Nicolboy/KICAD-C2000-powershield/doc/spec-devkit.md

# Devkit TMS320 C2000 — spécification consolidée

Remplace tous les documents de brochage antérieurs. Deux PCB à partir d'un seul
schéma, `DEVKIT_C2000_A` pour le F280037CSPM et `DEVKIT_C2000_B` pour le
F28P551SG5PM. Connecteur 2 × 28, entraxe 25,4 mm.

Les 64 broches sont attribuées et vérifiées sur les deux variantes.

**Divergence depuis le 2026-10-14 : ce document ne décrit plus que
`devkit_A_F280037`.** `devkit_B_F28P551` est passé à un connecteur
physiquement différent — deux embases 2×24 (une par domaine A/B), masse
quasi systématique en vis-à-vis de chaque signal, au lieu des deux
rangées 1×28 ci-dessous. Voir §2bis pour son brochage. Ce shield a
adopté le nouveau connecteur de devkit_B (`doc/decisions.md`, nouvelle
décision) : **devkit_A_F280037 n'est plus compatible avec ce shield**
tant qu'il n'aura pas reçu la même mise à jour — même logique de
divergence acceptée que celle déjà actée côté dépôt devkit
(`KICAD-C2000-devkit/doc/decisions.md` #13). Tout ce qui suit en §1 et §2
(hors §2bis) décrit l'ancien connecteur, toujours valable pour
devkit_A uniquement ; §3 à §8 (alimentation, JTAG, boot, LED,
mécanique) ne changent pas et s'appliquent aux deux cartes.

**Source amont pas encore mise à jour.** `KICAD-C2000-devkit/doc/
spec-devkit.md` (le dépôt d'origine) décrit encore l'ancien connecteur
2×28 pour les deux devkits — signalé ici, pas corrigé : hors périmètre
de ce dépôt.

---

## 1. Ce qui a changé depuis les premières versions

| Point | Avant | Maintenant |
|---|---|---|
| Cible | F28027 + deux 64 broches | **F280037 et F28P551 seuls** |
| Connecteur | 2 × 32, symétrique | **2 × 28, rangées symétriques** |
| Alimentation au connecteur | +3V3, +3V3_A, +5V | **+5V et masses uniquement** |
| Origine du 5 V | USB du devkit | **carte de puissance**, USB en secours |
| I2C | GPIO32 / GPIO33 | **GPIO8 / GPIO10**, mux 9 |
| Reset | bouton seul | **bouton + nRESET en B3** |
| Mode de boot | non résolu | **GPIO24 en B4**, BMSP unique par OTP |
| Voies shunt | une broche chacune | **dédoublées**, mesure + comparateur |
| LED | GPIO24 et GPIO32 | **GPIO40 et GPIO23**, communes aux deux, voir §5 |
| VREFLO | non exportée | **exportée**, paire avec VREFHI |
| Isolation, NCM3 | sur le shield | **carte de puissance** |

---

## 2. Attribution des 64 broches

### Rangée A — analogique, 1 × 28

| Pos | Signal | Broche | Canaux ADC / note |
|---|---|---|---|
| A1 | GND | 21 (VSSA) | — |
| A2 | Vin | 6 | A6 |
| A3 | Vout | 7 | B2/C6 |
| A4 | GND | — | — |
| A5 | V1 | 8 | A3/B3/C5 |
| A6 | Temp1 | 10 | A15/B9/C7 |
| A7 | GND | — | — |
| A8 | Temp2 | 11 | A14/B14/C4 |
| A9 | Iin | 12 | A11/B10/C0 |
| A10 | GND | — | — |
| A11 | Iout | 14 | A1/B7 |
| A12 | ADC_8 | 15 | A0/B15/C15 |
| A13 | GND | — | — |
| A14 | ADC_9 | 18 | A12/C1 |
| A15 | ADC_10 | 19 | A7/C3 |
| A16 | GND | — | — |
| A17 | ADC_11 | 20 | A8/B0/C11 |
| A18 | ADC_12 | 23 | A4/B8/C14 |
| A19 | GND | — | — |
| A20 | I_SHUNT1_MES | 13 | A5/B12/C2 |
| A21 | GND | — | — |
| A22 | I_SHUNT1_CMP | 9 | A2/B6/C9 - CMP1_HP0 |
| A23 | GND | — | — |
| A24 | I_SHUNT2_MES | 24 | A9/B4/C8 |
| A25 | GND | — | — |
| A26 | I_SHUNT2_CMP | 25 | A10/B1/C10 - CMP2_HP3 |
| A27 | VREF_ADC | 16 | VREFHI |
| A28 | VREFLO_SENSE | 17 | VREFLO |

Dix masses pour dix-huit signaux. **Chaque ligne de shunt est encadrée de masses
des deux côtés.** A1 rejoint VSSA (broche 21). VREF_ADC et VREFLO_SENSE forment
une paire de référence en fin de rangée.

### Rangée B — numérique, 1 × 28

| Pos | Signal | Broche | GPIO, fonction et mux |
|---|---|---|---|
| B1 | GND | 5/26/45/58 | — |
| B2 | +5V | — | — |
| B3 | nRESET | 3 | XRSn |
| B4 | BOOT_SEL | 35 | GPIO24 mux0 - BMSP1 |
| B5 | PWM1_A | 52 | GPIO0 EPWM1_A mux1 |
| B6 | PWM1_B | 51 | GPIO1 EPWM1_B mux1 |
| B7 | PWM2_A | 50 | GPIO2 EPWM2_A mux1 |
| B8 | PWM2_B | 49 | GPIO3 EPWM2_B mux1 |
| B9 | GND | — | — |
| B10 | PWM3_A | 48 | GPIO4 EPWM3_A mux1 |
| B11 | PWM3_B | 61 | GPIO5 EPWM3_B mux1 |
| B12 | PWM4_A | 64 | GPIO6 EPWM4_A mux1 |
| B13 | PWM4_B | 57 | GPIO7 EPWM4_B mux1 |
| B14 | GND | — | — |
| B15 | UART_TX | 1 | GPIO29 SCIA_TX mux1 |
| B16 | UART_RX | 2 | GPIO28 SCIA_RX mux1 |
| B17 | I2C_SCL | 47 | GPIO8 I2CA_SCL mux9 |
| B18 | I2C_SDA | 63 | GPIO10 I2CA_SDA mux9 |
| B19 | SPI_CLK | 41 | GPIO18 SPIA_CLK mux1 |
| B20 | SPI_SIMO | 33 | GPIO16 SPIA_SIMO mux1 |
| B21 | SPI_SOMI | 34 | GPIO17 SPIA_SOMI mux1 |
| B22 | SPI_STE | 42 | GPIO19 SPIA_STE mux1 |
| B23 | GND | — | — |
| B24 | CAN_TX | 29 | GPIO13 MCAN_TX mux3 |
| B25 | CAN_RX | 30 | GPIO12 MCAN_RX mux3 |
| B26 | CMP_OUT | 31 | GPIO11 OUTPUTXBAR7 mux3 |
| B27 | CLB_OUT | 56 | GPIO22 CLB_OUTPUTXBAR1 mux10 |
| B28 | GPIO_1 | 32 | GPIO33 mux0 - nFAULT |

Vingt-quatre signaux, quatre masses. Retirés par rapport à la version 24/32 :
CMP_OUT2, CLB_OUT2, GPIO_2 et GPIO_3 — les broches 62, 54, 53 et 55 deviennent
des pastilles de test. Un seul OUTPUTXBAR peut agréger plusieurs sources CMPSS,
et une sortie CLB suffit à l'observation.

### Hors connecteur

| Broche | PCB A — F280037 | PCB B — F28P551 |
|---|---|---|
| 36, 38 | TCK, TMS | idem |
| 37, 39 | TDO (GPIO37), TDI (GPIO35) | idem |
| 21 | VSSA | idem |
| 22 | VDDA 3,3 V | idem |
| 4, 44, 59 | VDD 1,2 V, découplage | idem |
| 43, 60 | VDDIO 3,3 V | idem |
| 5, 26, 45, 58 | VSS | idem |
| **27** | **VDD 1,2 V, découplage** | pastille (GPIO20) |
| **28** | **VDDIO 3,3 V** | pastille (GPIO21) |
| **40** | pastille (GPIO32) | pastille (GPIO32) |
| **46** | pastille (GPIO39) | **VREGENZ à VSS** |

Bilan : 41 broches au connecteur, 4 en JTAG, 4 en pastilles de test, plus
alimentations et LED.

---

## 2bis. `devkit_B_F28P551` seulement — nouveau connecteur, 2×24/2×24

Remplace §2 pour `devkit_B_F28P551` uniquement. Deux embases distinctes,
une par domaine, chacune 2×24 au pas 2,54 mm (entraxe 2,54 mm entre les
deux rangées d'une même embase) : **`J17` domaine A** (analogique),
**`J18` domaine B** (numérique) côté shield — mâles côté devkit, femelles
côté shield comme pour l'ancien connecteur. Même principe que les quatre
nappes shield↔cartes filles (`doc/nappes-shield.md`) : masse en
vis-à-vis de (quasiment) chaque signal, pour réduire l'inductance de
boucle — point de départ de ce changement, la rangée A ne portant plus
que six masses pour vingt-deux signaux après le routage CLB
(`KICAD-C2000-devkit/doc/decisions.md` #13).

Noms de net **identiques** à la rangée 1×28 qu'ils remplacent (`Vin_MCU`,
`PWM1_A_MCU`, `I_shunt1_MCU`, `5V_C2000`, etc.) — seules la position
physique et la répartition masse/signal changent, aucun renommage de
signal. Brochage complet et numérotation des broches KiCad :
`KICAD-C2000-devkit/doc/connecteur-v2-plan.md` (le plan d'origine) et
`lib/C2000_Devkit_Connectors.kicad_sym` (symboles `DEVKIT_C2000_A`/
`DEVKIT_C2000_B`, qui font autorité — ce `.md` ne les reproduit pas pour
éviter une troisième copie à tenir synchronisée).

**Risque non résolu, hérité du plan d'origine.** Rien n'empêche
mécaniquement d'intervertir les deux embases 2×24 d'un même domaine par
rapport à l'autre domaine (A ↔ B) — à vérifier/trancher avant tout
routage de la zone connecteur du shield.

---

## 3. Alimentation

Deux LDO 3,3 V, alimentés par le 5 V venant du connecteur ou de l'USB.

| Rail | Broches | Découplage |
|---|---|---|
| **VDDIO 3,3 V** — LDO n°1 | 43, 60 *(+28 sur PCB A)* | 100 nF par broche |
| **VDDA 3,3 V** — LDO n°2 | 22 | ≥ 2,2 µF + 100 nF |
| **VDD 1,2 V** — régulateur interne | 4, 44, 59 *(+27 sur PCB A)* | ≈ 10 µF au total, **broches reliées entre elles** |
| VREFHI / VREFLO | 16, 17 | **≥ 2,2 µF entre les deux**, au plus près |

**VDD n'est pas alimenté.** C'est la sortie du régulateur interne, à découpler
seulement. Sur le PCB B, VREGENZ (broche 46) est reliée à VSS pour activer ce
régulateur ; le F280037 en 64 PM non-Q n'a pas cette broche, son régulateur est
toujours actif.

**Pas d'OR-ing.** Deux sources possibles sur le rail 3,3 V — la sortie des LDO
depuis le +5 V de B2, et le 3,3 V entrant par le connecteur JTAG — mais aucun
arbitrage matériel : **ne pas alimenter des deux côtés à la fois**. Une Schottky
en série a été écartée, ses 0,3 V de chute amèneraient VDDIO à 3,0 V, sous le
seuil de brownout (SPRSPC5 §6.5).

**Masses** : VSS et VSSA réunies en un point unique près du boîtier, sous les
broches 21 et 26. Une seule masse au connecteur. Quatre couches recommandées,
pour un plan continu sous la zone analogique — c'est la version de référence.
Une variante 2 couches fabriquée à la maison sert au prototypage mécanique et
fonctionnel, sans prétention sur le bruit (`decisions.md` §12).

---

## 4. JTAG et reset

Embase **Tag-Connect TC2050**, 10 points au pas 1,27 mm, sans connecteur monté
côté carte. Brochage standard TI :

| Broche | Signal | Broche | Signal |
|---|---|---|---|
| 1 | GND | 6 | libre |
| 2 | TCK (36) | 7 | XRSn (3) |
| 3 | TDO (37) | 8 | libre |
| 4 | TMS (38) | 9 | libre |
| 5 | TDI (39) | 10 | VDDIO 3,3 V |

Les broches 6, 8 et 9 restent libres : la 6 porte TRSTn sur les cibles qui en
ont une, et ce composant n'en a pas.

**Ces MCU n'ont pas de broche TRSTn.** Vérifié dans SPRSPC5 §5.3 et §5.4, qui
l'écrit deux fois : « This device does not have a TRSTn pin ». Prévoir un
**rappel de 2,2 kΩ sur TMS vers VDDIO** : c'est lui qui maintient le JTAG en
reset pendant le fonctionnement normal. Ne pas reprendre le /TRST du schéma
F28027.

**Ne pas confondre TRST et nRST.** La broche 3 est XRSn, le reset du composant,
à relier au RESET du connecteur JTAG — drain ouvert, la sonde peut le tirer bas.
TRST est le reset de la chaîne JTAG, et il n'existe pas ici.

**Reset** : **cavalier 2 points au pas 2,54 mm** vers VSS sur XRSn (broche 3),
en remplacement du bouton-poussoir, avec rappel de 10 kΩ vers VDDIO et
condensateur de 100 nF vers VSS. La même broche sort en B3, attaquée **en
drain ouvert uniquement** par l'extérieur.

---

## 5. LED et sélection du boot

Les LED étaient initialement posées sur les **E/S non communes** — GPIO39 et
GPIO32 sur le PCB A, GPIO20 et GPIO21 sur le PCB B — pour que le connecteur
reste identique à 100 %. Ce placement a été abandonné : GPIO32 est l'une des
deux broches de sélection du boot et ne peut rien porter d'autre. Voir plus bas.

Les LED sont désormais **identiques sur les deux PCB**, sur deux broches
communes libérées du connecteur.

**Modes retenus : Flash seul.** Le chargement en RAM se fait par le JTAG, qui
arrête le cœur et écrit directement — il ne demande aucun mode de boot.

SPRSPC5 table 7-8, modes par défaut. Deux broches de sélection, pas une :

| Mode | GPIO24 (BMSP1) | GPIO32 (BMSP0) |
|---|---|---|
| Parallel IO | 0 | 0 |
| SCI / Wait Boot | 0 | 1 |
| CAN | 1 | 0 |
| **Flash** | **1** | **1** |

**Les deux broches demandent un rappel externe de 10 kΩ vers VDDIO.** SPRSPC5
§5.5 est formel : les rappels internes des GPIO sont désactivés au reset *et
pendant le boot*. Deux broches laissées flottantes donnent un mode de démarrage
indéterminé — et le tirage inclut Parallel IO, qui se met à piloter des broches.

Pas de cavalier : la table par défaut suffit, l'OTP n'a pas à être brûlé.
`BOOTPIN_CONFIG = 0x5AFF18FF` reste disponible si l'on veut plus tard libérer
GPIO32, mais ce n'est plus nécessaire.

### Les deux résistances de boot

| Repère | Valeur | Broche | Rôle |
|---|---|---|---|
| R3 | 10 kΩ → VDDIO | GPIO24 (35), sortie en B4 | Flash par défaut, **l'ESP32 la tire à 0** pour le boot SCI |
| R4 | 10 kΩ → VDDIO | GPIO32 (40) | fixe à 1, jamais piloté |

GPIO32 doit valoir 1 dans les deux modes utilisés — Flash `1 1` et SCI `0 1`.
C'est la seule broche des deux qui ne bouge jamais : **rien d'autre ne doit y
être connecté**, ni LED ni charge.

GPIO24 garde son rappel *et* reste pilotable depuis le connecteur : le rappel
impose Flash au repos, l'ESP32 force le boot SCI en tirant B4 à zéro. C'est le
chemin de mise à jour par liaison série décrit au §2.

**Prévoir une pastille de test sur GPIO24.** Si la Flash contient un programme
qui se plante trop tôt, c'est la seule porte de secours — une pince à la masse
et le composant repart en boot SCI.

### Les LED déménagent sur les pastilles de test

GPIO32 étant réservé au boot, et GPIO39 étant la seule autre E/S non commune du
PCB A, les deux LED sont reportées sur des broches **communes aux deux
boîtiers**, choisies parmi les quatre libérées du connecteur — celles qui ont le
moins de fonctions alternatives à sacrifier :

| Fonctions alternatives | Broche | GPIO | Affectation |
|---|---|---|---|
| 7 | 54 | GPIO23 | **LED rouge** |
| 9 | 53 | GPIO40 | **LED bleue** |
| 9 | 55 | GPIO41 | pastille de test |
| 12 | 62 | GPIO9 | pastille de test, la plus riche — à garder libre |

Les broches 53 et 54 sont contiguës, ce qui convient à une LED 3 mm à trois
broches. Conséquence utile : **les LED deviennent identiques sur les deux PCB**,
et GPIO32 comme GPIO39 sont rendus à leur rôle.

---

## 6. Mécanique

| | |
|---|---|
| Boîtier | LQFP64 PM, 10 × 10 mm corps, 12 mm hors tout |
| Empreinte KiCad | `Package_QFP:LQFP-64_10x10mm_P0.5mm` |
| Rangée A | embase mâle 1 × 28, pas 2,54 mm |
| Rangée B | embase mâle 1 × 28, pas 2,54 mm |
| **Entraxe des rangées** | **25,4 mm** (10 pas) |
| Longueur | 28 × 2,54 = 71,1 mm |
| Carte | ≈ 75 × 28 mm, 4 couches (variante 2 couches en prototype) |
| Horloge | interne, X1/X2 non câblés — GPIO18/GPIO19 libres pour le SPI |

Embases mâles sous le devkit, femelles sur le shield, pour un retrait sans
outil. Le devkit se place **au-dessus de la zone commande** du shield.

### Détrompage

Les deux rangées faisant désormais la même longueur, la géométrie n'assure plus
le détrompage. Prévoir une clé : position obturée aux extrémités, ou ergot sur
le support. Sans elle, un montage à l'envers met le +5V de B2 sur VSSA.

### Cohabitation avec l'ESP32 sur le shield

L'ESP32-C6-DevKitC-1 a ses propres cotes, relevées dans son plan d'implantation
v1.2 : **entraxe 22,86 mm**, carte 51,8 × 25,4 mm, embases J1 et J3 au pas
2,54 mm. Le 1,27 mm mentionné sur le plan concerne J2 et J4, l'empreinte du
module, sans objet ici.

Le shield porte donc **deux entraxes différents** : 25,4 mm pour le devkit C2000,
22,86 mm pour l'ESP32. Deux références de support à approvisionner, mais le
dégagement de routage autour du LQFP64 est préservé — c'est le choix retenu.

## 7. Nomenclature indicative

| Fonction | Composant |
|---|---|
| MCU | TMS320F280037CSPM ou TMS320F28P551SG5PM |
| LDO VDDIO | 3,3 V, ≥ 300 mA, faible bruit |
| LDO VDDA | 3,3 V, ≥ 100 mA, **faible bruit prioritaire** |
| OR-ing | 2 × Schottky, chute faible |
| USB | connecteur seul, alimentation de secours en développement |
| JTAG | embase Tag-Connect TC2050, 10 points, pas 1,27 mm |
| Reset | poussoir tactile + 10 kΩ + 100 nF |
| LED | 2 × 0603, résistances selon 4 mA |
| Découplage | 100 nF par broche d'alimentation, 10 µF sur VDD, 2,2 µF sur VDDA, 2,2 µF entre VREFHI et VREFLO |
| Cavalier boot | 1 × 3 points, pas 2,54 mm |

---

## 8. Points à trancher avant routage

- Valeur de VREFHI en mode externe : 2,5 V ou 3,0 V, selon la pleine échelle des
  AMC ratiométriques. Plage admissible, impédance de source et courant absorbé
  restent `à vérifier`.
- État au reset de GPIO40 et GPIO23, pour que les LED ne s'allument pas pendant
  le démarrage. Sans objet pour le boot — ces broches n'y participent plus —
  mais une LED allumée au reset se lit comme un défaut.
- Courant de sortie de GPIO40 et GPIO23 : le mode 20 mA du F28P551
  (`IO_DRVSEL`) n'est pas vérifié dans SPRSPC5, considérer 4 mA. Avec 1 kΩ sur
  la cathode commune, la LED tire environ 1,3 mA — largement dans la marge.
- Placement exact du point de jonction VSS/VSSA par rapport aux broches 21 et 26
  et à l'arrivée du +5V en B2.
- Choix de l'entraxe si vous préférez 22,86 mm : vérifier qu'il reste de la place
  pour les deux LDO, l'USB et l'embase JTAG autour d'un boîtier de 12 mm.
