Nicolboy/KICAD-C2000-powershield/doc/decisions.md

# Décisions de conception

Ce document rassemble les choix qui ont l'air d'inefficacités et n'en sont pas.
Chacun a coûté quelque chose — une broche, une piste, un composant — en échange
d'une propriété qu'on ne voulait pas perdre.

Il existe parce que ces choix sont exactement ceux qu'on « optimise » six mois
plus tard, faute de se rappeler ce qu'ils protégeaient. Chaque entrée dit donc
trois choses : la décision, sa raison, et ce qui casse si on la défait.

Ce fichier fait autorité sur les décisions. Le brochage, lui, est décrit dans
[`spec-devkit.md`](spec-devkit.md), les nappes dans
[`nappes-shield.md`](nappes-shield.md).

---

## 1. Le connecteur est identique sur les deux MCU, et ça se paie

**Décision.** Les deux devkits, F280037 et F28P551, exposent le même connecteur
— 56 positions sur 56. Pour y parvenir, les LED sont posées sur les
entrées/sorties **non communes** aux deux boîtiers.

**Pourquoi.** Poser une LED est le besoin le plus trivial de la carte ; c'est
donc lui qu'on sacrifie. En le reléguant sur les broches qui divergent, on
libère toutes les broches communes pour ce qui traverse le connecteur. Le shield
devient indifférent au MCU monté dessus.

**Ce qui casse.** Déplacer une LED sur une broche commune la retire du domaine
partagé et rompt l'interchangeabilité. Il faudrait alors deux shields.

Les quatre divergences, toutes locales à la carte devkit :

| Broche | F280037 | F28P551 |
|---|---|---|
| 27 | VDD 1,2 V, découplage | LED bleue (GPIO20) |
| 28 | VDDIO 3,3 V | LED rouge (GPIO21) |
| 40 | LED rouge (GPIO32) | pastille de test |
| 46 | LED bleue (GPIO39) | VREGENZ à VSS |

La cause profonde est le régulateur 1,2 V : le F28P551 a le sien en interne,
activé par VREGENZ à VSS ; le F280037 en 64 PM non-Q n'a pas cette broche et
demande un LDO supplémentaire. **Toute divergence hors de cette liste est une
erreur.**

---

## 2. PWM3 et PWM4 restent en réserve, et restent des PWM

**Décision.** Les positions B10 à B13 portent `PWM3_A/B` et `PWM4_A/B`, câblées
de bout en bout sur la nappe PWM alors que rien ne s'en sert encore.

**Pourquoi.** Ce sont les deux seules paires complémentaires HRPWM avec temps
mort matériel encore disponibles. La nappe PWM est aussi la seule à alternance
signal/masse pensée pour des fronts rapides — un PWM posé ailleurs n'aurait pas
le même environnement.

**Ce qui casse.** Les réaffecter à une commande lente sous prétexte qu'elles
sont libres consomme une ressource rare pour un besoin que n'importe quel GPIO
satisfait. Les commandes lentes du shield — `Stage1_EN`, `Stage2_EN`, `HV_EN`,
`Discharge` — ont leur propre nappe GPIO, faite pour elles.

---

## 3. Alternance signal / masse stricte 1:1 sur les quatre nappes

**Décision.** Un conducteur sur deux est une masse, sur les quatre nappes. Aucune
ligne d'alimentation ne circule dedans.

**Pourquoi.** C'est de la mesure de courant. Le retour de chaque signal longe le
signal lui-même, la boucle reste petite, la diaphonie s'effondre.

**Ce qui casse.** Récupérer une masse pour y passer un signal de plus donne un
conducteur gratuit et une mesure qui dérive sans qu'on sache pourquoi.

**Exception, voulue.** `VREF_ADC` et `VREFLO_SENSE` sont **adjacents** — A27/A28
au connecteur, positions 6 et 7 de la nappe ADC-2. C'est une paire de référence,
pas deux signaux indépendants : la conversion est ramenée à
(VIN − VREFLO) / (VREFHI − VREFLO). Les séparer par une masse rendrait la mesure
différentielle fausse au lieu de la protéger.

C'est aussi la raison pour laquelle le **+5 V a son propre connecteur**. Les
500 mA de la commande n'ont pas à partager leur retour avec les masses de
référence des voies ADC : c'était précisément le mécanisme d'erreur à éviter.

---

## 4. Chaque shunt sort deux fois : `_MES` filtré, `_CMP` direct

**Décision.** La sortie de chaque AMC0300R est reprise deux fois sur le shield.
Un chemin filtré vers la voie de mesure, un chemin direct vers le comparateur.

**Pourquoi.** Le chemin `_CMP` attaque le CMPSS sans filtre anti-repliement : la
Trip Zone se déclenche sans le retard qu'introduirait le filtre. Et les deux
chemins étant indépendants, un défaut sur le filtre ne désarme pas la
protection.

**Ce qui casse.** Fusionner les deux chemins, ou insérer un filtre sur `_CMP`,
remet le retard dans la boucle de protection et recrée le point de défaillance
unique. Contrainte à respecter : Rs ≤ 50 Ω sur le chemin comparateur.

| Voie | Broche | CMPSS | Rôle |
|---|---|---|---|
| `I_SHUNT1_CMP` | 9 | CMP1_HP0 | seuil DAC interne → Trip Zone, sans filtre |
| `I_SHUNT1_MES` | 13 | — | mesure ADC, filtrée |
| `I_SHUNT2_CMP` | 25 | CMP2_HP3 | chemin direct |
| `I_SHUNT2_MES` | 24 | — | mesure ADC, filtrée |

---

## 5. Les 16 voies ADC sortent toutes, pour 9 nécessaires

**Décision.** Toutes les voies ADC du boîtier sont exportées. Les cinq libres —
A12, A14, A15, A17, A18 — sont câblées jusqu'aux cinq réserves de la nappe
ADC-2, dans le même ordre.

**Pourquoi.** Une voie de mesure ajoutée plus tard se raccorde de bout en bout
sans retoucher une seule carte. La marge est volontaire et son coût est nul :
ces broches ne servaient à rien d'autre.

**Ce qui casse.** « Récupérer » ces positions pour autre chose économise cinq
pistes et transforme le moindre ajout de mesure en nouvelle révision des trois
cartes.

---

## 6. nRESET en drain ouvert uniquement

**Décision.** La ligne `nRESET` (B3) n'est jamais attaquée en push-pull depuis
le shield.

**Pourquoi.** Le MCU tire lui-même cette ligne à zéro sur watchdog et sur
brownout. C'est une ligne à plusieurs maîtres.

**Ce qui casse.** Une sortie push-pull côté shield met en conflit deux étages
lorsque le MCU se réinitialise — courant de court-circuit, et un reset qui
n'aboutit pas.

---

## 7. Point de jonction VSS/VSSA unique

**Décision.** Les masses numérique et analogique se rejoignent en **un seul
point**, près du boîtier, et une seule masse remonte au connecteur.

**Pourquoi.** Deux jonctions créent une boucle, et la boucle capte.

---

## 8. `GND` et `+5V` en `power_in`, avec un `PWR_FLAG` par net

**Décision.** Les broches d'alimentation du connecteur gardent le type
électrique `power_in`, et chaque net porte un `PWR_FLAG`.

**Pourquoi.** Le connecteur alimente bien la carte, mais c'est le brochage qui
fait autorité et il les décrit en entrée. Un net composé uniquement de
`power_in` fait lever `power_pin_not_driven` à l'ERC, même avec un symbole de
masse dessus : le `PWR_FLAG` répond à ça sans toucher au type électrique.

**Ce qui casse.** Passer les broches en `power_out` fait taire l'ERC en mentant
sur la nature du connecteur. C'est la documentation qu'on dégrade pour obtenir
un rapport propre.

---

## 9. Le shield s'édite à la main, les devkits se régénèrent

**Décision.** Les trois schémas n'ont pas le même statut, et il faut le savoir
avant d'ouvrir KiCad :

| Schéma | Édition |
|---|---|
| `devkit_A_F280037.kicad_sch` | **jetable** — reconstruit par `gen_devkit.py` |
| `devkit_B_F28P551.kicad_sch` | **jetable** — idem |
| `shield.kicad_sch` | **édité à la main**, c'est le fichier de travail |

**Pourquoi.** Le générateur du shield amenait à la ligne de départ — connecteurs
posés, alimentations câblées, un `PWR_FLAG` par net — puis s'arrêtait : le
routage des signaux demande des choix de conception qui n'appartiennent pas à un
script. Ce travail commence maintenant, et il se fait dans KiCad.

`gen_shield.py` a donc été **retiré du dépôt**. Il écrivait `shield.kicad_sch`
en entier et l'aurait écrasé au premier `--force`, sans avertissement. Un
amorçage à usage unique qui traîne dans l'arborescence est un piège, pas un
outil. Il reste dans l'historique git (commit `31ecd50`) si l'on veut repartir
d'une feuille blanche.

**Ce qui casse.** Retoucher un schéma de devkit à la main : la modification
disparaît au prochain `gen_devkit.py --force`. Ce qui doit survivre se modifie
dans `src/` ou dans le générateur.

---

## 10. Les schémas source des devkits sont versionnés dans `src/`

**Décision.** `src/devkit_c2000_A_F280037.kicad_sch` et son homologue B sont
suivis par git. `imports/` reste la boîte de réception, ignorée.

**Pourquoi.** `gen_devkit.py` ne fabrique pas ces schémas : il les recopie et
les retouche — nom de projet, symbole MCU carré, recalage sur la grille de
1,27 mm. La vraie source, c'était donc un dossier non versionné. Un dépôt dont
l'argument est que tout se régénère depuis une source ne peut pas laisser cette
source hors de lui-même.

**Ce qui casse.** Remettre `PROJECTS` sur `imports/` : le jour où ce dossier
disparaît, les deux devkits ne sont plus régénérables et rien ne le signale
avant qu'on essaie.

---

## 11. Deux rangées égales de 28, et une clé mécanique obligatoire

**Décision.** Le connecteur fait 28 + 28, pas 24 + 32. Quatre signaux ont été
retirés pour que les deux rangées tiennent : `CMP_OUT2`, `CLB_OUT2`, `GPIO_2` et
`GPIO_3`. Les broches MCU correspondantes — 62, 54, 53 et 55 — deviennent des
pastilles de test. `CMP_OUT1` et `CLB_OUT1` perdent leur indice.

**Pourquoi.** Deux rangées identiques, c'est un seul type de support, une seule
référence à approvisionner, et un dessin de carte symétrique.

**Ce qui casse — et c'est le point à ne pas oublier.** L'asymétrie 24/32
assurait le détrompage toute seule : une rangée de 24 n'entre pas dans un
support de 32. Ce n'est plus le cas. **Il faut une clé mécanique explicite** —
position obturée aux extrémités, ou ergot sur le support. Sans elle, une carte
branchée à l'envers met le +5 V de B2 sur une entrée analogique.

C'est la contrainte la plus facile à oublier et la plus coûteuse à découvrir
après fabrication.

**Trace.** Le basculement date du 2026-08-30, vers 15 h 25. `doc/spec-devkit.md`
a été recalé depuis `lib/C2000_Devkit_Connectors.kicad_sym` — qui faisait
seule autorité pendant l'intervalle — et vérifié position par position, 56 sur
56.

---

## 12. Deux versions de PCB : 2 couches maison, 4 couches externes

**Décision.** Chaque carte est dessinée en deux variantes de fabrication :

| | 2 couches | 4 couches |
|---|---|---|
| Fabrication | maison | externe |
| Pistes mini | 1 mm | au choix du fabricant |
| Vias | 2 mm, perçage 0,8 mm | standard |
| Plan de masse | fragmenté, au mieux | **continu en couche 2** |
| Statut | prototype, mise au point | version de référence |

**Pourquoi.** La version maison permet d'itérer en quelques heures au lieu de
quelques semaines, et de valider la mécanique — encombrements, entraxes,
détrompage — avant d'engager un tirage externe.

**Ce qui ne change pas d'une version à l'autre.** Le schéma, le brochage, le
connecteur. Les deux variantes sortent du **même `.kicad_sch`** : seule la
géométrie du PCB diffère. Dès qu'un signal change d'une version à l'autre, ce
ne sont plus deux variantes mais deux cartes, et la comparaison des mesures ne
veut plus rien dire.

**Ce qu'il faut savoir de la version 2 couches.** Sans plan de masse continu
sous la zone analogique, les retours de courant partagent des chemins et la
mesure en pâtit — c'est l'objet même de la décision §3. Attendre d'elle une
validation fonctionnelle et mécanique, **pas** une caractérisation en bruit ni
un chiffre de précision : ils ne se transposeraient pas à la version 4 couches.

**Conséquence sur l'outillage.** Les règles de conception écrites par
`kicad_gen.py` — piste 1 mm, via 2 mm, perçage 0,8 mm — sont celles de la
fabrication maison. Le projet 4 couches demandera son propre jeu de règles, bien
plus fin. Ne pas appliquer les contraintes maison à la version externe : ce
serait payer un fabricant pour des pistes de 1 mm.

---

## 13. La conversion isolée migre sur le shield, deux NCM3S1205MC séparés, masses secondaires reliées en un point

**Décision.** La carte de puissance séparée (qui portait toute la
conversion et toute l'isolation dans `KICAD-C2000-devkit`) disparaît. Le shield
reçoit directement le 11-25V externe et produit ses propres rails isolés.
Chaque carte DC/DC enfichable porte désormais l'isolation que *sa* fonction
exige — plus de point central qui isole pour tout le monde.

**Pourquoi.** Décision de conception de l'utilisateur, pas une optimisation
de ma part : la carte de puissance figée ne convenait qu'à une seule
fonction de conversion ; des cartes DC/DC enfichables, chacune avec son
isolation propre, couvrent plusieurs fonctions sans redessiner le shield à
chaque fois.

**Composant retenu : NCM3S1205MC-R7** (Murata NCM3 series,
`composants-datasheets/datasheets/isolation/KDC_NCM3.pdf` p.1) — entrée
9-36V (couvre 11-25V), sortie 5V/600mA max (3W), isolation 5000VAC
renforcée. Écarté avant lui : l'OKI-78SR (titre du datasheet : *"Non-Isolated
Switching Regulator DC-DC"*, masses Vin/Vout communes) — ne fait pas ce
qu'on lui demandait.

**Deux exemplaires, pas un seul partagé.** Un NCM3S1205MC pour le domaine
"numérique" (les deux devkits + l'OLED), un second dédié au domaine
"isolation E/S" (LDO 3,3V vers les nappes). Objectif : ne pas coupler le
bruit du CPU/de la radio Wi-Fi de l'ESP32 sur l'alimentation de
l'isolation, et donner à chaque domaine son propre budget de 600mA plutôt
qu'un budget unique partagé entre tout le monde.

**Coupure par destination — trois cavaliers, pas un.** Cavalier C2000,
cavalier ESP32, cavalier E/S — chacun 2 points 2,54mm, côté régulé (5V ou
3,3V), en aval de leur module. Le 11-25V brut reste toujours présent aux
deux NCM3S1205MC, non coupé : avec le module #1 partagé entre les deux
devkits, une coupure individuelle n'a de sens que côté régulé.

**Masses secondaires des deux NCM3S1205MC : reliées, en un point unique —
pas laissées séparées.** Premier réflexe (le mien), corrigé par
l'utilisateur : séparer les deux masses semblait cohérent avec la
séparation de bruit visée par les deux modules, mais le 3V3_ISO alimente le
côté **commande/non-isolé** des isolateurs des cartes DC/DC — c'est ce
côté-là que le C2000 doit pouvoir lire avec une référence commune, sinon le
signal de sortie de l'isolateur n'a plus de référence valable une fois relu
côté numérique. L'isolation galvanique réelle se fait à l'intérieur de
chaque puce isolatrice (AMC03xx etc.), pas entre les deux domaines du
shield. Un point unique (étoile), pas deux jonctions séparées : même
principe que le point de jonction VSS/VSSA unique déjà utilisé sur les
devkits — deux jonctions créeraient une boucle de masse.

**3V3_ISO reste un LDO fixe simple, pas asservi à VDDA/VREF.** Idée
soulevée puis écartée : faire porter la précision ADC des cartes DC/DC par
l'alimentation de l'isolateur plutôt que par sa référence. Un LDO (±1-2%
typique) n'a pas la stabilité d'une vraie référence — ce n'est pas le bon
outil. La vraie solution, déjà disponible sans rien ajouter : les
isolateurs ratiométriques (suffixe "R", type AMC0311R/AMC0302R) ont une
broche REFIN dédiée, à raccorder sur VREF_ADC (déjà présent sur la nappe
ADC-2) — pas sur 3V3_ISO. Protection de sortie prévue malgré tout : une
zener entre 3V3_ISO et masse, en crowbar contre une panne du LDO
(pass-transistor qui lâche et laisse passer le 5V d'entrée vers la sortie —
mode de panne déjà vécu), pas de l'ESD générique.

**2×10 IDC, pas 2×8 breakaway.** Les quatre nappes doivent désormais porter
GND + 3V3_ISO en plus de leurs 16 positions existantes (inchangées). Les
embases IDC à sertir avec détrompeur existent en tailles standard de nappe
(10/14/16/20/26/34 voies) ; 2×9 (18 voies, le minimum strict) n'en est pas
une, 2×10 l'est — et laisse une réserve gratuite, cohérent avec la décision
#5 déjà actée (marge ADC gratuite).

**Ce qui casse.** Relier les masses des deux NCM3S1205MC en plusieurs
points (pas un seul) réintroduit une boucle de masse — c'est précisément
ce que la décision #7 (point de jonction unique) existe pour éviter, ici
appliqué au même problème à un autre endroit du schéma. Asservir 3V3_ISO à
VDDA/VREF pour « résoudre » la précision ADC masque le vrai problème
(REFIN mal câblé sur la carte DC/DC) sans le résoudre, et dégrade la
stabilité du rail d'alimentation de l'isolation pour tout le monde.

## 14. GND/3V3_ISO des nappes en positions 1/2 (pas 17/18), et correction d'un bug de signe Y sur les labels de connecteur

**Décision.** Sur les 4 nappes, `3V3_ISO` passe en position 1 et `GND` en
position 2 (au lieu de 17/18, ajoutées en fin par la décision #13). Les 16
positions signal/masse existantes, inchangées de nom, se décalent
mécaniquement de 2 crans (ancienne position *n* → nouvelle position *n+2*).
Les anciennes positions 17/18 disparaissent, leur rôle repris par les
nouvelles 1/2.

**Pourquoi.** Décision explicite de l'utilisateur, pas une optimisation de
ma part : il a fourni l'image d'un connecteur de référence (`CpuOut1` /
`CTRL_C2000_OUT`, dans `alim-flyback-filament/isolation.kicad_sch` — projet
routé, prêt pour production, lu mais jamais édité) où les deux broches
d'alimentation (`3V3_CTRL`, `GND_CTRL`) occupent les positions 1 et 2,
avant tout signal. Convention à reprendre pour les nappes du shield plutôt
que l'ajout en fin de connecteur retenu dans la décision #13.

**Bug de signe Y trouvé en vérifiant la connexion des labels.** En
positionnant les labels des broches BAT54S ajoutées aujourd'hui, l'ERC a
révélé qu'aucun label de connecteur posé plus tôt dans la session
(nappes, rangées A/B devkit C2000, J1/J3 ESP32) ne touchait réellement sa
broche. KiCad inverse l'axe Y entre les coordonnées locales d'un symbole
(bibliothèque, Y vers le haut) et son placement sur le schéma (Y vers le
bas) : la formule correcte est `monde_y = instance_y − local_y` (le signe
d'addition que j'utilisais était faux), `monde_x = instance_x + local_x`
reste correct. Confirmé en comparant mes positions aux coordonnées réelles
que `kicad-cli sch erc` rapporte pour chaque broche (ex. BAT54S D11 Pin 3,
réellement à (250.00, 11.11) contre (250.00, 28.89) avant correction).
Labels régénérés sur `connecteurs_nappe.kicad_sch` et
`connecteur_devkit.kicad_sch` avec la formule corrigée et le style du
connecteur de référence (`shape bidirectional`, `rotation 180`,
`justify right`), uniformément.

**Ce qui casse.** Toute nouvelle génération de labels sur un connecteur
dans ce dépôt doit utiliser `monde_y = instance_y − local_y`, pas l'inverse
— le bug est facile à reproduire car `kicad-cli sch erc` ne le signale
que comme `label_dangling`/`pin_not_connected` (pas une erreur explicite
de coordonnées), à vérifier systématiquement en croisant quelques broches
avec les coordonnées réelles du rapport ERC avant de considérer un lot de
labels comme posé.

---

## 15. Embase OLED en IDC 2 × 8 détrompée, empreintes assignées à tout le projet

**Décision.** Ajout du connecteur `OLED_SPI_2x8` (J10) sur
`connecteur_devkit.kicad_sch` : IDC 2 × 8 à sertir, détrompeur de série,
même famille que les nappes DC/DC mais une taille en dessous (16 broches
contre 20). Brochage repris tel quel du plan constructeur de l'écran
`ER-OLEDM032-1B` (voir `nappes-shield.md`) ; les labels `OLED_CS/RST/DC/
SCK/MOSI` existaient déjà sur les broches natives SPI de l'ESP32, seule
l'embase physique manquait. Broche 7 non étiquetée sur le plan constructeur
fourni : laissée en `NC` par prudence plutôt que supposée masse — à
reconfirmer si le datasheet complet devient disponible.

**Mise à jour.** Broche 7 reliée à `GND` (label global posé sur la broche,
exactement comme la broche 8 adjacente) — décision explicite de
l'utilisateur, plus un point ouvert. `no_connect_connected` apparaît
désormais dans l'ERC pour cette broche (la pin reste typée `NC` dans le
symbole `OLED_SPI_2x8`) : avertissement attendu, accepté au même titre que
les autres de cette famille, pas une erreur à corriger.

À la même occasion, assignation d'une empreinte à tous les composants du
projet qui n'en avaient pas (R/C en 0805, BAT54S en SOT-23, connecteurs
2 broches génériques — cavaliers et alimentation — en PinHeader 1×02,
zener de protection en SMC), et création de l'empreinte custom
`lib/NCM3S1205MC.kicad_mod` d'après les cotes du datasheet Murata
(page « Recommended Footprint Details »), ce module n'ayant pas
d'empreinte standard dans les bibliothèques KiCad.

**Pourquoi.** L'export vers le PCB échouait sur tous les composants
(« empreinte non assignée ») : aucune empreinte n'avait encore été choisie
pour ce premier passage PCB, en dehors des connecteurs devkit/ESP32/nappe
qui en portaient déjà une par défaut dans leur symbole.

**Ce qui casse.** Les cotes du NCM3S1205MC comportent une ambiguïté : les
deux sous-cotes horizontales (8,00 / 8,50 mm, barrière d'isolement) ne se
recoupent pas proprement avec la cote totale de 22,00 mm à partir de
l'image seule. Le placement des 4 pastilles utilise uniquement la largeur
totale et la largeur de pastille (valeurs non ambiguës) ; la barrière
d'isolement n'est qu'une zone de sérigraphie, sans effet électrique. À
vérifier visuellement dans l'éditeur d'empreinte PCB contre la page 10 du
datasheet avant fabrication.

---

## 16. Filtre EMC NCM3S1205MC : étage d'entrée posé, étage de sortie volontairement omis

**Décision.** Sur `dc.kicad_sch`, ajout de l'étage d'entrée du filtre EMC
recommandé par le datasheet (p.8, « EMC Filtering and Spectra ») pour
chaque instance : L1/L2 (22 µH, série sur VIN_PWR/retour) + C26/C27
(22 µF) + C28 (220 pF) pour U2, L3/L4 + C31/C32 + C33 pour U3 — composants
caractérisés dans `composants-datasheets/data/shield-power/ncm3s1205mc.yaml`
(`recommended_components`). L'étage de sortie (C4/C5, 470 pF, un par
instance soit C29/C30 et C34/C35) a été posé puis retiré : ni ces deux
paires de composants ni leurs labels ne figurent dans le schéma final.

**Pourquoi.** Le NCM3S1205MC est choisi spécifiquement pour sa faible
capacité d'entrée/sortie — paramètre déterminant pour une alimentation
isolée destinée à des lignes qui traversent la barrière. Rajouter 470 pF
en parallèle côté sortie va à l'encontre de ce choix, même si ces deux
condensateurs ne pontent pas la barrière primaire/secondaire (vérifié par
coordonnées : C29/C30 sont posés entre `5V_ISO` et `GND`, C34/C35 entre
`5V_NUM` et `GND`, tous deux cote secondaire uniquement — donc sans effet
sur la capacité primaire/secondaire proprement dite, mais la décision
porte sur le principe, pas seulement sur la topologie).

**Ce qui casse.** Le datasheet qualifie ces 470 pF comme faisant partie du
filtre EMC nécessaire pour la conformité EN 55032 Classe B — leur absence
n'a pas été compensée par une autre topologie. Si une non-conformité EMC
apparaît en essai, ce point est le premier candidat à rouvrir, en
réévaluant alors le compromis capacité/conformité plutôt qu'en les
rajoutant par défaut.

---

## 17. Routage des quatre nappes, reséquencement signal/masse, et deux nappes supplémentaires (GPIO-2, COM)

**Décision.** Les connecteurs J1-J4 (ADC-1, ADC-2, PWM, GPIO) n'avaient
jusqu'ici que leurs broches d'alimentation câblées (`3V3_ISO`/`GND` —
vérifié : exactement 40 `global_label` dans `connecteurs_nappe.kicad_sch`,
10 par connecteur, zéro signal réel). Cette décision couvre trois choses à
la fois : (a) le câblage des signaux restés en souffrance depuis la
decision #9, (b) un changement de convention de position qui gagne une
broche signal par connecteur sans changer sa taille, (c) l'ajout de deux
connecteurs pour couvrir les besoins génériques (logique de réserve, bus
de communication) annoncés par l'utilisateur mais absents des quatre
nappes d'origine.

**(a) Câblage.** Chaque broche signal de J1-J4 reçoit maintenant le
`global_label` que la documentation promettait depuis la decision #13
(`Vin`, `PWM1_A`, `Stage1_EN`, etc.) — toujours aucune ligne de wire,
uniquement des labels posés aux coordonnées réelles de chaque broche
(vérifié par `kicad-cli sch erc`, piège d'inversion d'axe Y de la decision
#14 surveillé).

**(b) Reséquencement signal (impair) / masse (pair), à partir de la
broche 3.** Avant : position 1 `3V3_ISO`, 2 `GND`, 3 `GND` (deuxième masse
consécutive), puis alternance à partir de 4 — 8 emplacements signal
exploitables sur 20 broches, les positions 19/20 jamais définies. Après :
position 1 `3V3_ISO`, 2 `GND`, puis strictement signal sur les impairs (3,
5, 7… 19) et masse sur les pairs (4, 6… 20) — 9 emplacements signal, les
20 broches toutes définies. Exception volontaire, déjà actée (decision
#3) : la paire de référence `VREF_ADC`/`VREFLO_SENSE` (ADC-2) reste
adjacente, en 7/8, la position 8 cédant sa masse pour cette seule paire.

**Pourquoi reséquencer plutôt qu'agrandir le connecteur.** Mon premier jet
proposait un connecteur 2×13 (26 voies, palier standard suivant) pour
donner de la marge à GPIO et à un nouveau connecteur de bus. Écarté par
l'utilisateur : pas de 2×13 en stock, tout doit rester en 2×10. Le
reséquencement donne la même marge (une broche signal de plus par
connecteur) sans changer de référence de connecteur.

**(c) Deux connecteurs de plus plutôt qu'un connecteur agrandi : GPIO-1 /
GPIO-2, et COM.** But générique annoncé par l'utilisateur : le devkit+
shield doit pouvoir piloter n'importe quelle carte fille future (PWM,
logique, ADC, bus I2C/SPI/UART/CAN/Modbus), pas seulement les deux cartes
connues aujourd'hui (convertisseur 0-500V, `alim-flyback-filament`). Deux
besoins non couverts par les quatre nappes d'origine :

- **Logique de réserve.** GPIO (renommé GPIO-1) est désormais plein — 8
  signaux d'origine + `CLB_OUT` (broche B27 du connecteur devkit,
  orpheline jusqu'ici, aucune nappe ne l'exportait) = 9 emplacements sur
  9. Une carte future dont le besoin en E/S logique ne ressemble à rien
  d'anticipé ici n'a nulle part où se brancher sans **GPIO-2**, un
  sixième connecteur 2×10 entièrement en réserve.
- **Bus de communication.** `UART_TX`/`RX`, `SPI_CLK`/`SIMO`/`SOMI`/`STE`,
  `CAN_TX`/`RX` existent déjà comme `global_label` sur le connecteur
  devkit (`connecteur_devkit.kicad_sch`) mais n'étaient câblés sur aucune
  nappe — **COM**, cinquième connecteur neuf, les expose en logique 3,3V
  brute (8 signaux, 1 réserve). Les transceivers CAN et RS-485/Modbus
  restent sur la carte fille qui en a besoin (décision de l'utilisateur,
  cohérente avec la decision #13 : chaque carte porte l'isolation que *sa*
  fonction exige) — le shield ne route jamais de différentiel.

**Une carte fille ne peuple que les connecteurs dont elle a besoin.**
Précision explicite de l'utilisateur : les six connecteurs ne sont pas un
paquet tout-ou-rien. Exemple immédiat : le convertisseur 0-500V utilise
ADC-1, ADC-2, PWM en entier et seulement GPIO-1 — ni GPIO-2, ni COM. Un
connecteur non peuplé côté carte fille ne coûte rien côté shield.

**Désignateurs J13/J14, pas J5/J6.** `used_designators` dans
`shield.kicad_pro` réservait déjà J1-J9 et J11-J12 (connecteurs devkit,
ESP32, OLED J10, alimentation) avant même de toucher à ce fichier —
confirmé par une recherche `property "Reference" "J\d+"` sur tous les
schémas du projet. GPIO-2 et COM prennent J13 et J14 pour ne pas entrer en
collision avec un composant existant ailleurs dans le projet.

**Bibliothèque externe synchronisée.** `lib/C2000_Devkit_Connectors.kicad_sym`
mis à jour en parallèle de la copie embarquée dans
`connecteurs_nappe.kicad_sch` (symboles `NAPPE_ADC1`/`ADC2`/`PWM` avec le
nouveau séquencement, `NAPPE_GPIO` renommé `NAPPE_GPIO1`, `NAPPE_GPIO2` et
`NAPPE_COM` ajoutés) — sinon `kicad-cli sch erc` lève `lib_symbol_issues`
(symbole introuvable en bibliothèque), et toute « Update Symbols from
Library » future écraserait silencieusement le travail de cette décision.

**Ce qui casse.** Reproduire le reséquencement sur un connecteur qui
n'existe pas encore sans relire cette décision referait l'erreur
d'origine (masse en double avant le premier signal). Ajouter un signal à
GPIO-1 ou à COM sans vérifier qu'une réserve existe déjà (`réserve
GPIO2-*`/`réserve COM-1`) revalide une nouvelle révision du connecteur au
lieu de consommer la marge déjà prévue.

**Point relevé, non résolu ici — hors périmètre.** `Stage1_EN`,
`Stage2_EN`, `HV_EN` et `Discharge` (GPIO-1) ne sont reliés à aucune
broche du connecteur devkit : ces noms viennent de l'ancien firmware
TMS320F28027 (GPIO16/17/32/5), et la nouvelle carte de conversion 0-500V
— nouveau MCU, projet séparé — n'a pas encore choisi ses broches. ERC :
`isolated_pin_label` sur les quatre, attendu, à lever quand ce choix sera
fait. De même, les réserves ADC (`ADC_8` à `ADC_12` côté connecteur
devkit) restent elles aussi isolées, un gap pré-existant à cette session.

---

## 18. Découplage 100 nF sur chacune des six nappes

**Décision.** Un condensateur 100 nF entre `3V3_ISO` et `GND`, posé au
plus près de chaque connecteur de nappe (`C29`/`C30`/`C34`/`C35`/`C42`/
`C43` pour J1/J2/J3/J4/J13/J14) — en plus du découplage par IC déjà en
place, pas à sa place.

**Pourquoi un découplage aux deux bouts.** Chaque carte fille découple
déjà ses propres IC (règle déjà en place dans cet atelier). Côté shield,
un bypass à chaque sortie de nappe — plutôt qu'un seul point au LDO —
limite qu'une carte bruyante sur une nappe (ex. un transceiver CAN sur
COM) ne remonte sur `3V3_ISO` et ne perturbe une carte sensible sur une
autre nappe (ADC-1/ADC-2) : même logique que la séparation déjà faite en
decision #13 entre les deux domaines d'alimentation (numérique vs
isolation E/S).

**Valeur.** 100 nF, pas 1 µF ni 10 µF : `3V3_ISO` n'alimente que le côté
commande/non-isolé des isolateurs des cartes filles (decision #13), pas
un étage de puissance — dizaines de mA par carte, pas d'ampères. Un bulk
plus généreux côté carte fille (hors périmètre du shield) reste
pertinent si une carte précise tire plus que ça ; pas justifié par
défaut ici.

**Ce qui casse.** Centraliser le découplage à un seul point (LDO
uniquement) réintroduit le risque de couplage inter-cartes que ce choix
évite. Monter à 1 µF ou plus sans carte fille connue identifiant un
besoin réel serait du surdimensionnement sans raison.

---

## 19. Correction du brochage ADC-2, et protection des 11 signaux nappe nouvellement câblés

**Décision.** Deux problèmes trouvés en relisant le travail de la
decision #17 après coup.

**(a) ADC-2 oubliait `I_SHUNT1_CMP`/`I_SHUNT2_CMP`.** Seule la voie
filtrée (`I_shunt1`/`I_shunt2`, chemin `_MES`) avait été câblée ; la
decision #4 impose pourtant que chaque shunt sorte **deux fois** — un
second chemin, direct et sans filtre, vers le comparateur CMPSS. Les deux
signaux manquants existaient déjà, isolés, au connecteur devkit (ERC :
`isolated_pin_label`). Corrigé en consommant 2 des 6 réserves d'ADC-2
(réserves : 6 → 4), sans les coller à `I_shunt1`/`I_shunt2` : les deux
chemins doivent rester électriquement indépendants, l'adjacence sur le
connecteur n'aide à rien et mélange visuellement ce qui ne doit pas se
confondre — contrairement à l'exception `VREF_ADC`/`VREFLO_SENSE`, qui
est une vraie paire de référence.

**(b) 11 signaux câblés en decision #17 n'avaient aucune protection**,
alors que tout le reste du connecteur devkit en a une. Vérifié en
comparant chaque signal de nappe à son équivalent `_MCU` dans les trois
feuilles de protection existantes (23 trios BAT54S + R + 100 pF, un par
signal, déjà en place avant la decision #17) : `CLB_OUT`, `UART_TX`,
`UART_RX`, `SPI_CLK`, `SPI_SIMO`, `SPI_SOMI`, `SPI_STE`, `CAN_TX`,
`CAN_RX` n'avaient aucun trio, et les deux signaux du point (a) non plus
une fois ajoutés.

**Nouvelle feuille `protection_nappe.kicad_sch`**, 11 trios, copiés
composant par composant et label par label depuis un trio réel
(`protection_devkit3.kicad_sch`, le plus petit des trois feuilles
existantes) plutôt que redessinés — même principe que
`KICAD-EDITION-GROUPEE-KIPY.md` §1 (extraire le gabarit, pas le
re-deviner). Topologie identique partout : BAT54S (clamp vers `GND`/
`3V3_PROT`) + R série + C 100 pF shunt vers `GND`, entre le nom brut
côté nappe et son équivalent `_MCU` côté connecteur devkit — **9 des 11
avec R = 100 Ω** (identique aux 23 trios déjà posés), **`I_SHUNT1_CMP`/
`I_SHUNT2_CMP` avec R = 22 Ω** : la decision #4 impose Rs ≤ 50 Ω sur ce
chemin, que 100 Ω dépasserait. Le condensateur est conservé malgré la
contrainte « sans filtre » de la decision #4 — décision explicite de
l'utilisateur, pas une optimisation de ma part : avec R = 22 Ω, le pôle
RC du 100 pF tombe à 2,2 ns (au lieu de 10 ns avec 100 Ω), soit ~7 % du
budget Trip Zone de 30 ns, jugé acceptable plutôt que de retirer le C.

**Chaque connecteur devkit protégé doit porter le nom `_MCU`, pas le nom
brut.** Conséquence directe de la convention déjà en place sur les 23
trios existants (`Vin` côté nappe → trio → `Vin_MCU` côté connecteur
devkit, jamais l'inverse) : avant d'ajouter un trio pour un signal,
son label au connecteur devkit (`connecteur_devkit.kicad_sch`) doit
d'abord passer du nom brut au nom `_MCU` — sinon le trio protège un
signal qui ne va nulle part. Fait pour les 9 signaux du point (b)
(`CLB_OUT_MCU`, `UART_TX_MCU`, etc.).

**Erratum (même session) : le renommage ci-dessus avait été oublié pour
`I_SHUNT1_CMP`/`I_SHUNT2_CMP`** — leur label isolé au connecteur devkit
était resté sous son nom brut après la création du trio. Conséquence :
le nom brut étant partagé par un `global_label` KiCad entre la feuille
nappe et la feuille connecteur devkit, les deux bouts du trio
(`I_SHUNT1_CMP` côté nappe, `I_SHUNT1_CMP_MCU` théorique côté MCU)
pointaient en fait vers le **même nœud électrique** que l'entrée brute —
le trio BAT54S/R/C existait sur le PCB mais était court-circuité par ce
doublon de nom, invisible à l'ERC (fusionner deux labels de même nom
n'est pas une erreur de connectivité, juste un mauvais choix de nom).
Corrigé en renommant les deux labels du connecteur devkit en
`I_SHUNT1_CMP_MCU`/`I_SHUNT2_CMP_MCU`. **Nécessite un nouveau "Update
PCB from Schematic"** : la mise à jour précédente du PCB a eu lieu
pendant que le bug était encore présent, donc le pad concerné du
connecteur devkit porte encore le mauvais nom de net sur le fichier
`.kicad_pcb` tant que la resynchronisation n'a pas été refaite.

**Second erratum (même session, corrigé deux fois) : l'exception
d'adjacence 7/8 elle-même était le problème, pas seulement la position
de `I_SHUNT1_CMP`.** Premier essai de correction (insuffisant) : garder
`VREF_ADC`/`VREFLO_SENSE` adjacents en 7/8 et seulement déplacer
`I_SHUNT1_CMP`/`I_SHUNT2_CMP` de 9/11 vers 11/13 pour les éloigner de
cette zone non blindée. L'utilisateur a corrigé : la position 8 ne doit
pas être une exception du tout, elle doit porter une masse comme
n'importe quelle position paire. Correction définitive : la paire de
référence `VREF_ADC`/`VREFLO_SENSE` est déplacée en positions **3/5**
(entourées de masse des deux côtés — leur lien électrique passe par le
suiveur rail-to-rail du shield, pas par leur proximité sur la nappe, donc
l'adjacence n'apportait rien) ; `I_shunt1`/`I_shunt2`, qui occupaient
3/5, reculent en **7/9** (toujours entourées de masse, toujours
adjacentes entre elles via la masse de la position 8) ; `I_SHUNT1_CMP`/
`I_SHUNT2_CMP` restent en **11/13**. Alternance stricte masse/signal sur
tout le connecteur, **zéro exception**. Réserves : 4 → **3** (la
position 9, ancien slot libre, porte maintenant `I_shunt2`) ;
renumérotées `RESERVE_ADC2_1`-`3` en positions 15/17/19. Table mise à
jour dans `doc/nappes-shield.md`, y compris le paragraphe général qui
décrivait l'exception 7/8 comme acceptée. Comme pour le premier erratum,
nécessite un nouveau "Update PCB from Schematic" — et cette fois les
tracés déjà routés de `I_shunt1`/`I_shunt2` sur le PCB devront être
repris physiquement : changer le net d'un pad existant ne déplace pas
la piste déjà posée vers le nouveau pad, KiCad va signaler un
désaccord de net sur la piste existante qu'il faudra re-router à la
main vers les nouvelles broches 7/9.

**Désignateurs** (balayage de tous les `.kicad_sch`, aucun trou en
dessous du max avant cette décision) : `D25`-`D35`, `R24`-`R34`,
`C44`-`C54`. `netclass_patterns` étendu : les 9 nets `_MCU` standards et
`CLB_OUT` (bare, oublié lors de la classification précédente) rejoignent
`Rapide` ; `I_SHUNT1_CMP_MCU`/`I_SHUNT2_CMP_MCU` rejoignent `Analogique`
(cohérent avec leurs homologues bruts, déjà classés).

**Ce qui casse.** Ajouter un trio pour un signal sans renommer le label
du connecteur devkit en `_MCU` laisse le trio protéger un nœud qui ne
va nulle part — invisible à l'œil, détecté seulement par
`kicad-cli sch erc` (`isolated_pin_label` qui persiste). Copier un trio
standard (R = 100 Ω) pour un futur chemin comparateur direct
reproduirait l'erreur que `I_SHUNT1_CMP`/`I_SHUNT2_CMP` viennent de
corriger — relire la decision #4 avant toute nouvelle protection sur un
chemin Trip Zone.

**Vérification.** `kicad-cli sch erc` par type de violation (méthode
`KICAD-EDITION-GROUPEE-KIPY.md` §6) : les 11 `isolated_pin_label`
corrigés par cette décision ont disparu (restent les 9 déjà connus,
hors périmètre — point (a) de la decision #17) ; `pin_not_connected`
baisse de 2 (réserves ADC-2 consommées) ; `endpoint_off_grid` augmente
de 33 (un par composant neuf), cohérent avec le même défaut déjà présent
sur les 23 trios existants, pas une régression propre à cette décision.

---

## 20. Bloc CLB du F28P551 utilisé comme mini-CPLD : 4 sorties neuves, nappe GPIO-2 renommée "logic", 5 entrées partagées

**Décision.** Le CLB (Configurable Logic Block) du F28P551 est utilisé comme
un bloc de logique programmable généraliste (mini CPLD), pas uniquement pour
le chemin `CLB_OUT` existant. Ça demande des broches MCU neuves, un devkit
déjà routé modifié en conséquence, et une nappe entièrement repensée.

**(a) Modification de `devkit_B_F28P551`** (carte figée, production-ready —
modifiée malgré la règle habituelle, décision explicite de l'utilisateur,
voir mémoire `kicad_frozen_production_boards`). Quatre masses du connecteur A
sacrifiées pour sortir quatre GPIO jusque-là non câblés sur le connecteur
56 broches : A4→`Stage2_EN` (GPIO20), A10→`HV_EN` (GPIO21), A13→`Stage1_EN`
(GPIO9), A16→`Discharge` (GPIO41). Choix des positions : les deux broches
pleinement isolées (masse des deux côtés, A13/A16) reçoivent les signaux
les plus sensibles côté vitesse — `Stage1_EN` (le seul des quatre pilotable
en matériel par le CLB, voir point (c)) et `Discharge` (coupure de sécurité) ;
`Stage2_EN`/`HV_EN` (commandes d'activation, bascule rare) héritent des
positions plus modestement blindées A4/A10, voisines de mesures ADC-1 lentes
plutôt que du cluster shunt/comparateur. Vérifié via `pin_map.h` : des 4
GPIO, un seul (GPIO9, `OUTPUTXBAR6`) a un chemin X-bar de sortie en
silicium — les trois autres (`GPIO20`, `GPIO21`, `GPIO41`) n'en ont
structurellement aucun, dans aucune configuration. Ce n'est pas un défaut :
les 4 signaux sont de simples sorties GPIO pilotées par le logiciel (le CLB
peut influencer la décision via le registre `CLB_GP_REG` et une bascule
matérielle sur `Stage1_EN` seulement, sans avoir besoin de driver les 3
autres). Report obligatoire sur `connecteur_devkit.kicad_sch` (symboles
ET labels réels, les deux copies — bibliothèque externe
`lib/C2000_Devkit_Connectors.kicad_sym` incluse) : même reséquencement que
le devkit, pour que les deux connecteurs mâle/femelle restent en accord.

**(b) Renommage en logique négative, `nRESET`→`~{RESET}`,
`GPIO_1`/`nFAULT_MCU`→`~{FAULT_MCU}`** (fait par l'utilisateur sur le devkit
et `connecteur_devkit.kicad_sch`). **Erratum découvert en vérifiant** :
`protection_devkit3.kicad_sch` gardait l'ancien nom `nFAULT_MCU` sur les 3
étiquettes du trio existant (D23/R22/C22) — le renommage du connecteur avait
silencieusement coupé ce trio du reste du circuit (`isolated_pin_label` sur
`~{FAULT_MCU}`, invisible autrement, même catégorie de bug que l'erratum
ADC-2 de la decision #19). Corrigé en renommant les 3 étiquettes du trio en
`~{FAULT_MCU}`.

**(c) Quatre trios de protection neufs**, `D36`/`R35`/`C55` (`Stage1_EN`),
`D37`/`R36`/`C56` (`Stage2_EN`), `D38`/`R37`/`C57` (`HV_EN`),
`D39`/`R38`/`C58` (`Discharge`) — gabarit identique aux 23+11 trios
existants (BAT54S + R + 100 pF), mais **R = 10 Ω** au lieu de 100 Ω : les
quatre signaux sont classés `Rapide`, décision explicite de l'utilisateur
plutôt qu'une optimisation de ma part. Pôle RC du 100 pF à 159 MHz (au lieu
de 15,9 MHz avec 100 Ω) — filtrage minimal, cohérent avec des commandes de
sécurité où le délai de la protection elle-même ne doit pas dominer le temps
de réponse.

**(d) Nappe GPIO-2 renommée nappe "logic"** (`NAPPE_GPIO2`→`NAPPE_LOGIC`,
symbole + bibliothèque externe + instance `J13`). Les 9 réserves
(`RESERVE_GPIO2_1`-`9`) devenues `CLB_Out_1`-`4` / `CLB_In_1`-`5` — noms
**cosmétiques sur le symbole connecteur uniquement**, même principe que
`GPIOxx/fonction` côté devkit : l'étiquette électrique réelle reste le vrai
nom de signal, pour qu'il fusionne avec les autres nappes qui le portent
déjà. Répartition : les 4 sorties neuves du point (c) sur `CLB_Out_1`-`4`
(déjà présentes aussi sur la nappe GPIO-1, positions 3/5/7/9, en attente
depuis la decision #17 — **un signal peut vivre sur deux nappes à la fois**,
un seul point d'accès réellement utilisé selon la carte fille branchée) ;
cinq signaux déjà protégés ailleurs tapés en entrée sur `CLB_In_1`-`5` :
`CAN_RX`/`CAN_TX` (nappe COM) et `PWM2_B`/`PWM3_B`/`PWM4_B` (nappe PWM) —
piqués côté nom brut (avant leur trio d'origine), donc le même trio protège
les deux nappes à la fois, sans sacrifice : CAN continue de fonctionner,
les trois canaux PWM gardent leur voie complémentaire intacte. `CMP_OUT`
(6e candidat identifié en cours de route) écarté pour tenir le compte à 5
entrées exactement.

**Désignateurs** : `D36`-`D39`, `R35`-`R38`, `C55`-`C58` (aucun trou en
dessous du max avant cette décision). `netclass_patterns` étendu : les 4
signaux neufs (bruts et `_MCU`) rejoignent `Rapide`. `used_designators`
mis à jour (`C42-58`, `R1-38`).

**Ce qui casse.** Oublier de reporter le reséquencement du devkit sur
`connecteur_devkit.kicad_sch` referait exactement l'erratum (b) : un nom de
label qui ne correspond plus des deux côtés du même connecteur, invisible
tant qu'on ne compare pas net par net. Ajouter une future sortie CLB sur
`GPIO20`/`GPIO21`/`GPIO41` est impossible en silicium — relire le point (a)
avant d'essayer.

**Vérification.** `kicad-cli sch erc` par type : `isolated_pin_label` 9 → 5
(disparition de `Stage1_EN`/`Stage2_EN`/`HV_EN`/`Discharge`, qui restaient
les 9 signaux déjà connus en pas encore reliés — 5 subsistent, les réserves
ADC libres `ADC_8`-`ADC_12`, hors périmètre) ; `pin_not_connected` baisse de
9 (les 9 broches de la nappe logic désormais câblées) ; aucune nouvelle
catégorie de violation.

---

## 21. Empreinte NCM3S1205MC remplacée par le modèle téléchargé SnapEDA (symbole + footprint), broches inchangées

**Décision.** L'utilisateur a téléchargé le modèle KiCad du Murata
NCM3S1205MC-R7 publié par SnapEDA
(`composants-datasheets/datasheets/NCM3S1205MC/`, symbole
`NCM3S1205MC-R7.kicad_sym` + empreinte `CONV_NCM3S1205MC-R7.kicad_mod`,
Murata via Mouser). Décision explicite (question posée, réponse
« remplacer symbole + footprint ») plutôt qu'une estimation : les deux
géométries disponibles pour ce composant divergent et aucune des deux
n'est vérifiée par une capture d'empreinte physique (R15 de
`composants-datasheets/.claude/rules/data-yaml.md`) — l'ambiguïté n'est
donc pas résolue, seulement déplacée vers une source différente.

**(a) Footprint** (`lib/NCM3S1205MC.kicad_mod`, et copie figée dans
`shield.kicad_pcb` pour U2 et U3, dual-copy comme pour les symboles de
connecteur). Géométrie remplacée par celle du modèle SnapEDA : pastilles
à `x=±11.0mm` (au lieu de `±9.9mm`), pas vertical de 6,75mm inchangé,
numérotation 1-4 préservée (même correspondance pin-fonction qu'avant :
1=`-VIN`, 2=`+VIN`, 3=`+VOUT`, 4=`-VOUT`). Contour sérigraphie à 8
segments (encoches au droit de chaque pastille, le style SnapEDA) plutôt
que l'ancien contour à une seule encoche coin. Nom de l'empreinte
conservé (`NCM3S1205MC`, pas `CONV_NCM3S1205MC-R7`) pour ne pas toucher
la propriété `Footprint` des instances U2/U3. Les deux zones de garde
(keepout anti-coulée) du modèle SnapEDA n'ont **pas** été reportées :
aucune zone n'existe ailleurs dans ce board, les reproduire à la main
sans exemple local à valider aurait été un risque de syntaxe gratuit pour
un gain cosmétique (anti-coulée de cuivre sous le boîtier). Vérifié : U2
et U3 sont posés mais **non routés** (zéro segment sur `U2_VINF`,
`U2_GNDF`, `U3_VINF`, `U3_GNDF`, `5V_ISO`, `5V_NUM` à proximité de ces
deux footprints) — le changement de position des pastilles ne casse donc
aucune piste existante. `kicad-cli pcb drc` : 412 violations avant et
après, catégories identiques.

**(b) Symbole** (`lib/Power_Parts.kicad_sym`, et copie embarquée dans
`dc.kicad_sch`). Seuls les **noms** de broches sont repris du modèle
téléchargé (`-Vin`→`-VIN`, `+Vin`→`+VIN`, `+Vout`→`+VOUT`,
`-Vout`→`-VOUT`) — **position, longueur et type électrique des broches
inchangés**. Deux raisons, vérifiées toutes les deux avant de trancher,
pas supposées :
- `dc.kicad_sch` n'est **pas** en labels-only comme les nappes : des
  fils réels relient U2/U3 au filtre EMC local (L1-4/C26-33/C40-41).
  Reprendre aussi les coordonnées de broches du modèle SnapEDA (qui
  élargit le symbole de 5,08mm de chaque côté) aurait désaligné ces fils
  de leur point de connexion sans qu'aucun outil ne le signale avant
  ouverture dans KiCad.
- Le modèle SnapEDA type ses broches d'alimentation en `input`/`output`
  simples plutôt qu'en `power_in`/`power_out`. Testé : adopter ce typage
  fait disparaître 3 `power_pin_not_driven` (U2/U3 broches 1/2, attendu)
  mais en fait apparaître un nouveau sur `J1 Pin 2 [GND]` — `+VOUT` (U2
  ET U3, broche 3) sert de driver implicite du net `GND` entier via son
  type `power_out` ; le repasser en `output` simple retire ce rôle de
  driver à l'échelle du projet. Ce n'est pas un artefact du modèle
  téléchargé, c'est un choix électrique déjà en place dans ce dépôt
  (sortie flottante, référence de masse choisie côté secondaire) —
  revert complet des 4 types de broche. `kicad-cli sch erc` : 200
  violations avant et après l'édition finale, catégories et comptes
  identiques (vérifié par diff).

**Vérification physique.** Cotes et pastilles du modèle SnapEDA confirmées
par l'utilisateur contre la page 10 du datasheet Murata (KDC_NCM3_A01) —
correspondance exacte. Le point ouvert hérité de la decision #15 est
clos : c'est désormais ce footprint, vérifié, qui fait référence pour
NCM3S1205MC dans ce dépôt.

**(c) Modèle 3D.** Absent du téléchargement SnapEDA (ni fichier `.step`
dans `composants-datasheets/datasheets/NCM3S1205MC/`, ni nœud `(model ...)`
dans `CONV_NCM3S1205MC-R7.kicad_mod`). Récupéré directement chez Murata :
page officielle `murata.com/en-us/products/power/3d`, fichier
`mps_dcdc_nmc3s_mc_a.step` (SolidWorks 2023, STEP AP214, ~16,6 Mo) — un
seul modèle couvrant toute la famille de boîtier NCM3S-MC (cohérent avec
le datasheet, qui ne publie qu'un seul plan d'empreinte pour toute la
série). Stocké dans `lib/NCM3S1205MC.step`, référencé depuis
`lib/NCM3S1205MC.kicad_mod` et les deux copies figées U2/U3 dans
`shield.kicad_pcb` via `${KIPRJMOD}/lib/NCM3S1205MC.step`, offset/scale/
rotate à l'identité. Alignement visuel dans l'éditeur 3D de KiCad non
vérifié par Claude (pas de rendu 3D disponible en CLI) — à confirmer par
l'utilisateur à l'ouverture. Taille notable pour un dépôt git (16,6 Mo,
premier modèle 3D custom de ce projet) : signalé, pas d'action prise sans
demande explicite.

**(d) Bug trouvé en cherchant pourquoi certains trios n'avaient pas de
rendu 3D** (signalé par l'utilisateur : groupe D4/R3/C3 visible, groupe
D9/R7/C7 absent). Vérifié sur les 158 empreintes de `shield.kicad_pcb` :
**97 en manquaient**, toutes issues des générations en masse par script de
ce projet (23 trios `protections_devkit*`, 11 trios `protection_nappe`
decision #19, et même `R35`-`R38` de la decision #20 alors que leurs
`D36`-`D39`/`C55`-`C58` jumeaux en avaient) — les seules rescapées : `R1`-
`R3`/`C1`-`C2`/`C24`-`C43`/`D1`-`D4` (posées ou importées avant ces
scripts). Cause : le nœud `(model ...)` n'était pas systématiquement
recopié par les scripts de duplication utilisés au fil des sessions
précédentes. Corrigé en une passe : les 97 empreintes récupèrent le nœud
standard de leur type (`${KICAD10_3DMODEL_DIR}/Package_TO_SOT_SMD.3dshapes/
SOT-23.step`, `.../Resistor_SMD.3dshapes/R_0805_2012Metric.step`,
`.../Capacitor_SMD.3dshapes/C_0805_2012Metric.step`, offset/scale/rotate à
l'identité, repris des rescapés). `kicad-cli pcb drc` : 412 violations
avant et après, identique (le modèle 3D ne participe à aucune règle DRC).
Seule empreinte encore sans modèle à ce stade : `U4` (`lib:ER-OLEDM032-1`,
connecteur OLED custom) — même situation que NCM3S1205MC avant le point
(c), pas de modèle standard disponible.

**(e) Modèle 3D ER-OLEDM032-1.** Fourni directement par l'utilisateur
(`lib/ER-OLEDM032-1.STEP`, SolidWorks 2023, STEP AP214, ~4,4 Mo). Référencé
depuis `lib/ER-OLEDM032-1.kicad_mod` et la copie figée U4 dans
`shield.kicad_pcb`, offset/scale/rotate à l'identité (comme pour
NCM3S1205MC, alignement non vérifié visuellement par Claude). Les 158
empreintes du board ont désormais toutes un modèle 3D. `kicad-cli pcb drc`
inchangé (412 violations, mêmes catégories).

---

## 22. 45 footprints B.Cu gardaient leur sérigraphie/fab/courtyard sur la face avant (bug des mêmes scripts de duplication)

**Décision.** Signalé par l'utilisateur (groupe D4/R3/C3 correct en vue 3D,
groupe D9/R7/C7 — puis généralisé — absent/mal affiché). Vérifié sur les
158 footprints : **45 montés en B.Cu portaient encore des éléments
graphiques sur `F.SilkS`/`F.CrtYd`/`F.Fab`** au lieu de leurs équivalents
`B.*` — mêmes 45 réfs que la decision #20/#19 (`D25`-`D39`, `R24`-`R38`,
`C44`-`C58`). Deux sous-catégories : 32 avec corps sérigraphie + courtyard
+ contour fab non retournés du tout (copie brute de l'original F.Cu, ni
couche ni coordonnées changées) ; 13 avec seulement une propriété cachée
non-standard (`KiLib_Generator`, métadonnée de génération de footprint)
oubliée sur `F.SilkS` — invisible à l'oeil (propriété masquée) mais
révélatrice que même les passages "propres" de ce script ratent les
champs hors de la liste standard Reference/Value/Datasheet/Description.
Pastilles et modèle 3D déjà corrects dans les deux cas (uniquement
cosmétique/documentaire, aucun impact électrique).

**Diagnostic.** Comparé un trio cassé (`D25`) à un trio correct (`D36`,
puis `R3`/`C3`) élément par élément : le transform correct est **négation
du Y local** (coordonnées propres au footprint, centre = origine) +
permutation de couche `F.*`→`B.*`, conforme à la recette déjà documentée
dans `KICAD-EDITION-GROUPEE-KIPY.md` (miroir Y pour les pastilles,
protobuf absolu pour les formes côté kipy — ici vérifié que la même règle
de signe s'applique aux coordonnées locales du fichier texte). Script de
correction + un vérificateur réutilisable
(`check_mirrored_footprints.py`, racine du workspace) écrits et ajoutés à
la méthode documentée — voir ce fichier pour le détail et pourquoi
`lib_footprint_mismatch` seul ne suffit pas à détecter ce bug (bruit
préexistant, ne dit pas QUEL élément diverge).

**Incident pendant la correction.** KiCad était ouvert avec ce board
chargé (confirmé via `kipy.KiCad()` connecté) pendant que le fichier était
édité directement en texte — l'utilisateur travaillait en direct dans
l'éditeur PCB. Plusieurs passages se sont fait écraser partiellement : les
éléments de formes (338 éditions) ont fini par tenir, mais les 45
propriétés cachées (`KiLib_Generator`) sont revenues à leur état
`F.SilkS` d'origine à répétition, y compris après une correction vérifiée
immédiatement correcte — cohérent avec la session KiCad live qui
sauvegarde son état mémoire par-dessus l'édition texte. Résolu seulement
une fois l'utilisateur confirmé avoir fermé son edition. **Règle retenue,
ajoutée à `KICAD-EDITION-GROUPEE-KIPY.md`** : vérifier `kipy.KiCad()`
avant d'éditer le texte d'un `.kicad_pcb` ; si connecté, ne pas s'acharner
à re-corriger en boucle — demander à l'utilisateur de fermer le board
avant de repasser, ou traiter via kipy plutôt que par le texte.

**Vérification (une fois KiCad fermé, fichier stable).** `kicad-cli pcb
drc`, comparé par type à la toute première ligne de base de cette session
(412 violations hors `unconnected_items`, qui reste 313 inchangé de bout
en bout) : `lib_footprint_mismatch` 36 → 0 (y compris `R35`-`R38`, qui
faisaient partie du même bug — pas un bruit sans rapport comme
supposé un temps pendant l'incident ci-dessus) ; `npth_inside_courtyard`
2 → 0 et `courtyards_overlap` 2 → 1 (trous/courtyards mal positionnés
par le miroir manquant, maintenant corrects) ; `silk_over_copper` 80 → 75
(sérigraphie qui chevauchait du cuivre à sa mauvaise position d'origine) ;
`silk_overlap` 41 → 55, soit 14 nouvelles entrées, toutes citant des réfs
du lot corrigé (`D25`-`D35` contre `C44`-`C54`/`R29`/`R34`) —
chevauchements réels de sérigraphie entre trios voisins, invisibles tant
que les deux couches ne coïncidaient pas ; point ouvert de layout, pas
traité ici. `clearance` (93) et `text_height` (158) strictement
inchangés — confirme qu'aucun autre changement (routage, placement) ne
s'est glissé dans le fichier final malgré l'incident de sauvegarde
concurrente.

---

## 23. Alimentation des cartes filles en USB-C Power Delivery (STUSB4531QTR), deuxième entrée séparée du 11-25V

**Décision.** Le shield devient aussi la source de puissance des cartes
DC/DC enfichables (jusqu'ici, elles tiraient leur étage de puissance
d'une source externe, le shield ne leur fournissant que `3V3_ISO`,
commande des isolateurs). Un port USB-C négocie jusqu'à 100W (20V/5A) via
un STUSB4531QTR, et cette puissance est transmise **en daisy chain**
d'une carte fille à la suivante — budget 100W/5A partagé sur la chaîne,
le connecteur de sortie n'est qu'une convention d'interface, la
propagation carte-à-carte restant un circuit à concevoir sur chaque carte
fille (hors périmètre de ce dépôt).

**Pourquoi une deuxième entrée, pas une fusion avec le 11-25V (position
initiale, revue ci-dessous).** Confirmé explicitement par l'utilisateur
à l'origine : le `J_PWR` 11-25V existant ne sert et ne servira qu'aux
deux NCM3S1205MC du shield (6W au total) ; le port USB-C est une entrée
séparée, dédiée à la puissance des cartes filles.

**Révision (2026-11-10) : les deux entrées sont en fait redondantes, pas
simultanées — fusionnées.** Correction explicite de l'utilisateur :
`VIN_PWR` (11-25V, `J9`) et `VBUS_IN` (USB-C PD négocié) ne seront
**jamais utilisées ensemble** — ce sont deux moyens alternatifs
d'alimenter la même carte, l'USB-C en usage normal, le 11-25V en secours
si l'USB-C ne fonctionne pas. Mise en œuvre : les 11 occurrences du
`global_label "VBUS_IN"` dans `usb_pd.kicad_sch` renommées en
`"VIN_PWR"` — fusion électrique pure (même net), aucun composant
ajouté entre les deux.

**Risque identifié et accepté explicitement.** Relier directement deux
sources DC indépendantes expose à un retour de courant si les deux
câbles se trouvent branchés en même temps par erreur, et expose le
STUSB4531QTR (AMR `VDD`/VBUS = 28V, `DS_stusb4531.pdf` p.1, caractéristique
« AMR = 28V ») à la pleine plage de `VIN_PWR`. Décision utilisateur après
ces deux points soulevés : **lien direct, sans diode-OR** — discipline
manuelle (jamais les deux branchés), accepté en connaissance de cause.

**Ce qui rend ça sûr côté composant** : `D40` (zener 3W, SMC, déjà
présente côté `VBUS_IN` pour la protection ESD/surtension) avait une
valeur placeholder (`Z3SMCxxx`) non choisie — fixée à **`Z3SMC24`**
dans cette même révision. Vérifié contre la datasheet Diotec
(`z3smc1.pdf`, table p.2) : `Vz` = 22,8 à 25,6V pire cas, soit 2,4V de
marge sous les 28V d'AMR du STUSB4531 — le zener clampe avant que la
pleine plage de `VIN_PWR` (jusqu'à 36V tolérés côté NCM3S1205MC)
n'atteigne le composant. Note secondaire, pas bloquante : à 25V (haut de
la plage normale 11-25V), le zener est déjà proche de son seuil de
conduction (`Vz_min` = 22,8V) — légère dissipation possible en
fonctionnement normal au sommet de la plage, pas seulement en défaut.

**Laissé en l'état, hors périmètre de cette révision** : `D41` (zener
équivalente côté `VBUS_OUT`) porte toujours la valeur placeholder
`Z3SMCxxx`, non choisie.

**Vérification de la fusion.** `kicad-cli sch erc` avant/après : 355
violations dans les deux cas, mêmes catégories, aucune nouvelle —
fusion électriquement neutre à part l'union des deux nets.

**Pourquoi `HV_EN`/`Discharge` (nappe GPIO-1, decision #17/#20) ne sont
pas réutilisés ici.** Ces deux signaux existent déjà, pilotés par le
C2000, protégés par trio (`protection_nappe.kicad_sch`), et leur nom
évoque un usage proche (activer/décharger un bus de puissance vers les
cartes filles). Ce sont pourtant des signaux **distincts** : le
STUSB4531QTR gère sa propre coupure (`VBUS_EN_SNK`, autonome, basée sur
le contrat PD négocié) et sa propre décharge (`DISCH`/`VBUS_VS_DISCH`,
automatique au retrait du câble ou à une transition de PDO), sans
intervention du C2000 ni de l'ESP32. Mélanger les deux aurait inventé un
lien que l'utilisateur n'a pas demandé ; `HV_EN`/`Discharge` restent
intacts, pour l'usage non encore défini de la decision #17 (future carte
de conversion 0-500V, projet séparé).

**Composant retenu : STUSB4531QTR** (ST, QFN-16 3×3mm, variante "dead
battery" — se négocie seule même système éteint, alimentée directement
sur VBUS). Topologie reprise d'`EVAL-SCS006V1`
(`composants-datasheets/datasheets/eval-scs006v1-schematics.pdf`),
recoupée avec `DS_stusb4531.pdf` : **aucun eFuse externe** — le
STUSB4531QTR pilote directement un unique MOSFET P (T1) via un réseau
R (100kΩ pull-up vers VBUS_IN + 22kΩ vers `VBUS_EN_SNK` + 100Ω/100nF de
filtrage à la grille), et gère la décharge en interne (`DISCH` draine le
côté système/VBUS_OUT, `VBUS_VS_DISCH` le côté réceptacle/VBUS_IN,
chacun via sa résistance série dédiée — 1kΩ, limite le courant bien en
dessous des maximums datasheet : 100mA pour `DISCH`, 50mA pour
`VBUS_VS_DISCH`, soit 20mA réels sous 20V dans les deux cas).

**Pas de SnapEDA pour le STUSB4531QTR** (référence trop récente,
sortie 10-2025) : symbole + empreinte faits à la main depuis le
datasheet (QFN-16, pitch 0,5mm, **pas de pastille thermique** — absente
de la Table 26, contrairement à tous les gabarits QFN-16 stock de
KiCad qui supposent une pastille centrale), même méthode que
`NCM3S1205MC`. Empreinte dérivée des cotes explicites de la Figure 13
(pitch 0,5 / largeur pastille 0,3 / longueur 1,0, recoupées avec
l'enveloppe totale 4,0mm et le groupe de 4 pastilles 1,8mm — tout
retombe juste, aucune cote devinée).

**Composants confirmés par l'utilisateur, adaptant la BOM de l'eval
board** :
- **T1 : SQJ459EP-T2_GE3** (Vishay, PowerPAK SO-8 single, confirmé
  simple — pas un dual) au lieu du STL6P3LLH6 de l'eval board — 60V/52A
  continu/18mΩ, très large marge sur nos 5A (≈0,45W dissipés), contre
  une marge plus juste côté eval board (6A@25°C/3,8A@100°C). Empreinte
  stock KiCad `Package_SO:PowerPAK_SO-8_Single` (pin1=Gate,
  pins2/3/4=Source, pin5=Drain+broches6/7/8+pastille thermique
  fusionnées — convention Vishay standard pour ce boîtier, à confirmer
  visuellement avant commit).
- **2 LED 3mm rouge/vert** (traversant) au lieu du LD20 (RGB SMT) + LD21
  de l'eval board — branchées sur 2 des 3 flags `GPOD`/`HVO1`/`HVO2`
  (POWER_OK par palier de PDO négocié, config NVM par défaut conf3),
  tirées depuis `VBUS_OUT` (ces broches sont "HV open drain", prévues
  pour un tirage haute tension, pas depuis `VREG_2V7`).
- **Connecteur USB-C : Würth 632722100213** ("WR-COM USB PD Horizontal
  Receptacle SMT") — 6 broches seulement (CC1/CC2/VBUS×2/GND×2, pas de
  D+/D-/SBU, pas de rôle data dans cette intégration), **5A/48V par
  voie**, exactement dimensionné pour l'usage. Fichiers KiCad fournis
  par Würth (SamacSys) dans
  `composants-datasheets/datasheets/mecanique/usbc/` — portés dans
  `lib/632722100213.kicad_mod`/`Power_Parts.kicad_sym` en reformatant au
  style KiCad 10 du projet (le fichier `.kicad_mod` brut de Würth est en
  syntaxe KiCad 5 legacy). **Bug corrigé au passage** : le `.kicad_mod`
  brut de Würth numérotait ses 4 pattes mécaniques `1`/`2`/`3`/`4`, en
  contradiction avec son propre `.kicad_sym` qui les nomme
  `MH1`-`MH4` — renumérotées `MH1`-`MH4` des deux côtés pour que
  l'association pastille/broche reste cohérente.
- **TVS** : `ESDA25W` (SOT-323, 25V/400W, 2 voies — protège CC1 **et**
  CC2 dans un seul boîtier, symbole custom 3 broches façon `BAT54S`) +
  **2× `ESDA25P35`** (QFN1610, Vrwm 22V/1,4kW peak pulse — un sur
  VBUS_IN près du connecteur, un sur VBUS_OUT près de la sortie cartes
  filles), tous deux confirmés avec marge de tension confortable sur
  notre bus 20V. `ESDA25P35` utilise le symbole générique
  `Device:D_TVS` + empreinte stock `Diode_SMD:ST_QFN-2L_1.6x1.0mm` — pas
  besoin d'un symbole custom, boîtier déjà couvert par KiCad.
- **`PWR_FLAG`** posé sur `VBUS_IN` à l'origine (pas sur `GND`, qui a
  déjà un pilote `power_out` ailleurs dans le projet — en poser un
  deuxième dessus aurait créé un conflit `pin_to_pin`, détecté et
  corrigé pendant la vérification ERC ci-dessous) : `VBUS_IN` était un
  net neuf sans régulateur on-board pour le "piloter" au sens ERC,
  strictement nécessaire ici contrairement aux rails déjà établis du
  shield. **Depuis la révision du 2026-11-10 ci-dessus, ce `PWR_FLAG` se
  trouve sur `VIN_PWR`** (fusion des deux nets) — toujours utile, `J9`
  seul (simple connecteur) ne pilote pas le net au sens ERC.

**Bus I2C ESP32 dédié** (supervision/statut seulement — l'autorun du
STUSB4531QTR négocie sans lui) : **PAS** le bus I2C des nappes (celui-là
reste au C2000, réservé aux cartes filles). Nouveau, sur
`GPIO22`/`GPIO23`/`GPIO21` (`doc/brochage-esp32.csv`, J3-6/J3-5/J3-7,
tous trois "réserve", aucun n'est une broche de strapping) pour
`STUSB_SCL`/`STUSB_SDA`/`STUSB_ALERT`. Pull-ups I2C (3× 4,7kΩ, valeur
neuve — aucune des valeurs de la BOM initiale n'était disponible pour ce
rôle) tirées vers `3V3_ESP32` (label déjà existant, réutilisé — pas un
nouveau rail).

**Vérification.** `kicad-cli sch erc` comparé par type de violation,
feuille par feuille (`sheets[].violations` du rapport JSON, pas
seulement le total projet) : la feuille `USB_PD` neuve ferme à **zéro**
violation. Aucune catégorie pré-existante n'a augmenté ailleurs ;
`Connecteurs_Devkit` a même vu son `pin_not_connected` baisser de 17 à
14 (GPIO21/22/23, jusque-là "réserve" sans étiquette, désormais
connectées). Deux bugs trouvés et corrigés pendant cette vérification,
documentés ici pour ne pas les refaire :
1. Un script de génération interne avait renommé par erreur les
   sous-symboles graphiques (`NOM_0_1`/`NOM_1_1`) avec le préfixe de
   bibliothèque — seul le nom du symbole racine doit le porter, les
   sous-unités restent nommées sans préfixe, sans quoi KiCad refuse de
   charger le fichier (`Échec du chargement de la schématique`, aucun
   message d'erreur plus précis).
2. Confirmation **empirique**, par comparaison des UUID de broches entre
   le rapport ERC JSON et le fichier source, que dans ce format
   `.kicad_sch`, la position monde d'une broche se calcule
   **Y_monde = Y_instance − Y_local** (soustraction), pas addition —
   contrairement à une supposition antérieure validée (à tort, par
   coïncidence) sur un autre fichier plus tôt dans l'atelier. Toute
   future génération programmatique d'étiquettes globales sur une broche
   doit utiliser cette règle.

---

## 24. Trois bugs de labels sur `usb_pd.kicad_sch` (placement, rotation, justify) — même cause que le #14, cette fois avec un vérificateur

**Constat.** Après la decision #23, l'utilisateur a signalé trois défauts
visuels successifs sur les labels de `usb_pd.kicad_sch`, aucun détecté par
`kicad-cli sch erc` (la connectivité électrique restait correcte à chaque
fois — seul le placement/l'orientation visuelle était faux) :

1. **Reference/Value empilés au-dessus/en-dessous** du corps au lieu de
   gauche/droite — l'anti-motif déjà documenté par la mémoire
   `kicad-component-label-placement` (établie sur `alim-flyback-filament`,
   un *autre* dépôt), reproduit ici en écrivant un nouveau générateur sans
   relire cette mémoire d'abord.
2. **Rotation des `global_label` = angle local de la broche tel quel**
   au lieu de **angle + 180** — la broche pointe vers le corps depuis son
   point de connexion, le label doit pointer vers l'extérieur, sens
   opposé. Une édition manuelle de correction par l'utilisateur a même été
   **écrasée** par une régénération complète du fichier avant que la
   vraie formule soit trouvée (voir decision précédente sur le risque
   d'édition concurrente, ici côté schéma et non PCB — pas de `kipy`
   équivalent pour détecter une feuille ouverte).
3. **Rotation posée sans la propriété `justify` assortie** — convention
   déjà établie par la **decision #14** (rotation 0/90 → `justify left`,
   180/270 → `justify right`), vérifiable sur 90+ labels réels de
   `protection_nappe.kicad_sch`, que je n'avais pas relue avant d'écrire
   le générateur de la decision #23.

**Ce qui casse, si ignoré à nouveau.** Les trois bugs sont du même type
que celui déjà vécu en decision #14 (signe Y) et en decision #22
(footprints mal recopiés) : **un script de génération qui réinvente une
règle de placement déjà établie, au lieu de relire la décision qui la
documente.** `kicad-cli sch erc` ne signale aucun des trois — seule une
relecture à l'oeil dans KiCad, ou un vérificateur dédié, les attrape.

**Prévention — vérificateur ajouté, pas juste une note.**
[`check_schematic_labels.py`](../../check_schematic_labels.py) (racine du
workspace, même principe que `check_mirrored_footprints.py` pour le PCB)
vérifie sur un `.kicad_sch` donné : (a) Reference/Value à gauche/droite du
corps, jamais au-dessus/en-dessous ; (b) rotation d'un `global_label` =
angle local de la broche + 180 ; (c) `justify` assorti à cette rotation
(0/90 → left, 180/270 → right). Limite connue : ne couvre que les
instances à rotation 0 sans mirror (générateur neuf) — formule du cas
général pas encore re-dérivée pour les labels. Détail complet et recette
de génération dans `KICAD-EDITION-GROUPEE-KIPY.md` (racine du workspace,
section « Génération programmatique d'un `.kicad_sch` »).

**Règle retenue pour tout futur générateur de schéma dans cet atelier** :
relire `doc/decisions.md` (decisions #14, #22, celle-ci) *avant* d'écrire
un script qui place des composants ou des labels — ne pas re-dériver une
formule de géométrie KiCad par essai-erreur quand elle est déjà
documentée.

---

## 25. Connecteur devkit_B remplacé : deux embases 2×24 (masse en vis-à-vis), devkit_A n'est plus compatible avec ce shield

**Décision.** L'utilisateur a construit, côté `KICAD-C2000-devkit`, le
« plan v2 » du connecteur devkit (`doc/connecteur-v2-plan.md` là-bas,
proposition écrite lors d'une session précédente suite à la decision #13
de ce même dépôt — rangée A réduite à 6 masses pour 22 signaux après le
routage CLB). Deux nouveaux symboles, `DEVKIT_C2000_A`/`DEVKIT_C2000_B`
(48 broches chacun, boîtier `PinHeader_2x24_P2.54mm_Vertical`),
remplacent les anciens `DEVKIT_C2000_ROW_A`/`ROW_B` (1×28 chacun) sur
`devkit_B_F28P551` — `devkit_A_F280037` n'a pas été touché, reste sur
l'ancien connecteur.

**Choix tranché avec l'utilisateur** (question posée, réponse obtenue) :
le shield adopte le nouveau connecteur de devkit_B — pas de double
connecteur pour rester compatible avec les deux devkits. Connecteurs côté
shield en **femelle** (`Connector_PinSocket_2.54mm:
PinSocket_2x24_P2.54mm_Vertical`), comme c'était déjà le cas pour
l'ancien 1×28 — le devkit garde le mâle.

**Ce qui casse.** `devkit_A_F280037` n'est plus compatible mécaniquement
avec ce shield (connecteur différent, pas seulement un brochage
différent comme la decision #13 côté devkit l'avait déjà accepté pour le
CLB). Limitation acceptée tant que devkit_A n'a pas reçu la même mise à
jour — même logique que la decision #13 du dépôt devkit.

**Migration réalisée** (`connecteur_devkit.kicad_sch`, `lib/
C2000_Devkit_Connectors.kicad_sym`) : remplacement pur, aucun renommage
de net. Le style labels-only de ce dépôt fait que la connectivité réelle
(nappes, protections) ne dépend que des noms de net, jamais de la
position physique de broche — confirmé en comparant, pin par pin, le
texte réellement affiché sur chacune des 56 anciennes broches
(`DEVKIT_C2000_ROW_A`/`ROW_B`) au nom propre de la broche dans le
symbole : **38 des 56 différaient** (le nom de net réel porte presque
toujours un suffixe `_MCU`, ex. `Vin`→`Vin_MCU`, et deux renommages
cosmétiques, `+5V`→`5V_C2000` et `I_SHUNT1/2_MES`→`I_shunt1/2_MCU`) —
tous les 96 noms de broche des deux nouveaux symboles retombent dans
cette table déjà construite, confirmant que c'est un pur réarrangement,
aucun nouveau signal. **Script ponctuel plutôt qu'à la main**, nouveaux
désignateurs `J17`/`J18` (prochains libres, vérifiés sur tout le projet —
`J16` était le dernier pris, par `usb_pd.kicad_sch`).

**Deux bugs trouvés pendant la génération, corrigés avant de considérer
le fichier posé** — à ajouter à la liste des pièges déjà documentés
(decision #24, `KICAD-EDITION-GROUPEE-KIPY.md`) :
1. Utiliser le nom de broche du symbole tel quel comme nom de net, sans
   vérifier contre ce que l'ancien connecteur affichait réellement à cet
   endroit — aurait rendu `+5V`/`I_SHUNT1_MES`/`I_SHUNT2_MES` isolés
   (`isolated_pin_label`, +3 par rapport à la référence) au lieu de se
   raccorder à `5V_C2000`/`I_shunt1_MCU`/`I_shunt2_MCU`.
2. Poser un `global_label` texte `"~"` sur une broche de type électrique
   `no_connect` au lieu d'un marqueur `(no_connect ...)` — déclenche
   `label_dangling` **et** `no_connect_connected` (la broche se déclare
   non connectée alors qu'un label y est posé).

**Vérification.** `check_schematic_labels.py` sur `connecteur_devkit.
kicad_sch` : 0 problème de rotation/justify sur les 96 labels neufs (les
3 Reference/Value encore empilées haut/bas, `J7`/`J8`/`J10`, sont
pré-existantes, pas introduites ici). `kicad-cli sch erc` sur
`shield.kicad_sch`, comparé **feuille par feuille** à l'état précédent :
`isolated_pin_label` revient exactement à 5 (les réserves ADC
pré-existantes, non câblées, déjà connues) ; `pin_not_connected`/
`power_pin_not_driven`/`pin_not_driven` sur `/Connecteurs_Devkit/`
strictement inchangés ; aucune catégorie nouvelle, aucun des 96 nouveaux
éléments n'apparaît dans l'augmentation pré-existante d'`endpoint_off_grid`
(vérifié par contenu, pas seulement par total — les entrées en plus
citent des réfs d'autres feuilles, sans rapport avec cette migration).

**Points ouverts, hérités du plan d'origine côté devkit, non résolus
ici** : rien ne détrompe mécaniquement les deux embases 2×24 d'un même
devkit l'une par rapport à l'autre (domaine A vs domaine B) — à trancher
avant tout routage de la zone connecteur du shield. `doc/spec-devkit.md`
de ce dépôt a été mis à jour (§2bis) pour devkit_B ; la source amont
`KICAD-C2000-devkit/doc/spec-devkit.md` ne l'est pas encore — signalé,
pas corrigé, hors périmètre.

---

## 26. Connecteurs dédiés carte HV et carte Filament (HT), en plus des six nappes — écart assumé à la decision #17

**Décision.** Les deux premières cartes filles réelles (« carte HV », « carte
Filament ») ont plus de signaux à échanger que ce que les réserves des six
nappes partagées peuvent offrir d'un coup (ADC-2 : 3 réserves ; GPIO-1 :
aucune). Plutôt que de forcer leur brochage dans cette capacité insuffisante,
chaque carte reçoit **son propre connecteur IDC 2×10 dédié**, en plus des six
nappes — écart délibéré à la decision #17 (« pas de connecteur sur mesure par
carte »), assumé pour ces deux cartes spécifiquement, pas une remise en
cause du principe pour les futures cartes génériques.

Le style labels-only (connectivité par nom de net, jamais par position)
permet ça sans toucher au câblage existant : un deuxième `global_label` du
même nom sur la nouvelle broche suffit — même principe déjà en place pour
`Stage1_EN`/`Stage2_EN`/`HV_EN`/`Discharge`, visibles à la fois sur GPIO-1 et
sur logic/CLB (decision #20).

**Carte HV** — deux connecteurs neufs, `J19` (`NAPPE_HV_ADC`, mesures
Vin/Iin/V1/Vout/Iout/shunts) et `J20` (`NAPPE_HV_DIO`, PWM/commandes/
températures), sur une feuille dédiée `connecteur_carte_hv.kicad_sch`. Les 20
signaux repris (hors `3V3_ISO`/GND) sont **tous déjà protégés ailleurs** dans
le projet (`Vin`, `Iin`, `V1`, `Vout`, `Iout`, `I_shunt1`, `I_SHUNT1_CMP`,
`I_shunt2`, `I_SHUNT2_CMP`, `Temp1`, `Temp2`, `PWM1_A`, `PWM2_A`,
`Stage1_EN`, `Stage2_EN`, `HV_EN`, `Discharge`) — vérifié net par net avant
de poser quoi que ce soit. Aucune protection neuve sur cette feuille.

**Carte Filament (HT)** — un connecteur neuf, `J21` (symbole
`NAPPE_FILAMENT_HT`, valeur affichée renommée `DC_HT` depuis,
2026-10-28), sur
`connecteur_ht.kicad_sch`. `PWM3_A`, `PWM3_B`, `CMP_OUT`, `CLB_OUT` sont
repris tels quels (déjà protégés). **Cinq signaux sont neufs** : les voies
`ADC_8`-`ADC_12` du connecteur devkit, jusqu'ici posées mais jamais câblées
nulle part (`isolated_pin_label`, documenté depuis le départ) :

| Voie devkit | Signal carte Filament | R du trio | Pourquoi |
|---|---|---|---|
| `ADC_9` | `Vht` | 100 Ω | mesure simple |
| `ADC_10` | `I_Out_ht` | 100 Ω | mesure simple (ex-`Temp_ht` — mesure de température primaire retirée côté KICAD-HT, remplacée par le courant de sortie réel, 2026-10-28) |
| `ADC_11` | `I_Shunt_ht` | 100 Ω | mesure simple |
| `ADC_8` | `I_Shunt_ht_comp` | 22 Ω | chemin comparateur/Trip Zone, Rs ≤ 50 Ω (decision #4) |
| `ADC_12` | `V_bias` | 100 Ω | mesure simple |

`ADC_8` est choisi spécifiquement pour `I_Shunt_ht_comp` (pas un tirage au
sort) : vérifié dans SysConfig (device F28P551, boîtier 64PM) que sa broche
physique (pin 15) est une entrée valide de `CMPSS3` — comparateur
entièrement libre dans ce projet (`CMPSS1`/`CMPSS2` déjà pris par
`I_SHUNT1_CMP`/`I_SHUNT2_CMP`). **La configuration de `CMPSS3` côté firmware
devkit reste à faire — hors périmètre de ce dépôt KiCad**, signalée ici pour
ne pas l'oublier.

**Prérequis appliqué avant de poser les trios** : les 5 labels `ADC_8`-`12`
sur `connecteur_devkit.kicad_sch` ont été renommés en `ADC_8_MCU`-`12_MCU`.
Convention stricte du projet (decision #19, confirmée par l'erratum qu'elle
documente) : le nom brut vit côté nappe/carte, le nom `_MCU` vit côté
connecteur devkit, jamais l'inverse — sinon le trio protège un nœud qui ne va
nulle part, court-circuité par un doublon de label invisible à l'ERC.

**Gabarit de trio repris à l'identique** des 27 existants
(`protections_devkit.kicad_sch`) : BAT54S (clamp `GND`/`3V3_PROT`) + R série +
C 100 pF shunt vers `GND`. Désignateurs `D44`-`D48`, `R50`-`R54`, `C66`-`C70`.

**Trois nouveaux symboles** dans `lib/C2000_Devkit_Connectors.kicad_sym`
(gabarit `NAPPE_ADC1` : une rangée de 20 broches, footprint
`Connector_IDC:IDC-Header_2x10_P2.54mm_Vertical`) : `NAPPE_HV_ADC`,
`NAPPE_HV_DIO`, `NAPPE_FILAMENT_HT`.

**Correction trouvée en implémentant** : un `global_label` avec
`(shape power_in)` — mot-clé invalide, les seules formes valides sont
`input`/`output`/`bidirectional`/`tri_state`/`passive` — fait échouer la
résolution de connectivité ERC sur **toute la broche concernée**, pas
seulement un avertissement cosmétique : les 60 broches neuves remontaient en
`pin_not_connected`/`power_pin_not_driven` avant correction (`bidirectional`
partout), alors que la coïncidence de coordonnée label/broche était pourtant
correcte. À ne pas reproduire sur un futur générateur de label.

**Vérification.** `check_schematic_labels.py` sur les deux nouvelles feuilles
et sur `connecteur_devkit.kicad_sch` : rotation/justify correctes partout
(le seul avertissement — Référence/Valeur empilées sur les gros connecteurs
et les BAT54S — est déjà la norme acceptée sur les 18 nappes et 27 trios
existants, pas une régression). `kicad-cli sch erc` sur `shield.kicad_sch`
entier, comparé **par feuille et par catégorie** à l'état précédent : les
deux nouvelles feuilles ressortent à 0 violation ; les 5 `isolated_pin_label`
sur `ADC_8`-`12` ont disparu ; aucune catégorie n'augmente ailleurs (la
hausse d'`endpoint_off_grid` sur `/` correspond aux mêmes emplacements déjà
connus, pas à de nouvelles broches).

**Hors périmètre** : le PCB n'est pas touché (toujours 0 piste/0 via) ; la
configuration `CMPSS3` côté firmware devkit (projet CCS séparé) reste à
faire.

---

## 27. Isolation numérique ESP32 ↔ STUSB4531 (ISO1640BD + DPC817), et le sous-système USB-PD rejoint le domaine `GND_PRI`

**Décision.** Le bus de supervision I2C/ALERT entre l'ESP32 et le
STUSB4531QTR (`STUSB_SCL`/`STUSB_SDA`/`STUSB_ALERT`, decision USB-PD
existante) reliait jusqu'ici directement GPIO22/23/21 aux pins de U1 —
même net, aucune isolation. Isolé par :
- **`ISO1640BD`** (TI, 8-SOIC, isolation **basique** 3000V<sub>RMS</sub>)
  pour `SCL`/`SDA` — écart assumé par rapport au reste du projet
  (NCM3S1205MC en isolation renforcée), jugé suffisant par l'utilisateur
  pour un bus de supervision sans contrainte sécurité/mains.
- **`DPC817`** (Diodes Inc., optocoupleur SMD SL-4) pour `ALERT` — choisi
  malgré son statut **NRND** ("Not Recommended for New Designs", marqué
  sur la datasheet elle-même) : confirmé après vérification que son
  boîtier est un format générique standard d'optocoupleur 4 broches
  (même famille que PC817/EL817/LTV817), donc remplaçable facilement si
  le composant disparaît du marché.

**Découverte en explorant `usb_pd.kicad_sch` avant de dessiner quoi que ce
soit** : les pull-ups I2C/ALERT existants (`R45`/`R46`/`R47`, 3×4,7kΩ,
decision USB-PD déjà actée) sont tirés vers `3V3_ESP32` — déjà,
électriquement, côté ESP32. Réutilisés tels quels comme pull-ups **Side 1**
de l'isolateur, simplement renommés (`STUSB_SCL`→`ESP32_SCL_ISO`,
`STUSB_SDA`→`ESP32_SDA_ISO`, `STUSB_ALERT`→`ESP32_ALERT_ISO`, côté ESP32
uniquement — les labels sur les pins propres de U1 restent `STUSB_SCL`/
`STUSB_SDA`/`STUSB_ALERT`, Side 2, inchangés).

**`VREG_2V7`** (régulateur interne 2,7V du STUSB4531, déjà un net existant
et découplé) sert de `VCC2` de l'isolateur — dans la plage 2,25-5,5V
acceptée par l'ISO1640 (datasheet §6.3). Pas de régulateur neuf. Pull-ups
Side 2 neufs : **2,2kΩ** (`R55`/`R56`, dans la plage de courant de sortie
Side 2 de l'ISO1640, 0,5-50mA). R_led du DPC817 : **330Ω** (`R57`, limite
le courant LED à ≈4,4mA avec `VREG_2V7`=2,7V et V<sub>F</sub>=1,25V typ,
proche de la condition de caractérisation CTR du DPC817 à 5mA — cohérent
avec la mention déjà actée en decision : `SPRSPC5. Considérer 4 mA`).

**Clarification majeure de l'utilisateur, portée plus large que la seule
isolation ESP32 : `GND` reste côté ESP32/C2000, mais tout
`usb_pd.kicad_sch` (16 occurrences de `GND` — VBUS_IN, protections ESD,
réseau grille T1, décharge, STUSB4531 lui-même, pas seulement `GND2` de
l'isolateur) rejoint `GND_PRI`.** Logique : le sous-système USB-PD (20V
externe) appartient au même domaine « primaire/brut » que le connecteur
11-25V (`J9`, `VIN_PWR`/`GND_PRI`) — **`GND_PRI` devient le retour de masse
principal des cartes filles** côté USB-PD, séparé de `GND` par les
convertisseurs 3,3V existants (même mécanisme que les deux NCM3S1205MC,
rien de neuf à ce niveau-là). Vérifié dans `shield.kicad_pro` : `GND_PRI`
est déjà pattern-matché en `Isole_Primaire` (et `GND` déjà en
`Isole_Secondaire`) — ce renommage suffit à lui seul à requalifier tout le
sous-système, aucune nouvelle entrée `netclass_patterns` nécessaire pour
`GND_PRI` lui-même.

**Hors périmètre, noté pas traité ici** : `VBUS_IN`/`VBUS_OUT`/`CC1`/`CC2`/
etc. restent en classe `Puissance` (largeur de piste), pas `Isole_Primaire`
— la règle de clearance `.kicad_dru` ne les protège donc pas explicitement
contre une piste `Isole_Secondaire` pour l'instant (seul `GND_PRI`
lui-même est couvert). Étendre la règle pour couvrir aussi ces nets est une
décision de routage à prendre plus tard, pas improvisée ici.

**Composants — symboles et empreintes.** `ISO1640BD` absent des
bibliothèques KiCad stock (`Isolator.kicad_sym` n'a que ISO1642/3/4DWR) —
dessiné à la main depuis la Fig. 5-1 de la datasheet (8-SOIC :
`VCC1`(1) `SDA1`(2) `SCL1`(3) `GND1`(4) `GND2`(5) `SCL2`(6) `SDA2`(7)
`VCC2`(8)), empreinte stock `Package_SO:SOIC-8_3.9x4.9mm_P1.27mm`
(dimensions nominales du datasheet, §3 Device Information, concordent).
`DPC817` : brochage et graphisme repris à l'identique du symbole stock
KiCad `PC817` (même silicium, même brochage physique Anode/Cathode/
Émetteur/Collecteur), mais empreinte **dessinée à la main** (`lib/
DPC817.kicad_mod`, SL-4, D=4,60/E1=6,50/e=2,54/E=10,16mm typ — Package
Outline Dimensions p.6) : aucune empreinte stock KiCad ne correspondait
avec confiance aux dimensions réelles du boîtier SMD.

**Bug trouvé en implémentant, à ne pas reproduire** : un `global_label`
avec `(shape power_in)` — mot-clé invalide, les seules formes valides sont
`input`/`output`/`bidirectional`/`tri_state`/`passive` — fait échouer la
résolution de connectivité ERC sur **toute la broche concernée** (pas
seulement un avertissement cosmétique) : les 60 broches neuves de la
tâche précédente (decision #26) remontaient en `pin_not_connected`/
`power_pin_not_driven` avant correction, alors que la coïncidence de
coordonnée label/broche était pourtant juste. Toujours utiliser
`bidirectional` pour les nets d'alimentation en labels-only.

**Caractérisation `composants-datasheets/`** : nouvelle famille
`isolator_digital` ajoutée à `tools/lint_hw.py`/`.claude/rules/
data-yaml.md` (`vcc1_min/max`, `vcc2_min/max`, `viso`, `f_max`, `pd1_max`,
`pd2_max`) — aucune famille existante ne convenait (deux domaines
d'alimentation indépendants, pas comparable à `logic` ni `opto`, même
logique de séparation que `ldo_adj`/`ldo_fixed`). `dpc817.yaml` utilise la
famille `opto` existante ; son champ `ron` est `null` + `todo` (optocoupleur
à sortie phototransistor, pas à sortie FET — `Ron` n'est pas publié par ce
datasheet). `python tools/lint_hw.py data/shield-power/` : les deux
fichiers neufs sortent propres (`dpc817.yaml` : avertissement de
complétude 4/5, attendu et documenté ; `iso1640.yaml` : aucun message).
`ncm3s1205mc.yaml` reste en erreur (famille inconnue préexistante,
`pinmap.positions` absent) — **pas touché, hors périmètre de cette tâche**.

**Vérification.** `check_schematic_labels.py` sur `usb_pd.kicad_sch` et
`connecteur_devkit.kicad_sch` : rotation/justify correctes partout.
`kicad-cli sch erc` sur `shield.kicad_sch` entier, comparé **par feuille et
par catégorie** à l'état précédent : `USB_PD` ne gagne qu'un seul
`power_pin_not_driven` neuf (`GND_PRI` sur `U5`/STUSB4531QTR, attendu —
même caractéristique déjà acceptée que `VIN_PWR`/`GND_PRI` sur `U1`/`U2`/
`U3` de la feuille `DC`, un net primaire sans régulateur on-board pour le
« piloter » au sens ERC) ; le reste de l'écart (`endpoint_off_grid` +4 sur
`/`) correspond au pin 1 des 5 composants neufs, même défaut déjà accepté
partout ailleurs dans le projet (`J1`/`R1`/etc.), pas une régression.

**Hors périmètre** : le PCB n'est pas touché (toujours 0 piste/0 via) ; la
pinmap `DPC817`/`ISO1640BD` n'est pas encore confirmée par capture
d'empreinte réelle (R15, `todo` dans les deux YAML) ; étendre la règle
`.kicad_dru`/`netclass_patterns` à `VBUS_IN`/`VBUS_OUT`/etc. reste à
décider plus tard, au routage.

---

## 28. `DPC817` (U7) remplacé par `TCMT1100` (Vishay) — optocoupleur SMD réellement standard, zéro empreinte maison

**Pourquoi revenir sur la décision #27.** Le `DPC817` choisi en #27 avait
deux défauts qu'une vérification plus poussée a mis en évidence : (1) son
boîtier SMD SL-4 (D=4,60/E1=6,50/e=2,54/E=10,16mm) n'a d'équivalent exact
dans aucune bibliothèque KiCad stock — les deux candidats au bon pas
(`SOP-4_3.8x4.1mm_P2.54mm` à 6,95mm d'envergure et `SOP-4_7.5x4.1mm_
P2.54mm` à 11,2mm) ratent la cible réelle (9,86-10,46mm) de 3,2mm et
0,75mm respectivement, d'où l'empreinte dessinée à la main (`lib/
DPC817.kicad_mod`) ; (2) le composant lui-même est NRND chez le
fabricant. Un boîtier Würth `WL357` (SOP-4 réel, pas-de-broches 2,54mm,
non-NRND) a aussi été vérifié (`datasheets/isolation/WL357-SOP-4.pdf`)
mais son land pattern recommandé (envergure 7,4mm) ne correspond pas non
plus aux footprints stock à 0,45mm près — nécessitait, lui aussi, une
empreinte maison.

**Choix retenu : `TCMT1100` (Vishay, série TCMT110.).** Vérifié contre
`datasheets/isolation/tcmt110.pdf` : boîtier **SSOP-4 "Half Pitch
Mini-Flat"** (pas 1,27mm, pas 2,54mm), associé nativement dans la
bibliothèque KiCad stock elle-même au symbole `Isolator:TCMT1100` +
l'empreinte `Package_SO:SOP-4_4.4x2.6mm_P1.27mm` — **aucune empreinte
maison nécessaire**. Comparaison pad-à-pad contre le land pattern "Possible
footprint" du datasheet (p.7, Fig. 17) : centre de pad stock à 3,1875mm
contre 3,15mm recommandé par Vishay (écart 0,04mm, négligeable — le pad
stock est juste un peu plus large, 1,625mm contre 1,30mm typ, ce qui va
dans le sens de la facilité de brasage, pas d'un défaut). CTR 50-600%
(`IF`=5mA, `VCE`=5V — même condition de test que celle déjà retenue pour
le courant de polarisation du circuit, `R57`=330Ω inchangé), `VISO`=3750V
<sub>RMS</sub> (contre 5000V pour le DPC817 — toujours trois ordres de
grandeur au-dessus du besoin réel d'un bus de supervision basse tension),
pas NRND, bien distribué (Vishay).

**Câblage et brochage inchangés.** `TCMT1100` suit la même convention
universelle Anode(1)/Cathode(2)/Émetteur(3)/Collecteur(4) que `DPC817` et
le symbole stock KiCad place ces 4 broches aux mêmes coordonnées locales
(±7,62mm en X, ±2,54mm en Y) que le symbole `DPC817` fait main — aucune
reprise de câblage nécessaire dans `usb_pd.kicad_sch`, simple
remplacement du `lib_id` et des propriétés Value/Footprint/Datasheet sur
l'instance `U7`. Le label `DPC817_A` (anode, côté `R57`) renommé en
`U7_A` pour ne pas laisser un nom de net périmé.

**PCB.** `U7` déjà posé/orienté (B.Cu, layer 34) depuis la decision #27 —
reconstruit à la main via kipy plutôt que ré-importé ("Update PCB from
Schematic" non exposé par l'API IPC actuelle) : 4 pads repositionnés aux
offsets du footprint stock (±3,1875mm/±0,635mm, tailles 1,625×0,6mm),
silkscreen/courtyard/contour fab reconstruits segment par segment depuis
le fichier stock `SOP-4_4.4x2.6mm_P1.27mm.kicad_mod`, identité de
librairie (`defn.id`) recalée sur `Package_SO:SOP-4_4.4x2.6mm_P1.27mm`.
**Convention de miroir vérifiée empiriquement** (pas supposée) : ce
footprint, posé en B.Cu, a son axe Y inversé par rapport aux coordonnées
brutes du fichier `.kicad_mod` (confirmé sur le marqueur pin-1, seul
élément non symétrique de l'ancien dessin DPC817 — les segments
eux-mêmes ne permettaient pas de trancher, la silhouette étant
accidentellement symétrique en Y).

**DRC après le remplacement, filtré sur `U7`** : plus aucune violation
`lib_footprint_issues` (empreinte introuvable) ; reste un
`lib_footprint_mismatch` mineur (écart cosmétique entre la copie locale
reconstruite à la main et la bibliothèque stock, même famille de message
que les 6 instances déjà préexistantes ailleurs sur le board) et un
`text_height` (même défaut générique que toute empreinte neuve du
projet). Aucun court-circuit, croisement ni violation d'isolation propre
à `U7`.

**Régression découverte en vérifiant, sans lien avec ce remplacement —
signalée, pas corrigée ici** : 72 nouvelles violations `silk_overlap`/
`silk_over_copper` sont apparues entre la session de routage des 5 trios
ADC (decision précédente, hors numérotation) et maintenant, touchant les
champs Référence de `D44`-`D48`/`C66`-`C72`/`R45`-`R47`/`R54`-`R57`/`U6` —
un cluster entièrement différent de `U7`, à une autre zone du board.
Confirmé reproductible (deux lancements DRC consécutifs sur le fichier
inchangé donnent exactement les mêmes 809 violations) donc pas un bruit
de calcul de zone — plausiblement un recalcul du placement automatique
des champs Référence (`fields_autoplaced yes`) déclenché par les
sauvegardes successives de cette session, pas quelque chose que ce
remplacement de `U7` a causé. **Non corrigé** : hors périmètre de la
tâche demandée, à traiter dans une tâche dédiée.

**Caractérisation `composants-datasheets/`** : `data/shield-power/
dpc817.yaml` supprimé (composant retiré du board), remplacé par
`tcmt1100.yaml` (même famille `opto`, mêmes 5 champs) — `t_on`/`t_off`
repris de la table Switching Characteristics p.3 (condition `VS`=5V,
`IC`=2mA, `RL`=100Ω, fig.1, valeurs **typ** seulement, le datasheet ne
publie pas de max pour ces deux champs, à la différence du DPC817) ;
`viso`=3750V p.2 ; `ron`=`null`+`todo` (même rationale que DPC817,
sortie phototransistor). `python tools/lint_hw.py data/` : `tcmt1100.yaml`
sort avec le même avertissement de complétude 4/5 attendu (identique au
`dpc817.yaml` qu'il remplace) ; `docs/hw/dpc817.md` supprimé (généré,
`gen_md.py` ne supprime pas les fichiers orphelins automatiquement).

**Hors périmètre** : la régression de silkscreen signalée ci-dessus ; la
pinmap `TCMT1100` reste non confirmée par capture d'empreinte réelle
(R15, `todo` repris du `dpc817.yaml`).

---

## 29. `VREF_ADC` bufferisé par un suiveur `TLV9151` (U8) + 10Ω série, sur `protections_devkit.kicad_sch`

**Pourquoi.** `VREF_ADC` (le `VREFHI` du C2000, après son propre trio de
protection) fan-out directement vers la nappe ADC-2 pour alimenter la
broche `REFIN` de chaque isolateur ratiométrique AMC0x11R/AMC03xxR des
cartes filles — potentiellement **une dizaine de sorties** en parallèle.
La datasheet AMC0211R/AMC0311R (§8.2.2.2, Fig. 8-3) est explicite : *"The
reference input has a finite input impedance. Consider this impedance
when driving the REFIN pin from a high-impedance source"* — et recommande
un suiveur bufferisé plutôt qu'une connexion directe depuis une source à
impédance non négligeable. Le courant réel en jeu est trivial (`R_REFIN`
81-111kΩ, §6.13 de la datasheet → ≈30-41µA par canal, ≈0,3-0,4mA pour une
dizaine) — ce n'est pas le facteur dimensionnant. Les deux qui le sont :
(1) la précision du suiveur se propage en erreur de gain identique sur
tous les canaux en aval (`REFIN` fixe le plein échelle de chaque AMC) ;
(2) la charge capacitive cumulée des `100nF` de découplage REFIN
recommandés **par carte fille** (même §8.2.2.2) peut dépasser les 1000pF
admissibles en sortie d'un `TLV9151` (§6.17, datasheet TLV9151) dès que
plusieurs cartes sont branchées — d'où `R58` (10Ω série) pour isoler la
sortie du suiveur de cette charge cumulée. L'utilisateur gère séparément
un `10R`+`100nF` en entrée de **chaque** REFIN côté carte fille (hors
périmètre de ce dépôt, à faire sur chaque carte fille).

**Composant : `TLV9151` (U8), pas une nouvelle évaluation.** Déjà utilisé
et caractérisé sur le projet sœur (`data/carte-puissance/tlv9151.yaml`,
4 instances en suiveur de mesure sur le board dual-boost) — mêmes
specs électriques, nouvelle fiche `data/shield-power/tlv9151.yaml` car
contexte/réf différents (U8 ici, refs [2,4,5,6] là-bas). Aucun symbole
stock KiCad pour ce composant — brochage repris du gabarit stock
`NCS325` (même arrangement SOT-23-5 DBV : OUT=1/V-=2/+IN=3/-IN=4/V+=5,
vérifié pin à pin contre la Table 5-1 p.4 de la datasheet TLV9151 avant
réutilisation, même méthode que le remplacement `DPC817`→`TCMT1100` de
la decision #28).

**Topologie.** Le `global_label` de sortie du trio de protection existant
(anciennement `VREF_ADC`, shape `output`) est renommé `VREF_ADC_PREBUF`
pour ne plus atteindre directement la nappe. U8 monté en suiveur
(`-IN`↔`OUT` par fil local, comme les trios R+BAT54S+C existants de cette
feuille) : `+IN`←`VREF_ADC_PREBUF`, `OUT`→`R58`(10Ω)→`VREF_ADC` (nom
repris à l'identique, aucune autre feuille/documentation à modifier).
Alimenté par `3V3_PROT` (seul rail 3,3V local disponible sur cette
feuille) + découplage `C73` (100nF), même convention que tous les autres
CI du projet.

**DRC... non, ERC.** Filtré sur `U8`/`R58`/`C73`/`VREF_ADC`/
`VREF_ADC_PREBUF` : +9 par rapport à l'état précédent, toutes dans des
catégories déjà massivement préexistantes ailleurs dans le projet et
déjà acceptées — `endpoint_off_grid` (7, même défaut « pin 1 » déjà noté
aux decisions #27/#28, plus des segments de fil de quelques dixièmes de
mm déjà présents sur de nombreux trios existants de cette même feuille,
pas une régression), `power_pin_not_driven` (1, `U8`/`V-`/`GND` — même
caractéristique déjà acceptée pour `U1`-`U3`/`U5` sur la feuille `DC`,
un net primaire sans régulateur local pour le « piloter » au sens ERC),
`lib_symbol_mismatch` (1, déjà 1 instance préexistante pour `U7`/
`TCMT1100` — écart cosmétique copie-locale vs bibliothèque, inhérent à
toute réutilisation d'un gabarit stock). Aucun court-circuit, aucune
broche non connectée de façon inattendue.

**Hors périmètre** : PCB non touché (placement/routage de `U8`/`R58`/
`C73` à faire via kipy, KiCad ouvert, pas encore fait) ; pinmap `TLV9151`
non confirmée par capture d'empreinte réelle (R15) ; le `10R`+`100nF`
par carte fille reste à la charge de l'utilisateur, sur chaque carte
fille, pas dans ce dépôt.

---

## 30. U2/U3 (NCM3S1205MC) câblés à l'envers, entrée et sortie — détecté en revue

**Défaut.** Sur `dc.kicad_sch`, les broches 1/2 (entrée) et 3/4 (sortie) de
U2 et U3 étaient câblées sur le net opposé à leur fonction réelle :
`VIN_PWR` (positif) atterrissait sur la broche `-VIN`, `GND_PRI` (retour)
sur `+VIN` ; côté sortie, `+VOUT` rejoignait `GND` et `-VOUT` rejoignait
`5V_ISO`/`5V_NUM`. Corrigé par permutation des 8 étiquettes globales
posées sur ces broches (commit `22663de`) — ni le symbole, ni les
numéros de broche, ni l'empreinte n'ont changé.

**Conséquence si non détecté.** Entrée inversée sur un module dont la
datasheet ne mentionne pas de protection contre l'inversion de polarité
(Murata KDC_NCM3_A01, liste des fonctions p.1) : destruction probable à
la mise sous tension. Sortie inversée : `5V_ISO`/`5V_NUM` se seraient
présentés à **-5V** par rapport à `GND`, pas +5V — tout ce qui en aval
attend une alimentation positive (LDO U1, rails numériques) aurait été
endommagé ou non fonctionnel.

**Preuve physique.** Datasheet Murata KDC_NCM3_A01 p.10 (« Pin
Connections » + vue de dessous) : `1=-Vin, 2=+Vin, 3=+Vout, 4=-Vout`,
confirmé par les cotes de l'empreinte (pastilles 2/3 = 4,8mm ↔ broches
2/3 = 4,75mm ; 1/4 = 3,55 ↔ 3,50 ; entraxe 6,75 ; 5,10 au bord ; ordre
1→4 antihoraire en vue de dessus) — `lib/NCM3S1205MC.kicad_mod` suit
cette numérotation. Confirmé indépendamment par le chemin réel du
schéma, entrée et retour :

- `J9` (positif) → `VIN_PWR` → enroulement `FL3`/`FL4` broches 2→3 →
  `U2_VINF`/`U3_VINF`
- `J9` (retour) → `GND_PRI` → enroulement `FL3`/`FL4` broches 1→4 →
  `U2_GNDF`/`U3_GNDF`

**Rectification de la décision #21(b).** Sa phrase *« +VOUT (U2 ET U3,
broche 3) sert de driver implicite du net GND... ce n'est pas un
artefact du modèle téléchargé, c'est un choix électrique déjà en
place »* décrivait en réalité le **symptôme** de ce défaut, pas un choix
assumé — le `pin_to_pin` de l'ERC sur cette broche (deux `Power output`
connectées) le signalait déjà à l'époque de #21, mais a été interprété
comme une exception à accepter plutôt que comme une alerte à
investiguer. #21 n'est pas réécrite ; cette entrée en corrige la lecture.

**Piège à retenir.** Une première tentative de correction (renommer les
étiquettes du *symbole* pour qu'elles collent au câblage existant) a été
faite et annulée : comparer l'empreinte au symbole ne prouve rien, la
pastille N porte le nom de la broche N par construction, quel que soit
le câblage réel — les deux sources dérivent l'une de l'autre, pas d'une
preuve indépendante. Seule la comparaison **position physique du
datasheet ↔ câblage réel du schéma** fait foi. Ne jamais renommer une
broche pour faire « coller » un schéma.

**Vérification.**
- `kicad-cli sch erc` : 314 → **313** violations. Le `pin_to_pin` sur la
  broche 3 a disparu (U2/U3 n'y partagent plus `GND` à deux `Power
  output`) ; l'autre écart vient d'une imprécision de placement
  préexistante depuis l'origine du projet sur l'étiquette `U3_VINF`
  (posée à 0,03/0,06mm de la broche 2 réelle, pontée par un micro-fil
  déjà présent dans l'historique) — recalée exactement sur la broche,
  fil retiré, sans rapport électrique avec le défaut ci-dessus (commit
  `23b5b2a`).
- Netlist (`kicad-cli sch export netlist`) : `U2 : 1→U2_GNDF, 2→U2_VINF,
  3→5V_ISO, 4→GND` ; `U3 : 1→U3_GNDF, 2→U3_VINF, 3→5V_NUM, 4→GND`.
- PCB mis à jour depuis le schéma (F8, commit `6904387`) : pastilles
  U2/U3 vérifiées sur les mêmes nets que la netlist ci-dessus.
  `kicad-cli pcb drc` : 464 → 463 violations, seule disparaît une
  catégorie sans rapport (`lib_footprint_issues`, bibliothèque
  `artwork`) ; les `clearance`/`shorting_items`/`solder_mask_bridge`
  touchant les pastilles U2/U3/C27/C28/C36 sont strictement identiques
  avant/après — U2/U3 ne sont pas routés à ce stade (décision #21(a)),
  la réaffectation de net ne modifie aucune piste.

**Ce qui casse si on la défait.** Revenir au câblage d'avant
reproduirait exactement le défaut ci-dessus — entrée et sortie à
l'envers sur un convertisseur isolé non protégé contre l'inversion.

---

## Points ouverts — ne pas combler par une estimation

Ces valeurs manquent. Elles demandent une lecture de datasheet ou une mesure,
pas une approximation plausible.

- Broches de mode de démarrage des deux MCU : à lire dans le manuel technique.
- `VREFHI` en mode externe : plage, impédance de source, courant. Et le choix
  2,5 V ou 3,0 V, selon la pleine échelle des AMC.
- Courant de sortie GPIO : le mode 20 mA du F28P551 n'est pas confirmé dans
  SPRSPC5. Considérer 4 mA — les DPC817 à 5 mA imposeraient alors un buffer
  côté shield.
- État au reset de GPIO39 (LED, PCB F280037).
- Caractéristiques de sortie des AMC0311S et AMC0300R : impédance, pleine
  échelle, bande passante — pour dimensionner les filtres sous Rs ≤ 50 Ω.
- Courant d'entrée du REFIN des AMC0300R, pour le suiveur.
- Nombre de banques Flash des deux MCU, pour le FOTA.
- Débit SCI maximal accepté par l'autobaud du bootloader : il fixe la durée
  d'indisponibilité pendant une mise à jour.
- Matériel LFU dédié sur le F28P551 : documenté pour le F28003x, à confirmer.
- Répartition exacte des plans sur la version 4 couches : masse pleine en
  couche 2 est acquis, la couche 3 reste à décider (alimentation, ou seconde
  masse sous la zone analogique).
- Budget de courant des deux rails 5V des NCM3S1205MC (600mA dispo chacun) —
  #1 face à 2 devkits + OLED, #2 face au LDO 3,3V + la consommation réelle
  des cartes DC/DC côté isolation, inconnue tant qu'aucune carte fille n'est
  spécifiée (§13).
- Modèle de LDO 3,3V exact et valeur de la zener de protection — dépend du
  courant réel tiré par les cartes DC/DC connectées, et du courant de
  court-circuit du LDO en panne une fois choisi (§13).
- Référence exacte du connecteur d'alimentation 11-25V (type, tenue en
  courant) — pas encore choisie.
