Nicolboy/KICAD-C2000-powershield/doc/shield1.png

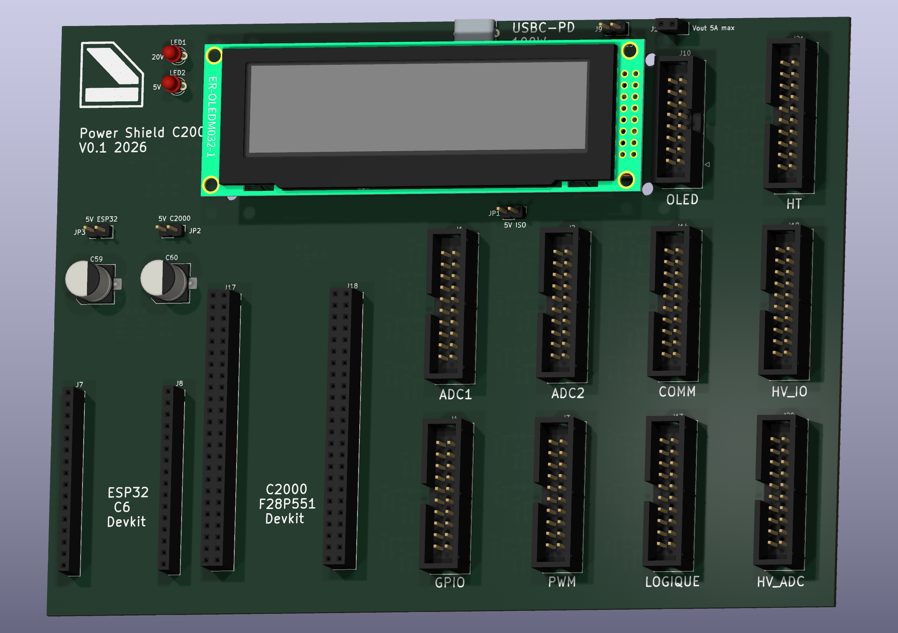
doc/shield1.png
