Nicolboy/KICAD-C2000-powershield/doc/shield3.png

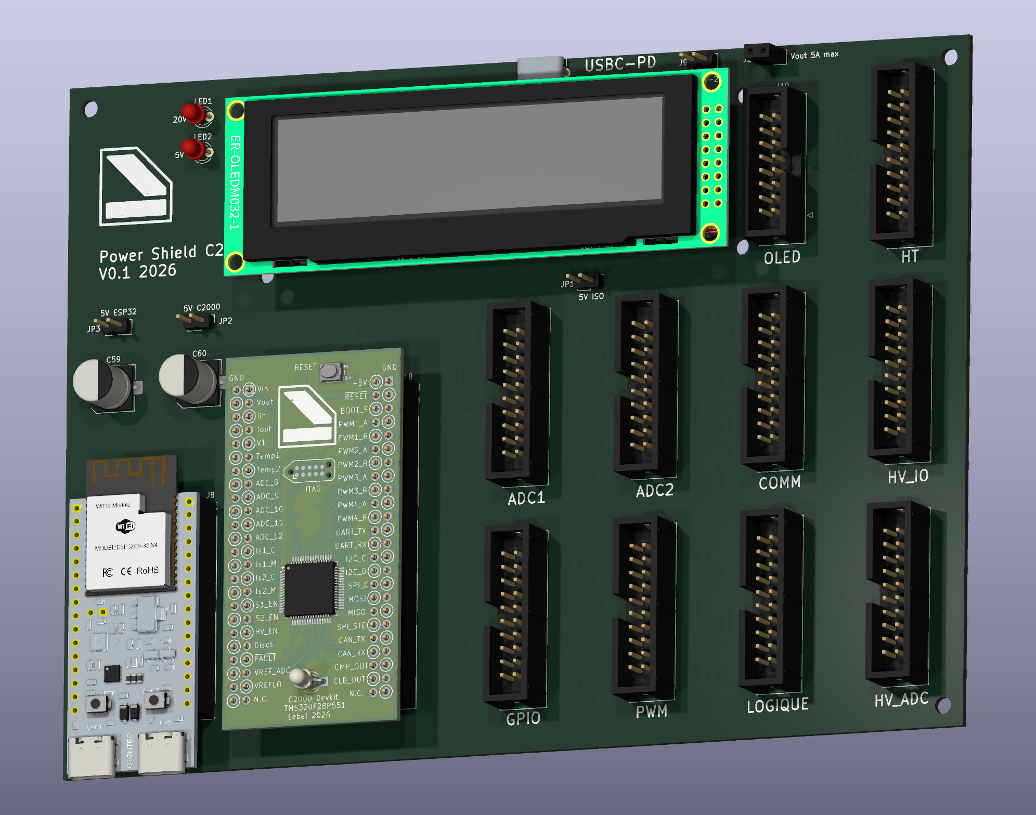
doc/shield3.png
