Nicolboy/KICAD-C2000-powershield/shield.kicad_pcb

## KiCad design shield.kicad_pcb (2026-11-11)

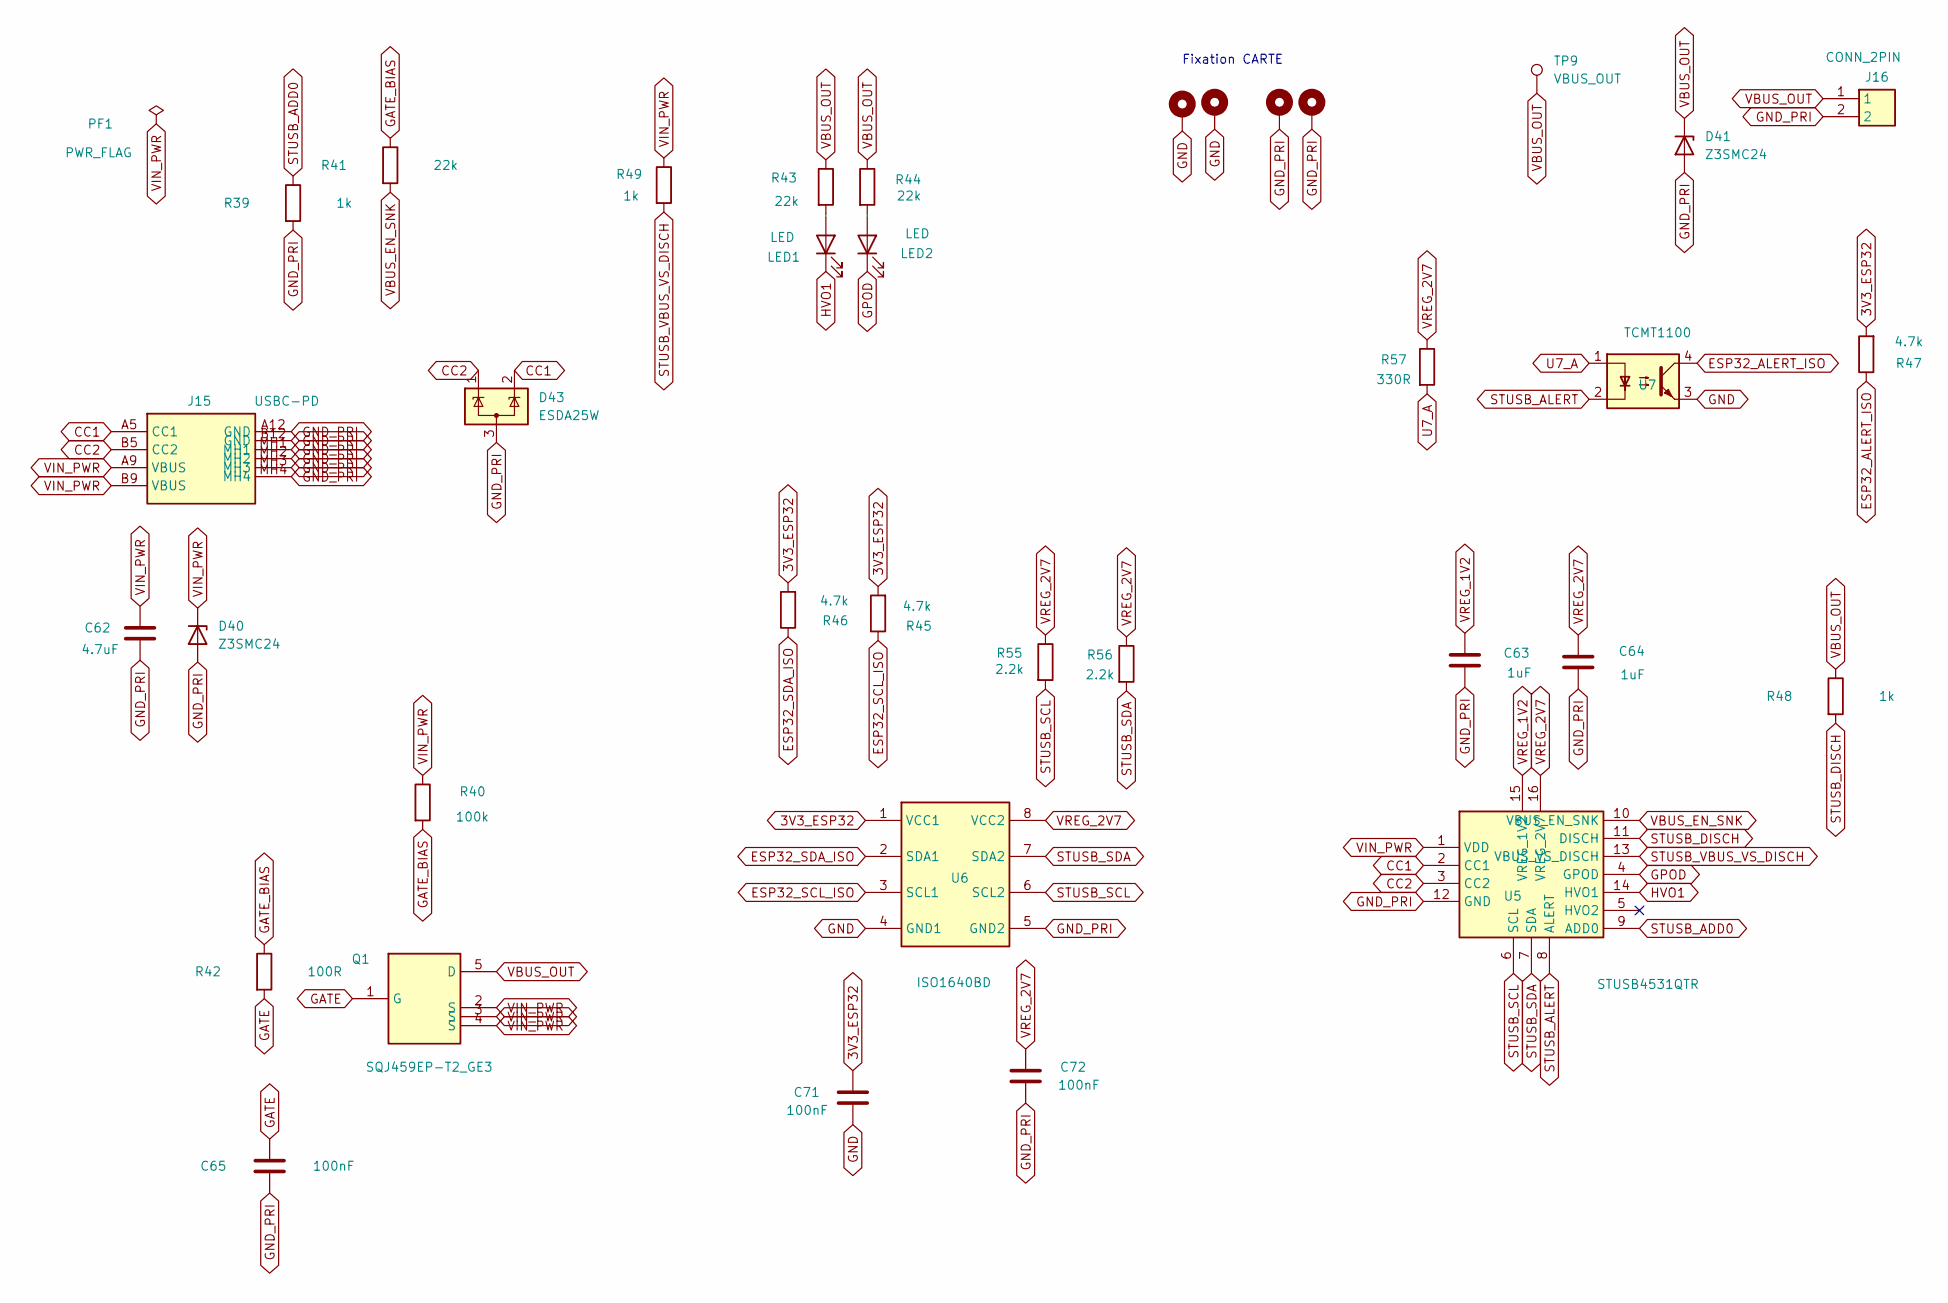
[picture p4: schematic usb_pd.kicad_sch, Alimentation USB-C Power Delivery (100W/20V/5A)]

Parts:
C62: 4.7uF; C_0805_2012Metric
C63, C64: 1uF; C_0805_2012Metric
C65, C71, C72: 100nF; C_0805_2012Metric
D40, D41: Z3SMC24; D_SMC
D43: ESDA25W; SOT-23-3
H1, H2, H3, H4: MountingScrew; MountingHole_3.2mm_M3_Pad_Via
J15: USBC-PD; 632722100213
J16: CONN_2PIN; PinSocket_1x02_P2.54mm_Vertical
LED1, LED2: LED; LED_D3.0mm
PF1: PWR_FLAG
Q1: SQJ459EP-T2_GE3; PowerPAK_SO-8_Single
R39, R48, R49: 1k; R_0805_2012Metric
R40: 100k; R_0805_2012Metric
R41, R43, R44: 22k; R_0805_2012Metric
R42: 100R; R_0805_2012Metric
R45, R46, R47: 4.7k; R_0805_2012Metric
R55, R56: 2.2k; R_0805_2012Metric
R57: 330R; R_0805_2012Metric
TP9: VBUS_OUT; TestPoint_Pad_D2.5mm
U5: STUSB4531QTR
U6: ISO1640BD; SOIC-8_3.9x4.9mm_P1.27mm
U7: TCMT1100; SOP-4_4.4x2.6mm_P1.27mm

Connections:
3V3_ESP32: C71.1, R45.2, R46.2, R47.2, U6.1 (VCC1); also elsewhere on the board
CC1: D43.2 (K), J15.A5 (CC1), U5.2 (CC1)
CC2: D43.1 (K), J15.B5 (CC2), U5.3 (CC2)
ESP32_ALERT_ISO: R47.1, U7.4; also elsewhere on the board
ESP32_SCL_ISO: R45.1, U6.3 (SCL1); also elsewhere on the board
ESP32_SDA_ISO: R46.1, U6.2 (SDA1); also elsewhere on the board
GATE: C65.1, Q1.1 (G), R42.2
GATE_BIAS: R40.2, R41.1, R42.1
GND: C71.2, H1.1 (1_1), H2.1 (1_1), U6.4 (GND1), U7.3; also elsewhere on the board
GND_PRI: C62.2, C63.2, C64.2, C65.2, C72.2, D40.2 (A), D41.2 (A), D43.3 (A), H3.1 (1_1), H4.1 (1_1), J15.A12 (GND), J15.B12 (GND), J15.MH1, J15.MH2, J15.MH3, J15.MH4, J16.2, R39.2, U5.12 (GND), U6.5 (GND2); also elsewhere on the board
GPOD: LED2.1 (K), U5.4 (GPOD)
HVO1: LED1.1 (K), U5.14 (HVO1)
unnamed: LED1.2 (A), R43.2
unnamed: LED2.2 (A), R44.2
STUSB_ADD0: R39.1, U5.9 (ADD0)
STUSB_ALERT: U5.8 (ALERT), U7.2
STUSB_DISCH: R48.2, U5.11 (DISCH)
STUSB_SCL: R55.2, U5.6 (SCL), U6.6 (SCL2)
STUSB_SDA: R56.2, U5.7 (SDA), U6.7 (SDA2)
STUSB_VBUS_VS_DISCH: R49.2, U5.13 (VBUS_VS_DISCH)
U7_A: R57.2, U7.1
VBUS_EN_SNK: R41.2, U5.10 (VBUS_EN_SNK)
VBUS_OUT: D41.1 (K), J16.1, Q1.5 (D), R43.1, R44.1, R48.1, TP9.1 (1_1)
VIN_PWR: C62.1, D40.1 (K), J15.A9 (VBUS), J15.B9 (VBUS), PF1.1, Q1.2 (S), Q1.3 (S), Q1.4 (S), R40.1, R49.1, U5.1 (VDD); also elsewhere on the board
VREG_1V2: C63.1, U5.15 (VREG_1V2)
VREG_2V7: C64.1, C72.1, R55.1, R56.1, R57.1, U5.16 (VREG_2V7), U6.8 (VCC2)

Notes on the sheet:
Fixation CARTE

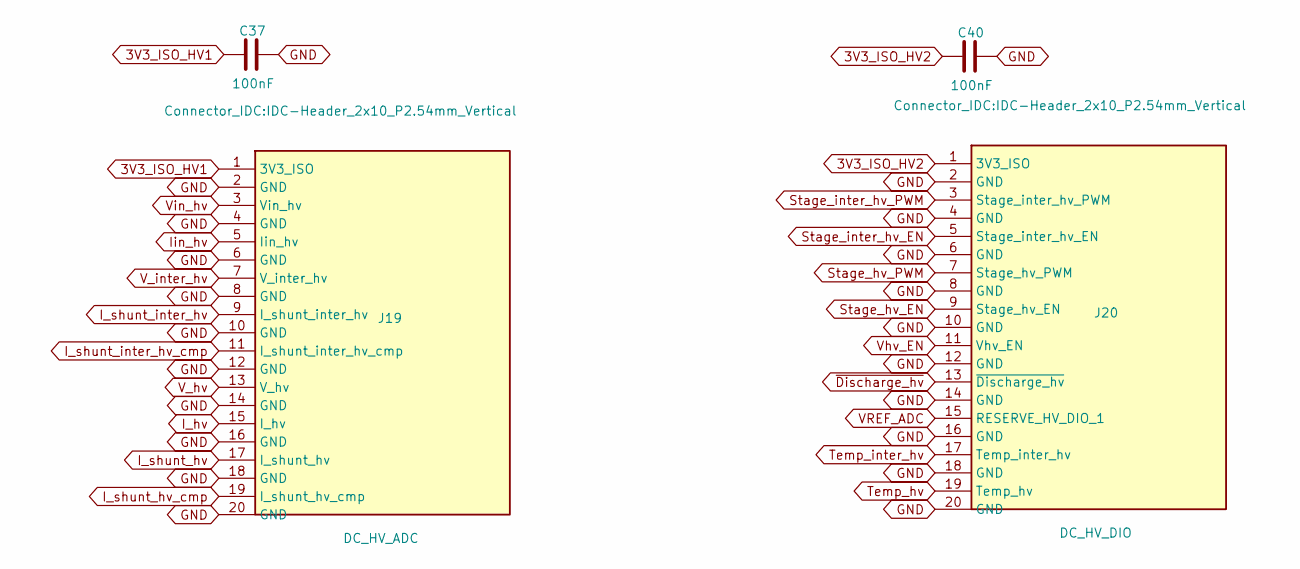
[picture p5: schematic connecteur_carte_hv.kicad_sch]

Parts:
C37, C40: 100nF; C_0805_2012Metric
J19: DC_HV_ADC; IDC-Header_2x10_P2.54mm_Vertical
J20: DC_HV_DIO; IDC-Header_2x10_P2.54mm_Vertical

Connections:
3V3_ISO_HV1: C37.1, J19.1 (3V3_ISO); also elsewhere on the board
3V3_ISO_HV2: C40.1, J20.1 (3V3_ISO); also elsewhere on the board
GND: C37.2, C40.2, J19.2 (GND), J19.4 (GND), J19.6 (GND), J19.8 (GND), J19.10 (GND), J19.12 (GND), J19.14 (GND), J19.16 (GND), J19.18 (GND), J19.20 (GND), J20.2 (GND), J20.4 (GND), J20.6 (GND), J20.8 (GND), J20.10 (GND), J20.12 (GND), J20.14 (GND), J20.16 (GND), J20.18 (GND), J20.20 (GND); also elsewhere on the board
I_hv: J19.15 (I_hv); also elsewhere on the board
I_shunt_hv: J19.17 (I_shunt_hv); also elsewhere on the board
I_shunt_hv_cmp: J19.19 (I_shunt_hv_cmp); also elsewhere on the board
I_shunt_inter_hv: J19.9 (I_shunt_inter_hv); also elsewhere on the board
I_shunt_inter_hv_cmp: J19.11 (I_shunt_inter_hv_cmp); also elsewhere on the board
Iin_hv: J19.5 (Iin_hv); also elsewhere on the board
Stage_hv_EN: J20.9 (Stage_hv_EN); also elsewhere on the board
Stage_hv_PWM: J20.7 (Stage_hv_PWM); also elsewhere on the board
Stage_inter_hv_EN: J20.5 (Stage_inter_hv_EN); also elsewhere on the board
Stage_inter_hv_PWM: J20.3 (Stage_inter_hv_PWM); also elsewhere on the board
Temp_hv: J20.19 (Temp_hv); also elsewhere on the board
Temp_inter_hv: J20.17 (Temp_inter_hv); also elsewhere on the board
VREF_ADC: J20.15 (RESERVE_HV_DIO_1); also elsewhere on the board
V_hv: J19.13 (V_hv); also elsewhere on the board
V_inter_hv: J19.7 (V_inter_hv); also elsewhere on the board
Vhv_EN: J20.11 (Vhv_EN); also elsewhere on the board
Vin_hv: J19.3 (Vin_hv); also elsewhere on the board
~Discharge_hv: J20.13 (~Discharge_hv); also elsewhere on the board

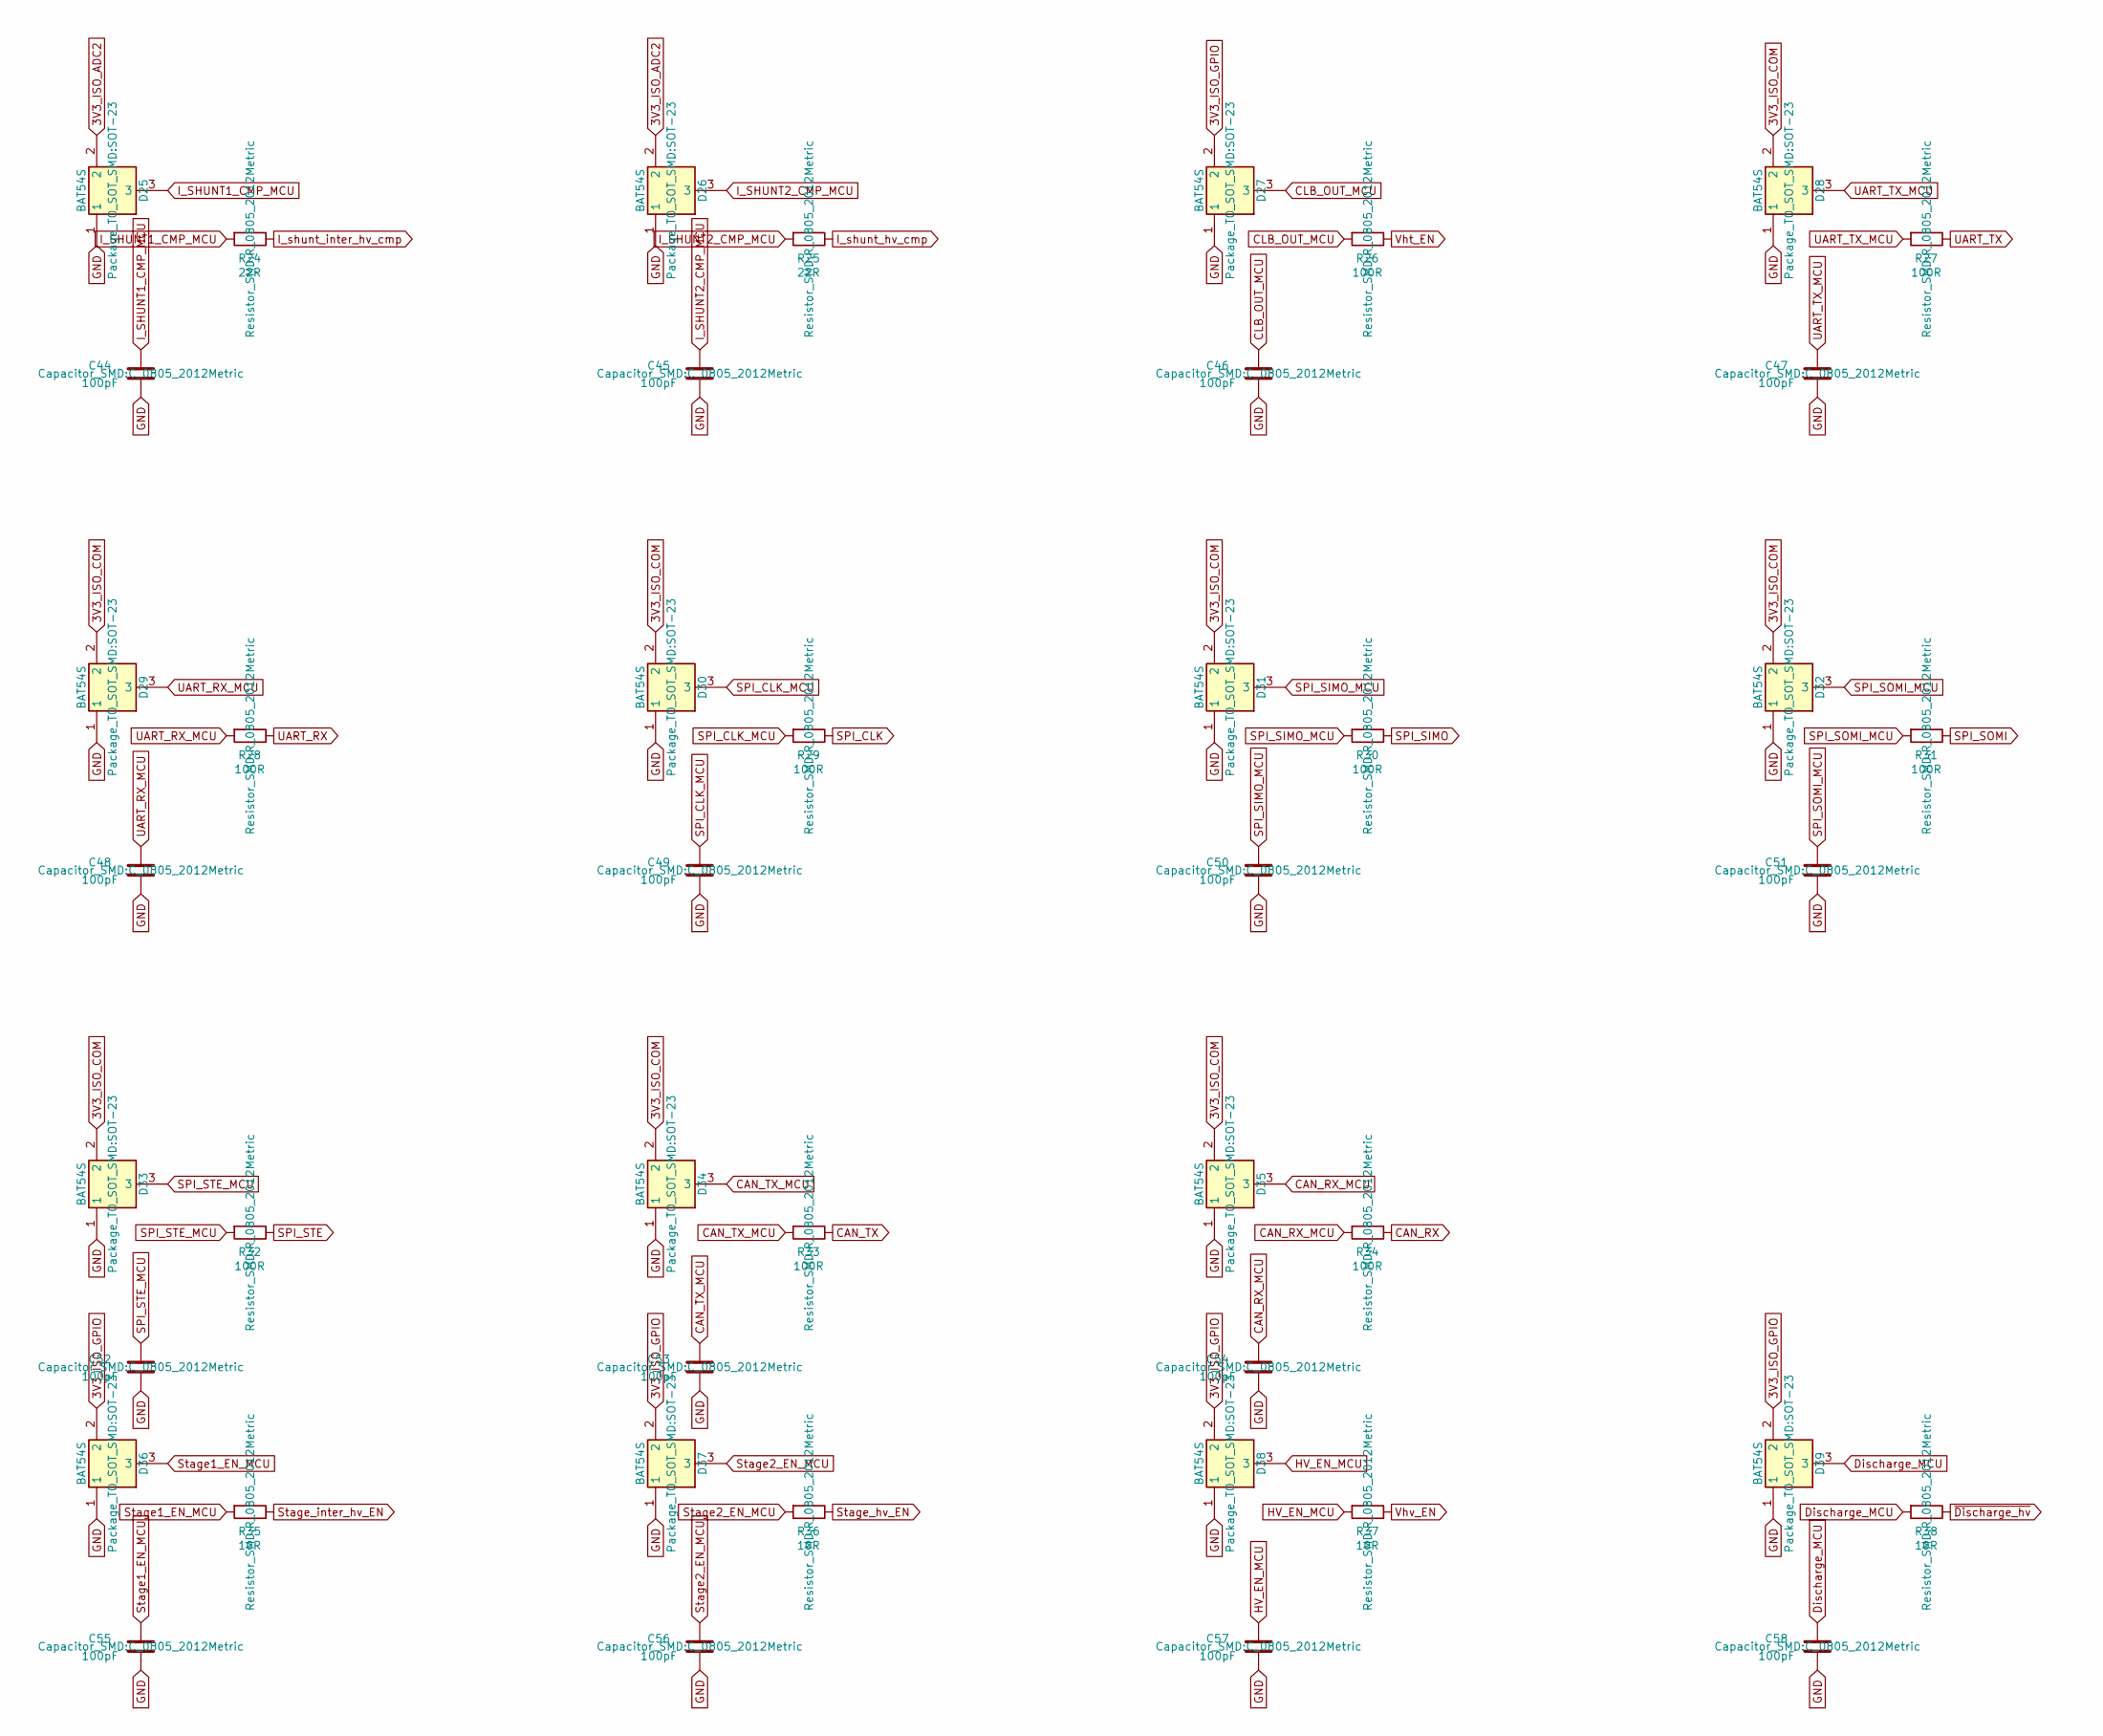
[picture p6: schematic protection_nappe.kicad_sch, Protection nappe - signaux bus et CLB_OUT/I_SHUNT*_CMP]

Parts:
C44, C45, C46, C47, C48, C49, C50, C51, C52, C53, C54, C55, C56, C57, C58: 100pF; C_0805_2012Metric
D25, D26, D27, D28, D29, D30, D31, D32, D33, D34, D35, D36, D37, D38, D39: BAT54S; SOT-23
R24, R25: 22R; R_0805_2012Metric
R26, R27, R28, R29, R30, R31, R32, R33, R34: 100R; R_0805_2012Metric
R35, R36, R37, R38: 10R; R_0805_2012Metric

Connections:
3V3_ISO_ADC2: D25.2, D26.2; also elsewhere on the board
3V3_ISO_COM: D28.2, D29.2, D30.2, D31.2, D32.2, D33.2, D34.2, D35.2; also elsewhere on the board
3V3_ISO_GPIO: D27.2, D36.2, D37.2, D38.2, D39.2; also elsewhere on the board
CAN_RX: R34.1; also elsewhere on the board
CAN_RX_MCU: C54.2, D35.3, R34.2; also elsewhere on the board
CAN_TX: R33.1; also elsewhere on the board
CAN_TX_MCU: C53.2, D34.3, R33.2; also elsewhere on the board
CLB_OUT_MCU: C46.2, D27.3, R26.2; also elsewhere on the board
Discharge_MCU: C58.2, D39.3, R38.2; also elsewhere on the board
GND: C44.1, C45.1, C46.1, C47.1, C48.1, C49.1, C50.1, C51.1, C52.1, C53.1, C54.1, C55.1, C56.1, C57.1, C58.1, D25.1, D26.1, D27.1, D28.1, D29.1, D30.1, D31.1, D32.1, D33.1, D34.1, D35.1, D36.1, D37.1, D38.1, D39.1; also elsewhere on the board
HV_EN_MCU: C57.2, D38.3, R37.2; also elsewhere on the board
I_SHUNT1_CMP_MCU: C44.2, D25.3, R24.2; also elsewhere on the board
I_SHUNT2_CMP_MCU: C45.2, D26.3, R25.2; also elsewhere on the board
I_shunt_hv_cmp: R25.1; also elsewhere on the board
I_shunt_inter_hv_cmp: R24.1; also elsewhere on the board
SPI_CLK: R29.1; also elsewhere on the board
SPI_CLK_MCU: C49.2, D30.3, R29.2; also elsewhere on the board
SPI_SIMO: R30.1; also elsewhere on the board
SPI_SIMO_MCU: C50.2, D31.3, R30.2; also elsewhere on the board
SPI_SOMI: R31.1; also elsewhere on the board
SPI_SOMI_MCU: C51.2, D32.3, R31.2; also elsewhere on the board
SPI_STE: R32.1; also elsewhere on the board
SPI_STE_MCU: C52.2, D33.3, R32.2; also elsewhere on the board
Stage1_EN_MCU: C55.2, D36.3, R35.2; also elsewhere on the board
Stage2_EN_MCU: C56.2, D37.3, R36.2; also elsewhere on the board
Stage_hv_EN: R36.1; also elsewhere on the board
Stage_inter_hv_EN: R35.1; also elsewhere on the board
UART_RX: R28.1; also elsewhere on the board
UART_RX_MCU: C48.2, D29.3, R28.2; also elsewhere on the board
UART_TX: R27.1; also elsewhere on the board
UART_TX_MCU: C47.2, D28.3, R27.2; also elsewhere on the board
Vht_EN: R26.1; also elsewhere on the board
Vhv_EN: R37.1; also elsewhere on the board
~Discharge_hv: R38.1; also elsewhere on the board

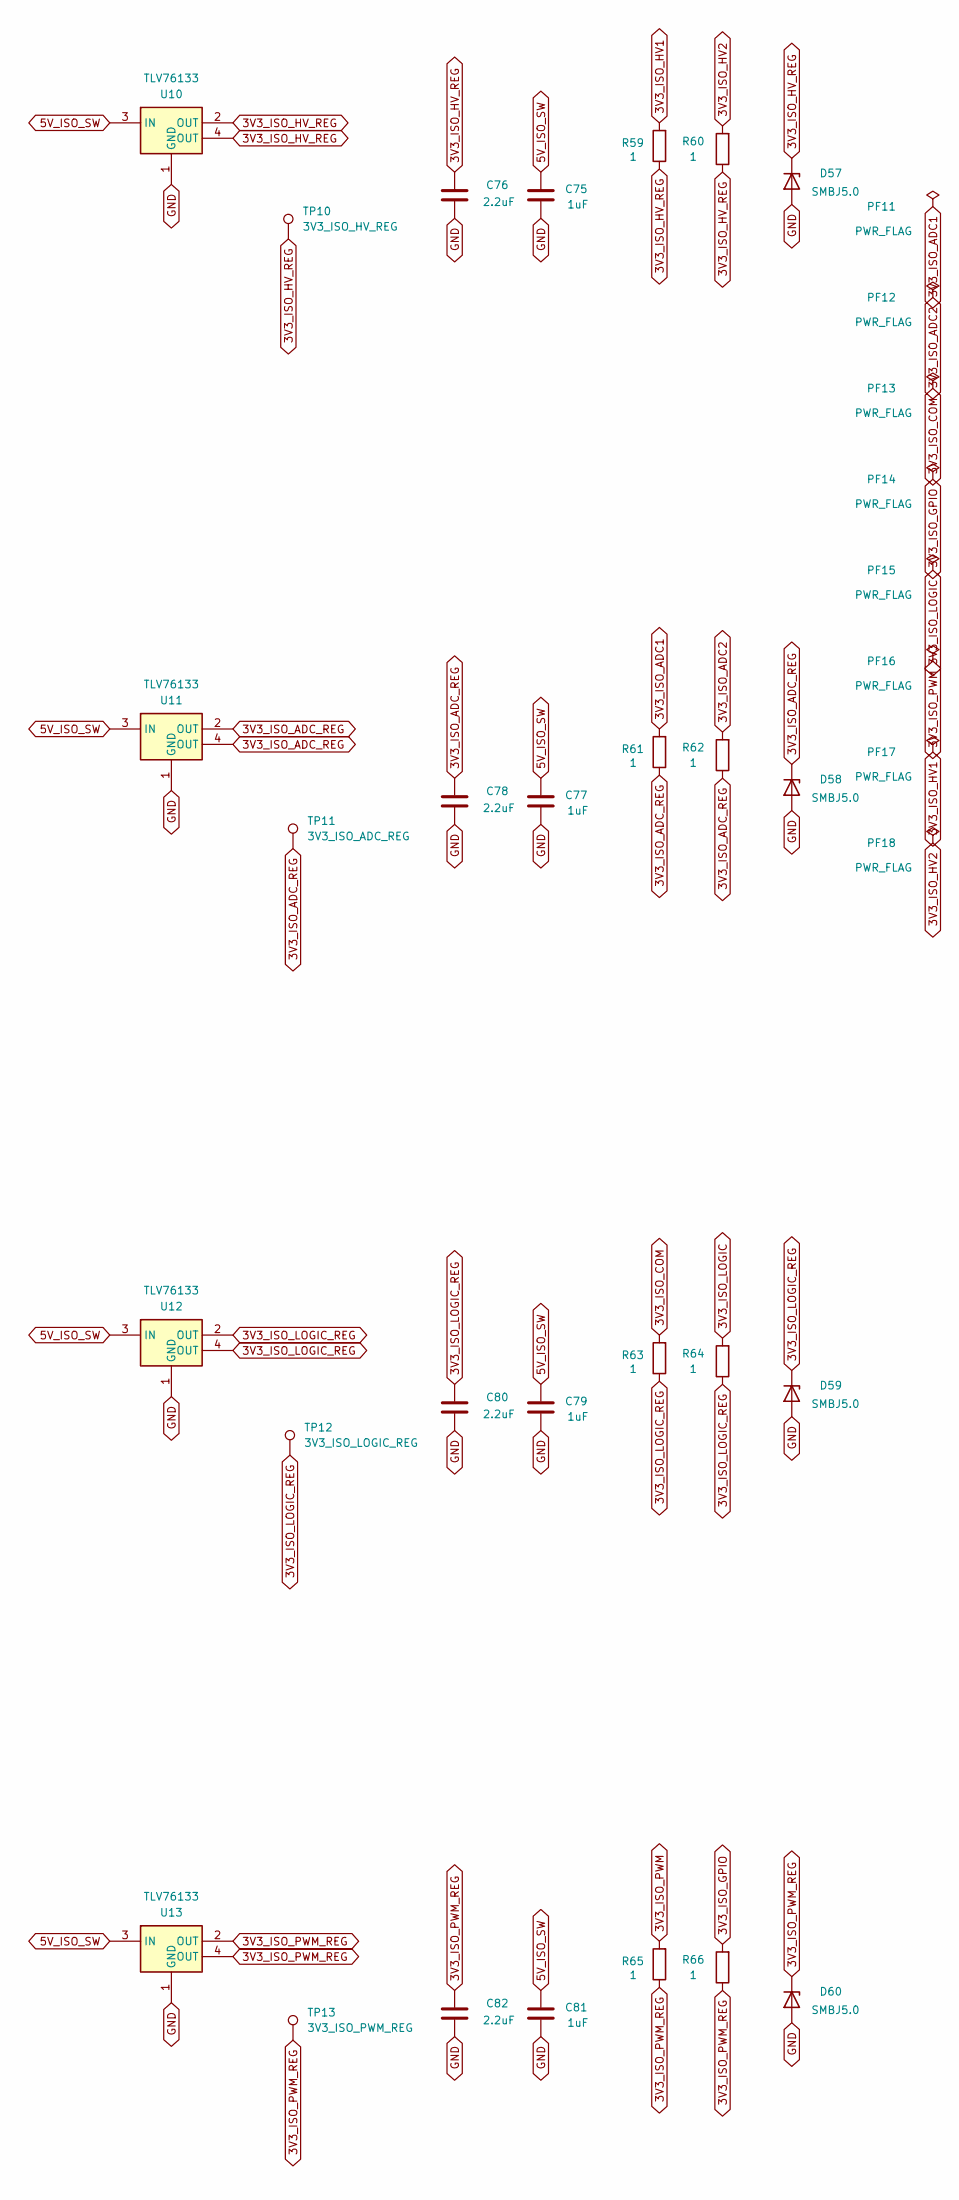
[picture p7: schematic 3v3_iso.kicad_sch, 3V3_ISO — distribution regulee, 4 TLV76133 + protection]

Parts:
C75, C77, C79, C81: 1uF; C_0805_2012Metric
C76, C78, C80, C82: 2.2uF; C_0805_2012Metric
D57, D58, D59, D60: SMBJ5.0; D_SMB
PF11, PF12, PF13, PF14, PF15, PF16, PF17, PF18: PWR_FLAG
R59, R60, R61, R62, R63, R64, R65, R66: 1; R_0805_2012Metric
TP10: 3V3_ISO_HV_REG; TestPoint_Pad_D2.5mm
TP11: 3V3_ISO_ADC_REG; TestPoint_Pad_D2.5mm
TP12: 3V3_ISO_LOGIC_REG; TestPoint_Pad_D2.5mm
TP13: 3V3_ISO_PWM_REG; TestPoint_Pad_D2.5mm
U10, U11, U12, U13: TLV76133; SOT-223

Connections:
3V3_ISO_ADC1: PF11.1, R61.2; also elsewhere on the board
3V3_ISO_ADC2: PF12.1, R62.2; also elsewhere on the board
3V3_ISO_ADC_REG: C78.1, D58.1 (K), R61.1, R62.1, TP11.1 (1_1), U11.2 (OUT), U11.4 (OUT)
3V3_ISO_COM: PF13.1, R63.2; also elsewhere on the board
3V3_ISO_GPIO: PF14.1, R66.2; also elsewhere on the board
3V3_ISO_HV1: PF17.1, R59.2; also elsewhere on the board
3V3_ISO_HV2: PF18.1, R60.2; also elsewhere on the board
3V3_ISO_HV_REG: C76.1, D57.1 (K), R59.1, R60.1, TP10.1 (1_1), U10.2 (OUT), U10.4 (OUT)
3V3_ISO_LOGIC: PF15.1, R64.2; also elsewhere on the board
3V3_ISO_LOGIC_REG: C80.1, D59.1 (K), R63.1, R64.1, TP12.1 (1_1), U12.2 (OUT), U12.4 (OUT)
3V3_ISO_PWM: PF16.1, R65.2; also elsewhere on the board
3V3_ISO_PWM_REG: C82.1, D60.1 (K), R65.1, R66.1, TP13.1 (1_1), U13.2 (OUT), U13.4 (OUT)
5V_ISO_SW: C75.1, C77.1, C79.1, C81.1, U10.3 (IN), U11.3 (IN), U12.3 (IN), U13.3 (IN); also elsewhere on the board
GND: C75.2, C76.2, C77.2, C78.2, C79.2, C80.2, C81.2, C82.2, D57.2 (A), D58.2 (A), D59.2 (A), D60.2 (A), U10.1 (GND), U11.1 (GND), U12.1 (GND), U13.1 (GND); also elsewhere on the board

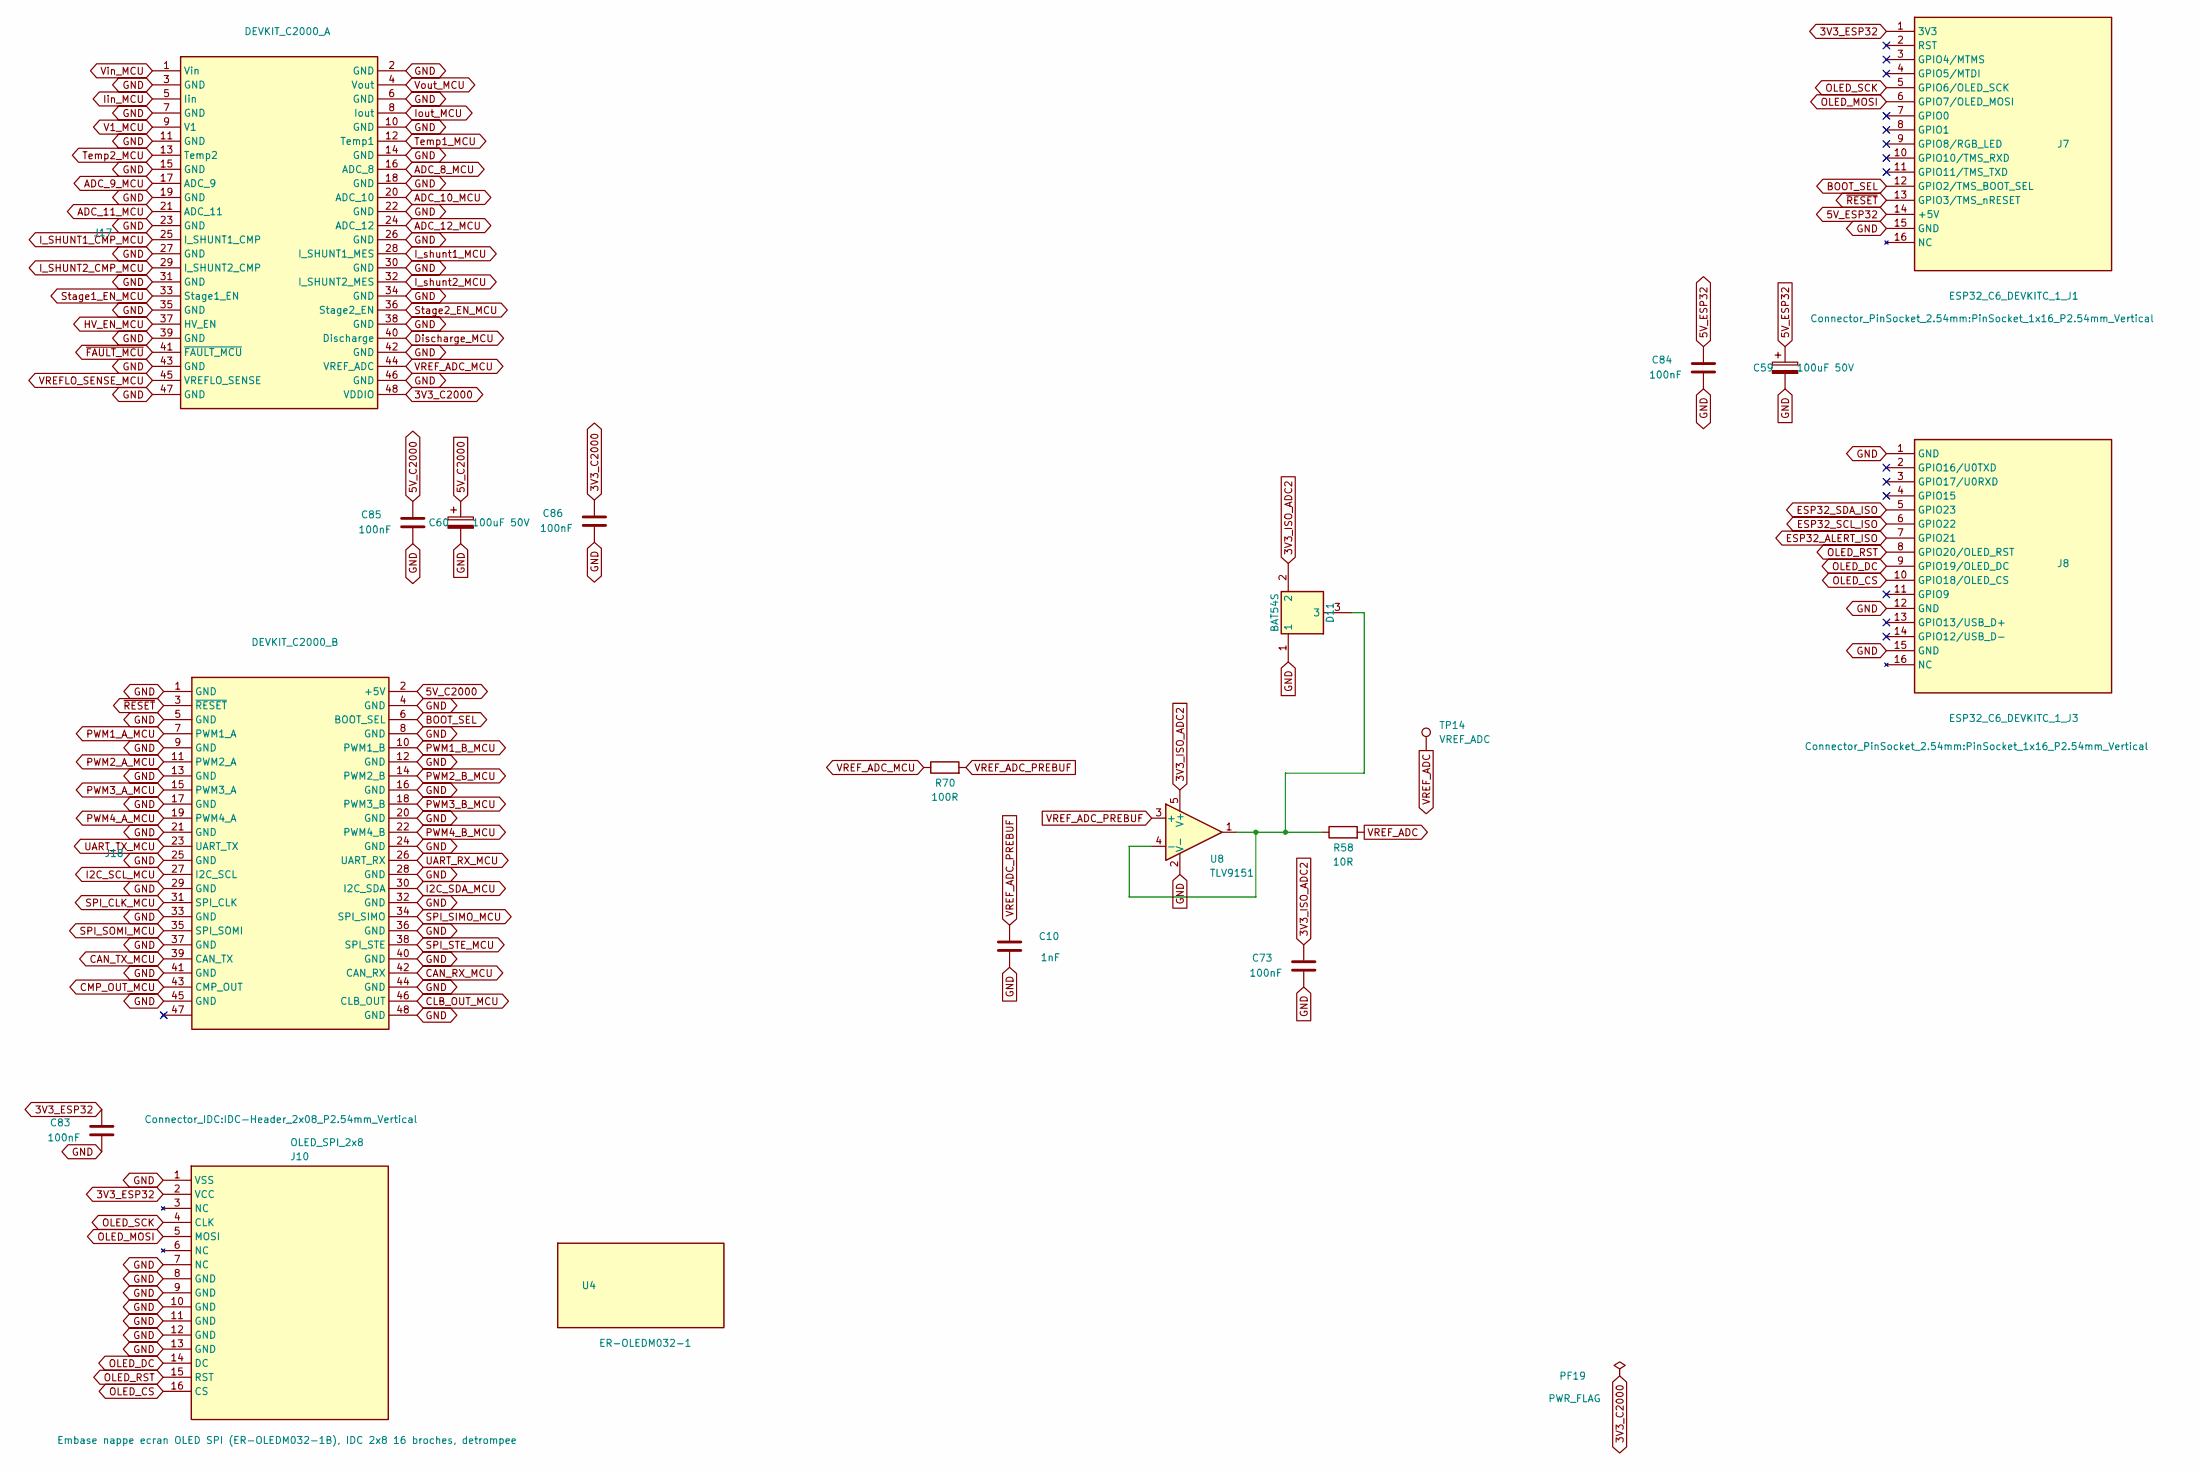
[picture p8: schematic connecteur_devkit.kicad_sch, Connecteurs devkit (C2000 Row A/B, ESP32-C6 J1/J3)]

Parts:
C10: 1nF; C_0805_2012Metric
C59, C60: 100uF 50V; CP_Elec_8x10.5
C73, C83, C84, C85, C86: 100nF; C_0805_2012Metric
D11: BAT54S; SOT-23
J7: ESP32_C6_DEVKITC_1_J1; PinSocket_1x16_P2.54mm_Vertical
J8: ESP32_C6_DEVKITC_1_J3; PinSocket_1x16_P2.54mm_Vertical
J10: OLED_SPI_2x8; IDC-Header_2x08_P2.54mm_Vertical
J17: DEVKIT_C2000_A; PinSocket_2x24_P2.54mm_Vertical
J18: DEVKIT_C2000_B; PinSocket_2x24_P2.54mm_Vertical
PF19: PWR_FLAG
R58: 10R; R_0805_2012Metric
R70: 100R; R_0805_2012Metric
TP14: VREF_ADC; TestPoint_Pad_D2.5mm
U4: ER-OLEDM032-1
U8: TLV9151; SOT-23-5

Connections:
3V3_C2000: C86.2, J17.48 (VDDIO), PF19.1; also elsewhere on the board
3V3_ESP32: C83.2, J7.1 (3V3), J10.2 (VCC); also elsewhere on the board
3V3_ISO_ADC2: C73.2, D11.2, U8.5 (V+); also elsewhere on the board
5V_C2000: C60.1, C85.2, J18.2 (+5V); also elsewhere on the board
5V_ESP32: C59.1, C84.2, J7.14 (+5V); also elsewhere on the board
ADC_8_MCU: J17.16 (ADC_8); also elsewhere on the board
ADC_9_MCU: J17.17 (ADC_9); also elsewhere on the board
ADC_10_MCU: J17.20 (ADC_10); also elsewhere on the board
ADC_11_MCU: J17.21 (ADC_11); also elsewhere on the board
ADC_12_MCU: J17.24 (ADC_12); also elsewhere on the board
BOOT_SEL: J7.12 (GPIO2/TMS_BOOT_SEL), J18.6 (BOOT_SEL)
CAN_RX_MCU: J18.42 (CAN_RX); also elsewhere on the board
CAN_TX_MCU: J18.39 (CAN_TX); also elsewhere on the board
CLB_OUT_MCU: J18.46 (CLB_OUT); also elsewhere on the board
CMP_OUT_MCU: J18.43 (CMP_OUT); also elsewhere on the board
Discharge_MCU: J17.40 (Discharge); also elsewhere on the board
ESP32_ALERT_ISO: J8.7 (GPIO21); also elsewhere on the board
ESP32_SCL_ISO: J8.6 (GPIO22); also elsewhere on the board
ESP32_SDA_ISO: J8.5 (GPIO23); also elsewhere on the board
GND: C10.1, C59.2, C60.2, C73.1, C83.1, C84.1, C85.1, C86.1, D11.1, J7.15 (GND), J8.1 (GND), J8.12 (GND), J8.15 (GND), J10.1 (VSS), J10.7 (NC), J10.8 (GND), J10.9 (GND), J10.10 (GND), J10.11 (GND), J10.12 (GND), J10.13 (GND), J17.2 (GND), J17.3 (GND), J17.6 (GND), J17.7 (GND), J17.10 (GND), J17.11 (GND), J17.14 (GND), J17.15 (GND), J17.18 (GND), J17.19 (GND), J17.22 (GND), J17.23 (GND), J17.26 (GND), J17.27 (GND), J17.30 (GND), J17.31 (GND), J17.34 (GND), J17.35 (GND), J17.38 (GND), J17.39 (GND), J17.42 (GND), J17.43 (GND), J17.46 (GND), J17.47 (GND), J18.1 (GND), J18.4 (GND), J18.5 (GND), J18.8 (GND), J18.9 (GND), J18.12 (GND), J18.13 (GND), J18.16 (GND), J18.17 (GND), J18.20 (GND), J18.21 (GND), J18.24 (GND), J18.25 (GND), J18.28 (GND), J18.29 (GND), J18.32 (GND), J18.33 (GND), J18.36 (GND), J18.37 (GND), J18.40 (GND), J18.41 (GND), J18.44 (GND), J18.45 (GND), J18.48 (GND), U8.2 (V-); also elsewhere on the board
HV_EN_MCU: J17.37 (HV_EN); also elsewhere on the board
I2C_SCL_MCU: J18.27 (I2C_SCL); also elsewhere on the board
I2C_SDA_MCU: J18.30 (I2C_SDA); also elsewhere on the board
I_SHUNT1_CMP_MCU: J17.25 (I_SHUNT1_CMP); also elsewhere on the board
I_SHUNT2_CMP_MCU: J17.29 (I_SHUNT2_CMP); also elsewhere on the board
I_shunt1_MCU: J17.28 (I_SHUNT1_MES); also elsewhere on the board
I_shunt2_MCU: J17.32 (I_SHUNT2_MES); also elsewhere on the board
Iin_MCU: J17.5 (Iin); also elsewhere on the board
Iout_MCU: J17.8 (Iout); also elsewhere on the board
unnamed: D11.3, R58.1, U8.1, U8.4 (-)
OLED_CS: J8.10 (GPIO18/OLED_CS), J10.16 (CS)
OLED_DC: J8.9 (GPIO19/OLED_DC), J10.14 (DC)
OLED_MOSI: J7.6 (GPIO7/OLED_MOSI), J10.5 (MOSI)
OLED_RST: J8.8 (GPIO20/OLED_RST), J10.15 (RST)
OLED_SCK: J7.5 (GPIO6/OLED_SCK), J10.4 (CLK)
PWM1_A_MCU: J18.7 (PWM1_A); also elsewhere on the board
PWM1_B_MCU: J18.10 (PWM1_B); also elsewhere on the board
PWM2_A_MCU: J18.11 (PWM2_A); also elsewhere on the board
PWM2_B_MCU: J18.14 (PWM2_B); also elsewhere on the board
PWM3_A_MCU: J18.15 (PWM3_A); also elsewhere on the board
PWM3_B_MCU: J18.18 (PWM3_B); also elsewhere on the board
PWM4_A_MCU: J18.19 (PWM4_A); also elsewhere on the board
PWM4_B_MCU: J18.22 (PWM4_B); also elsewhere on the board
SPI_CLK_MCU: J18.31 (SPI_CLK); also elsewhere on the board
SPI_SIMO_MCU: J18.34 (SPI_SIMO); also elsewhere on the board
SPI_SOMI_MCU: J18.35 (SPI_SOMI); also elsewhere on the board
SPI_STE_MCU: J18.38 (SPI_STE); also elsewhere on the board
Stage1_EN_MCU: J17.33 (Stage1_EN); also elsewhere on the board
Stage2_EN_MCU: J17.36 (Stage2_EN); also elsewhere on the board
Temp1_MCU: J17.12 (Temp1); also elsewhere on the board
Temp2_MCU: J17.13 (Temp2); also elsewhere on the board
UART_RX_MCU: J18.26 (UART_RX); also elsewhere on the board
UART_TX_MCU: J18.23 (UART_TX); also elsewhere on the board
V1_MCU: J17.9 (V1); also elsewhere on the board
VREFLO_SENSE_MCU: J17.45 (VREFLO_SENSE); also elsewhere on the board
VREF_ADC: R58.2, TP14.1 (1_1); also elsewhere on the board
VREF_ADC_MCU: J17.44 (VREF_ADC), R70.1
VREF_ADC_PREBUF: C10.2, R70.2, U8.3 (+)
Vin_MCU: J17.1 (Vin); also elsewhere on the board
Vout_MCU: J17.4 (Vout); also elsewhere on the board
~FAULT_MCU: J17.41 (~FAULT_MCU); also elsewhere on the board
~RESET: J7.13 (GPIO3/TMS_nRESET), J18.3 (~RESET)
