Nicolboy/KICAD-C2000-powershield/shield.kicad_pcb

## KiCad design shield.kicad_pcb (continued)

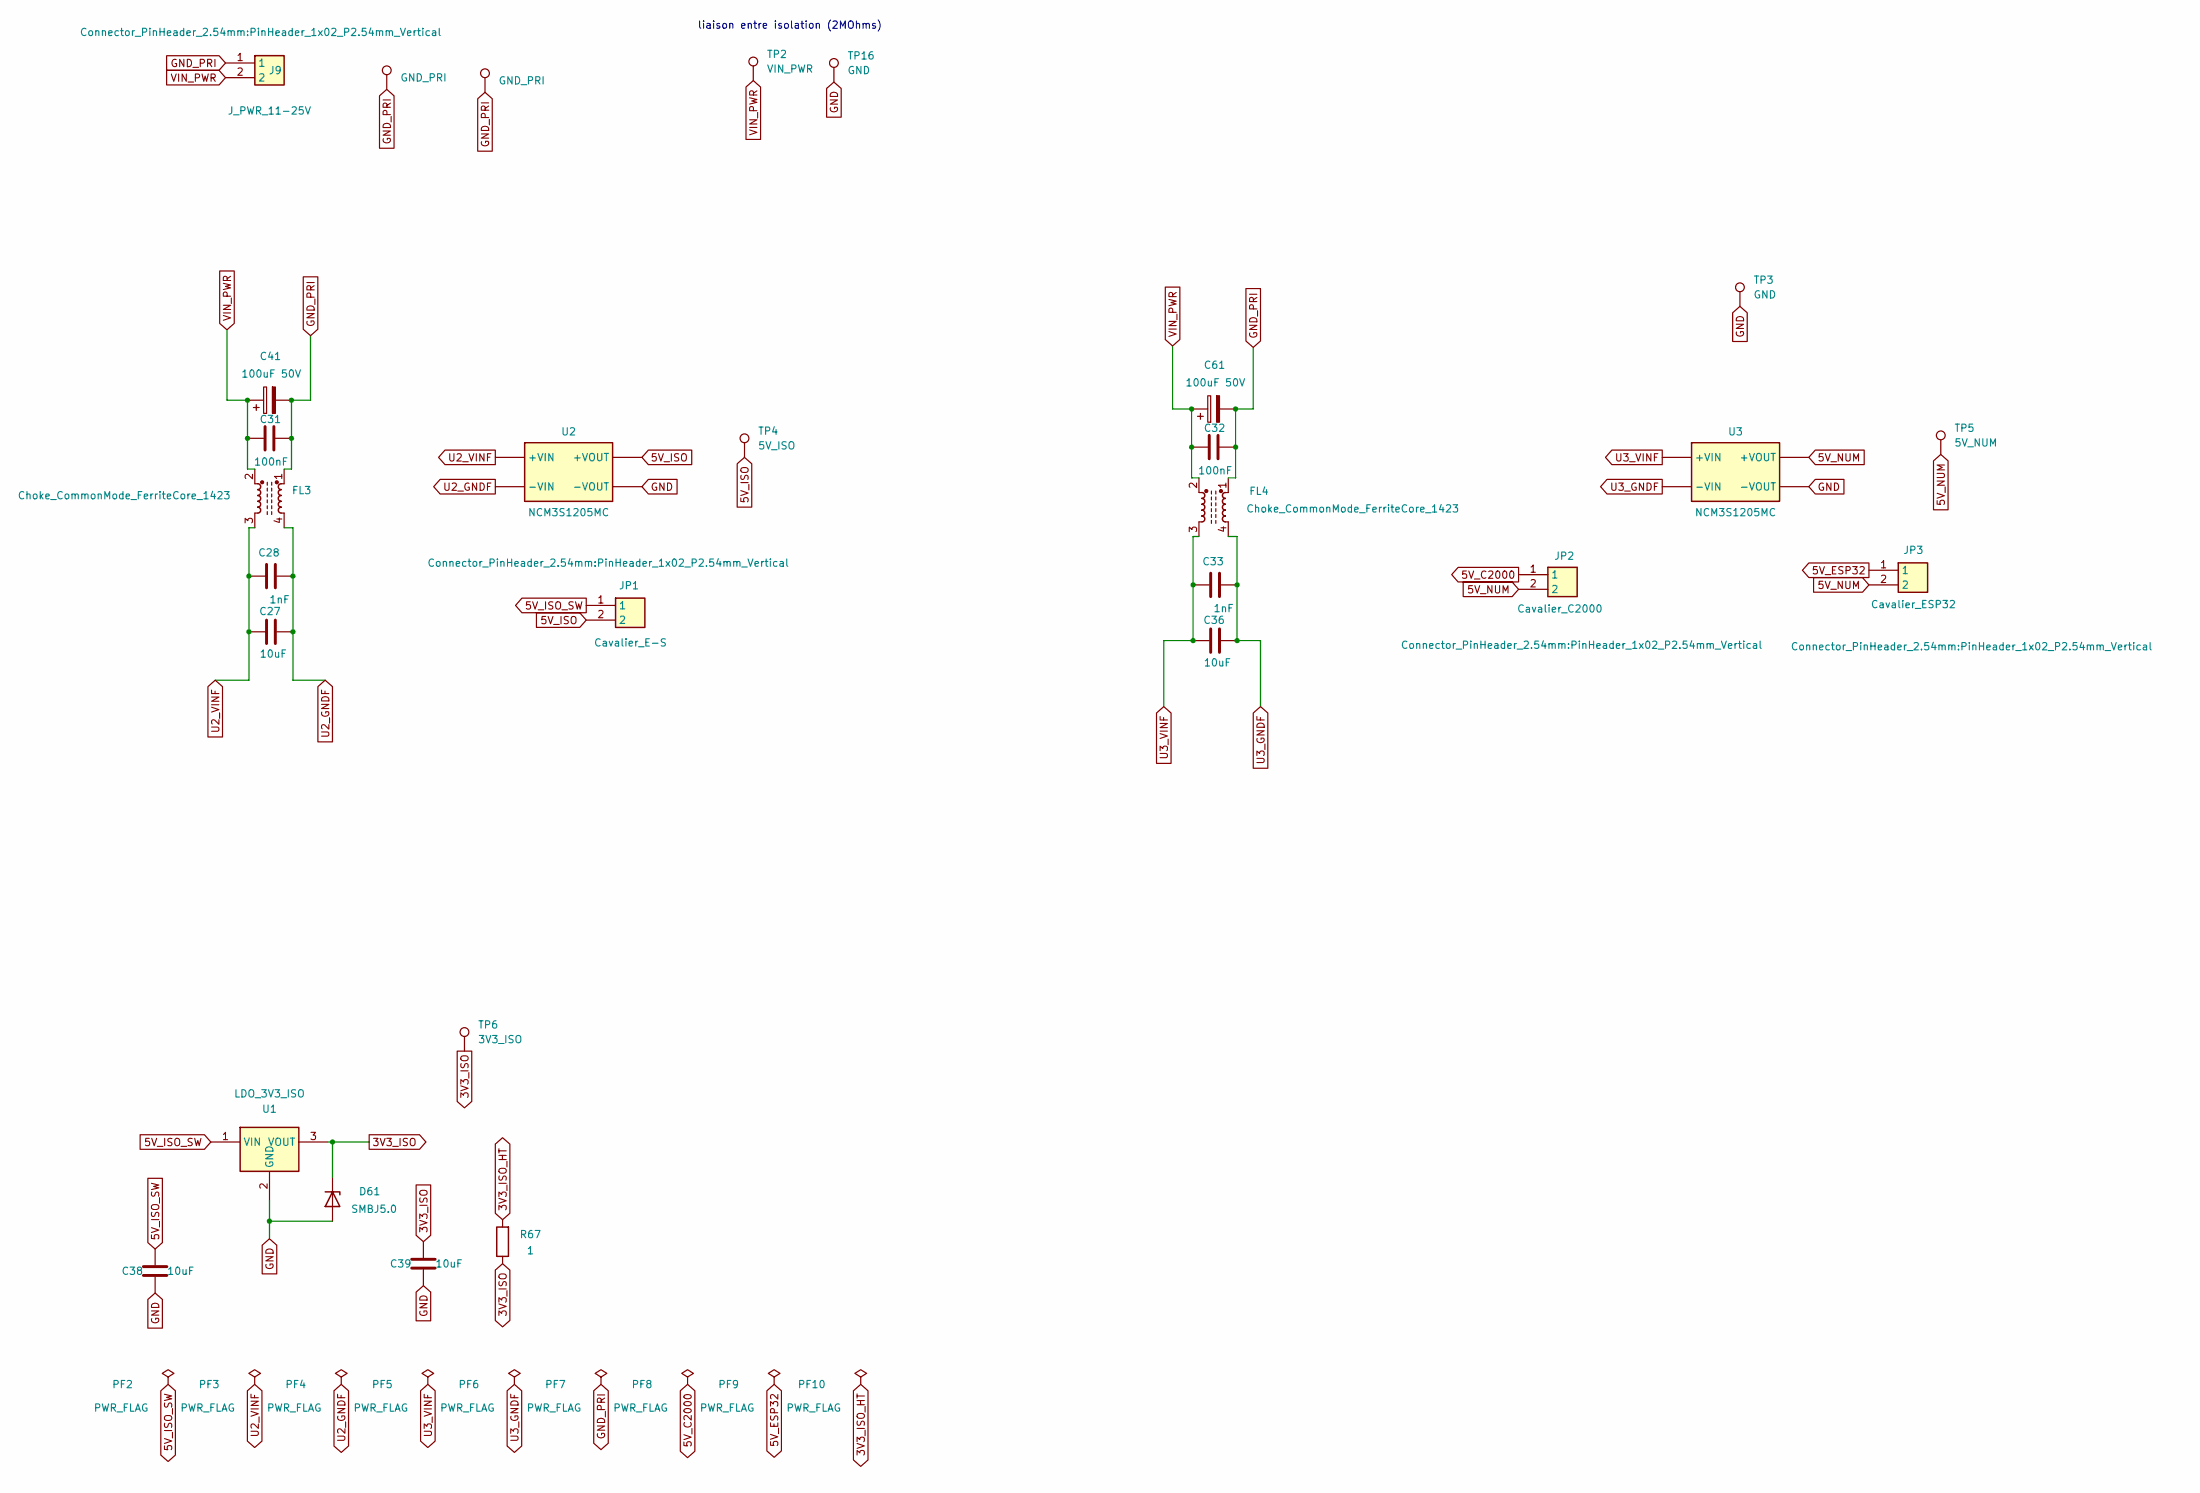
[picture p9: schematic dc.kicad_sch, Chaine alimentation DC — 11-25V isole -> 5V numerique / 5V+…]

Parts:
C27, C36, C38, C39: 10uF; C_0805_2012Metric
C28, C33: 1nF; C_0805_2012Metric
C31, C32: 100nF; C_0805_2012Metric
C41, C61: 100uF 50V; CP_Elec_8x10.5
D61: SMBJ5.0; D_SMB
FL3, FL4: Choke_CommonMode_FerriteCore_1423; Filter_Bourns_SRF0905_6.0x9.2mm_My
J9: J_PWR_11-25V; PinHeader_1x02_P2.54mm_Vertical
JP1: Cavalier_E-S; PinHeader_1x02_P2.54mm_Vertical
JP2: Cavalier_C2000; PinHeader_1x02_P2.54mm_Vertical
JP3: Cavalier_ESP32; PinHeader_1x02_P2.54mm_Vertical
PF2, PF3, PF4, PF5, PF6, PF7, PF8, PF9, PF10: PWR_FLAG
R67: 1; R_0805_2012Metric
TP1, TP15: GND_PRI; TestPoint_Pad_D2.5mm
TP2: VIN_PWR; TestPoint_Pad_D2.5mm
TP3, TP16: GND; TestPoint_Pad_D2.5mm
TP4: 5V_ISO; TestPoint_Pad_D2.5mm
TP5: 5V_NUM; TestPoint_Pad_D2.5mm
TP6: 3V3_ISO; TestPoint_Pad_D2.5mm
U1: LDO_3V3_ISO; SOT-23
U2, U3: NCM3S1205MC

Connections:
3V3_ISO: C39.1, D61.1 (K), R67.1, TP6.1 (1_1), U1.3 (VOUT)
3V3_ISO_HT: PF10.1, R67.2; also elsewhere on the board
5V_C2000: JP2.1, PF8.1; also elsewhere on the board
5V_ESP32: JP3.1, PF9.1; also elsewhere on the board
5V_ISO: JP1.2, TP4.1 (1_1), U2.3 (+VOUT)
5V_ISO_SW: C38.1, JP1.1, PF2.1, U1.1 (VIN); also elsewhere on the board
5V_NUM: JP2.2, JP3.2, TP5.1 (1_1), U3.3 (+VOUT)
GND: C38.2, C39.2, D61.2 (A), TP3.1 (1_1), TP16.1 (1_1), U1.2 (GND), U2.4 (-VOUT), U3.4 (-VOUT); also elsewhere on the board
GND_PRI: C31.2, C32.2, C41.2, C61.2, FL3.1, FL4.1, J9.1, PF7.1, TP1.1 (1_1), TP15.1 (1_1); also elsewhere on the board
U2_GNDF: C27.1, C28.2, FL3.4, PF4.1, U2.1 (-VIN)
U2_VINF: C27.2, C28.1, FL3.3, PF3.1, U2.2 (+VIN)
U3_GNDF: C33.2, C36.1, FL4.4, PF6.1, U3.1 (-VIN)
U3_VINF: C33.1, C36.2, FL4.3, PF5.1, U3.2 (+VIN)
VIN_PWR: C31.1, C32.1, C41.1, C61.1, FL3.2, FL4.2, J9.2, TP2.1 (1_1); also elsewhere on the board

Notes on the sheet:
liaison entre isolation (2MOhms)

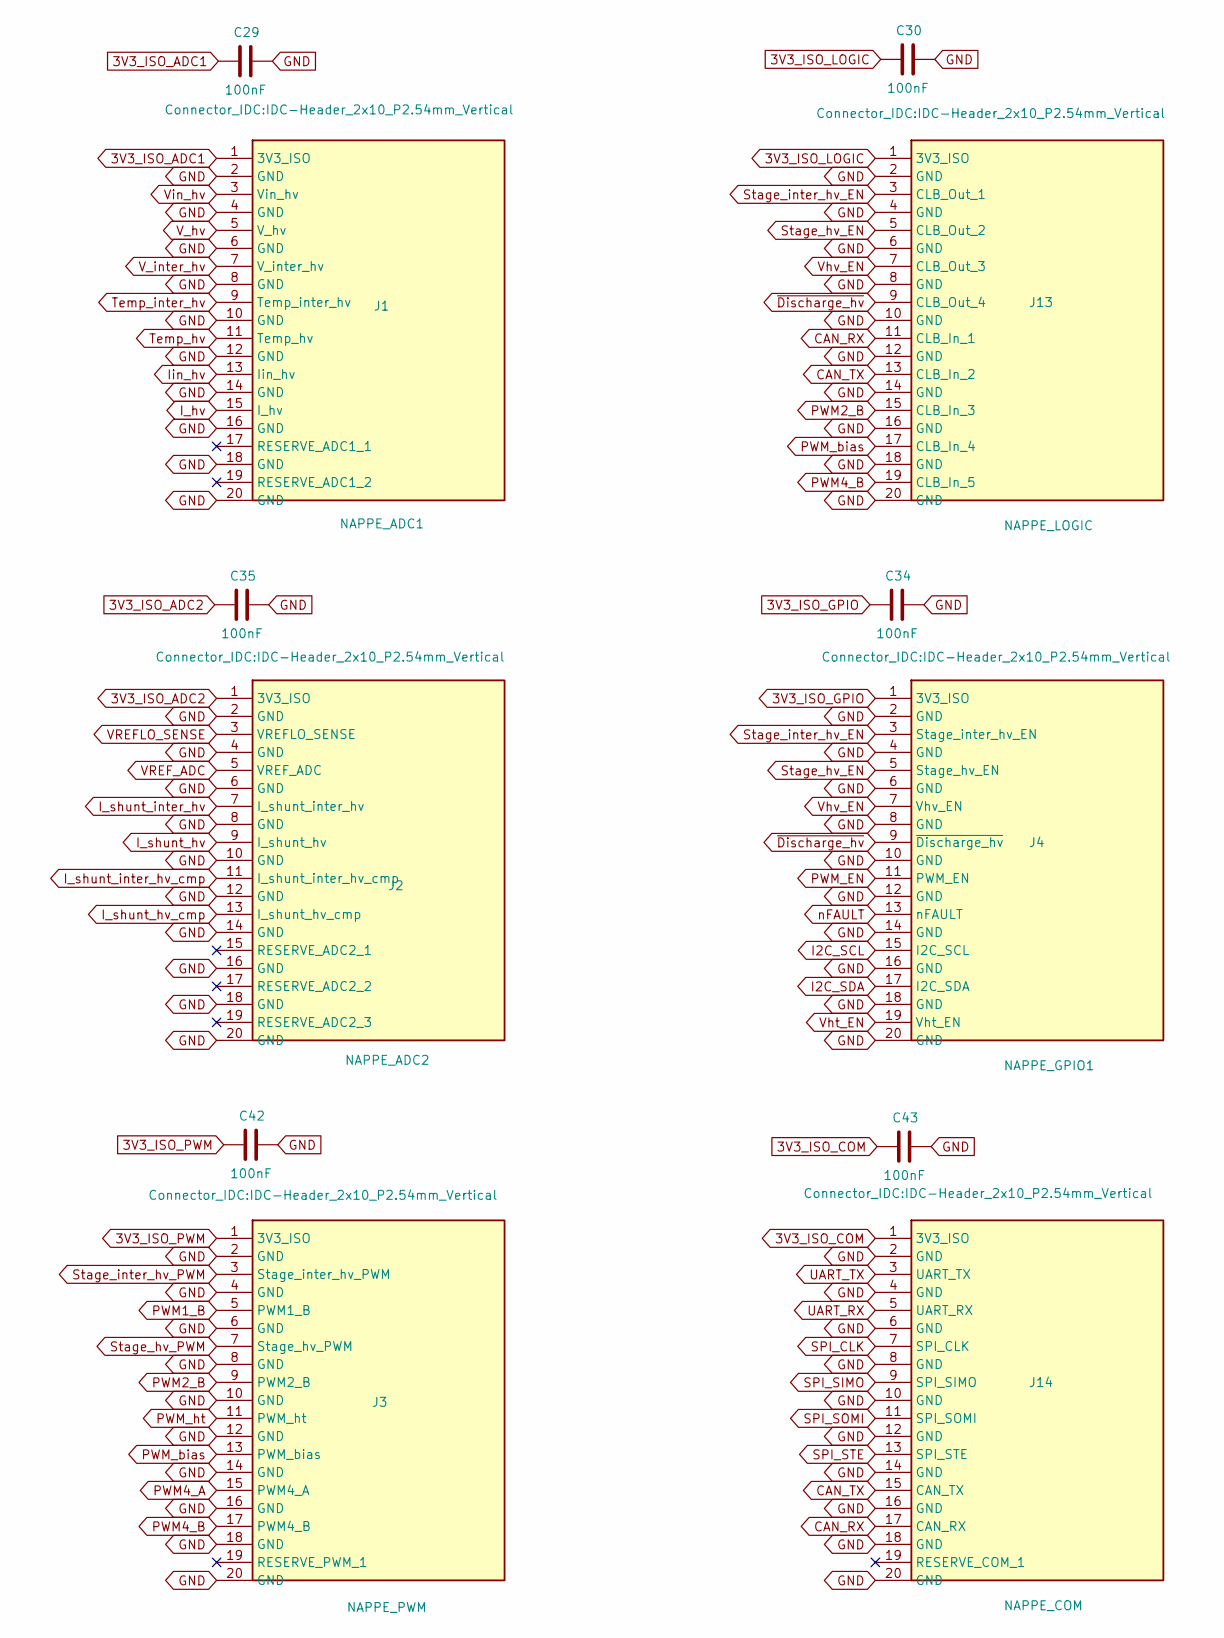
[picture p10: schematic connecteurs_nappe.kicad_sch, Connecteurs nappe (ADC-1, ADC-2, PWM, GPIO)]

Parts:
C29, C30, C34, C35, C42, C43: 100nF; C_0805_2012Metric
J1: NAPPE_ADC1; IDC-Header_2x10_P2.54mm_Vertical
J2: NAPPE_ADC2; IDC-Header_2x10_P2.54mm_Vertical
J3: NAPPE_PWM; IDC-Header_2x10_P2.54mm_Vertical
J4: NAPPE_GPIO1; IDC-Header_2x10_P2.54mm_Vertical
J13: NAPPE_LOGIC; IDC-Header_2x10_P2.54mm_Vertical
J14: NAPPE_COM; IDC-Header_2x10_P2.54mm_Vertical

Connections:
3V3_ISO_ADC1: C29.1, J1.1 (3V3_ISO); also elsewhere on the board
3V3_ISO_ADC2: C35.1, J2.1 (3V3_ISO); also elsewhere on the board
3V3_ISO_COM: C43.1, J14.1 (3V3_ISO); also elsewhere on the board
3V3_ISO_GPIO: C34.1, J4.1 (3V3_ISO); also elsewhere on the board
3V3_ISO_LOGIC: C30.1, J13.1 (3V3_ISO); also elsewhere on the board
3V3_ISO_PWM: C42.1, J3.1 (3V3_ISO); also elsewhere on the board
CAN_RX: J13.11 (CLB_In_1), J14.17 (CAN_RX); also elsewhere on the board
CAN_TX: J13.13 (CLB_In_2), J14.15 (CAN_TX); also elsewhere on the board
GND: C29.2, C30.2, C34.2, C35.2, C42.2, C43.2, J1.2 (GND), J1.4 (GND), J1.6 (GND), J1.8 (GND), J1.10 (GND), J1.12 (GND), J1.14 (GND), J1.16 (GND), J1.18 (GND), J1.20 (GND), J2.2 (GND), J2.4 (GND), J2.6 (GND), J2.8 (GND), J2.10 (GND), J2.12 (GND), J2.14 (GND), J2.16 (GND), J2.18 (GND), J2.20 (GND), J3.2 (GND), J3.4 (GND), J3.6 (GND), J3.8 (GND), J3.10 (GND), J3.12 (GND), J3.14 (GND), J3.16 (GND), J3.18 (GND), J3.20 (GND), J4.2 (GND), J4.4 (GND), J4.6 (GND), J4.8 (GND), J4.10 (GND), J4.12 (GND), J4.14 (GND), J4.16 (GND), J4.18 (GND), J4.20 (GND), J13.2 (GND), J13.4 (GND), J13.6 (GND), J13.8 (GND), J13.10 (GND), J13.12 (GND), J13.14 (GND), J13.16 (GND), J13.18 (GND), J13.20 (GND), J14.2 (GND), J14.4 (GND), J14.6 (GND), J14.8 (GND), J14.10 (GND), J14.12 (GND), J14.14 (GND), J14.16 (GND), J14.18 (GND), J14.20 (GND); also elsewhere on the board
I2C_SCL: J4.15 (I2C_SCL); also elsewhere on the board
I2C_SDA: J4.17 (I2C_SDA); also elsewhere on the board
I_hv: J1.15 (I_hv); also elsewhere on the board
I_shunt_hv: J2.9 (I_shunt_hv); also elsewhere on the board
I_shunt_hv_cmp: J2.13 (I_shunt_hv_cmp); also elsewhere on the board
I_shunt_inter_hv: J2.7 (I_shunt_inter_hv); also elsewhere on the board
I_shunt_inter_hv_cmp: J2.11 (I_shunt_inter_hv_cmp); also elsewhere on the board
Iin_hv: J1.13 (Iin_hv); also elsewhere on the board
PWM1_B: J3.5 (PWM1_B); also elsewhere on the board
PWM2_B: J3.9 (PWM2_B), J13.15 (CLB_In_3); also elsewhere on the board
PWM4_A: J3.15 (PWM4_A); also elsewhere on the board
PWM4_B: J3.17 (PWM4_B), J13.19 (CLB_In_5); also elsewhere on the board
PWM_EN: J4.11 (PWM_EN); also elsewhere on the board
PWM_bias: J3.13 (PWM_bias), J13.17 (CLB_In_4); also elsewhere on the board
PWM_ht: J3.11 (PWM_ht); also elsewhere on the board
SPI_CLK: J14.7 (SPI_CLK); also elsewhere on the board
SPI_SIMO: J14.9 (SPI_SIMO); also elsewhere on the board
SPI_SOMI: J14.11 (SPI_SOMI); also elsewhere on the board
SPI_STE: J14.13 (SPI_STE); also elsewhere on the board
Stage_hv_EN: J4.5 (Stage_hv_EN), J13.5 (CLB_Out_2); also elsewhere on the board
Stage_hv_PWM: J3.7 (Stage_hv_PWM); also elsewhere on the board
Stage_inter_hv_EN: J4.3 (Stage_inter_hv_EN), J13.3 (CLB_Out_1); also elsewhere on the board
Stage_inter_hv_PWM: J3.3 (Stage_inter_hv_PWM); also elsewhere on the board
Temp_hv: J1.11 (Temp_hv); also elsewhere on the board
Temp_inter_hv: J1.9 (Temp_inter_hv); also elsewhere on the board
UART_RX: J14.5 (UART_RX); also elsewhere on the board
UART_TX: J14.3 (UART_TX); also elsewhere on the board
VREFLO_SENSE: J2.3 (VREFLO_SENSE); also elsewhere on the board
VREF_ADC: J2.5 (VREF_ADC); also elsewhere on the board
V_hv: J1.5 (V_hv); also elsewhere on the board
V_inter_hv: J1.7 (V_inter_hv); also elsewhere on the board
Vht_EN: J4.19 (Vht_EN); also elsewhere on the board
Vhv_EN: J4.7 (Vhv_EN), J13.7 (CLB_Out_3); also elsewhere on the board
Vin_hv: J1.3 (Vin_hv); also elsewhere on the board
nFAULT: J4.13 (nFAULT); also elsewhere on the board
~Discharge_hv: J4.9 (~Discharge_hv), J13.9 (CLB_Out_4); also elsewhere on the board

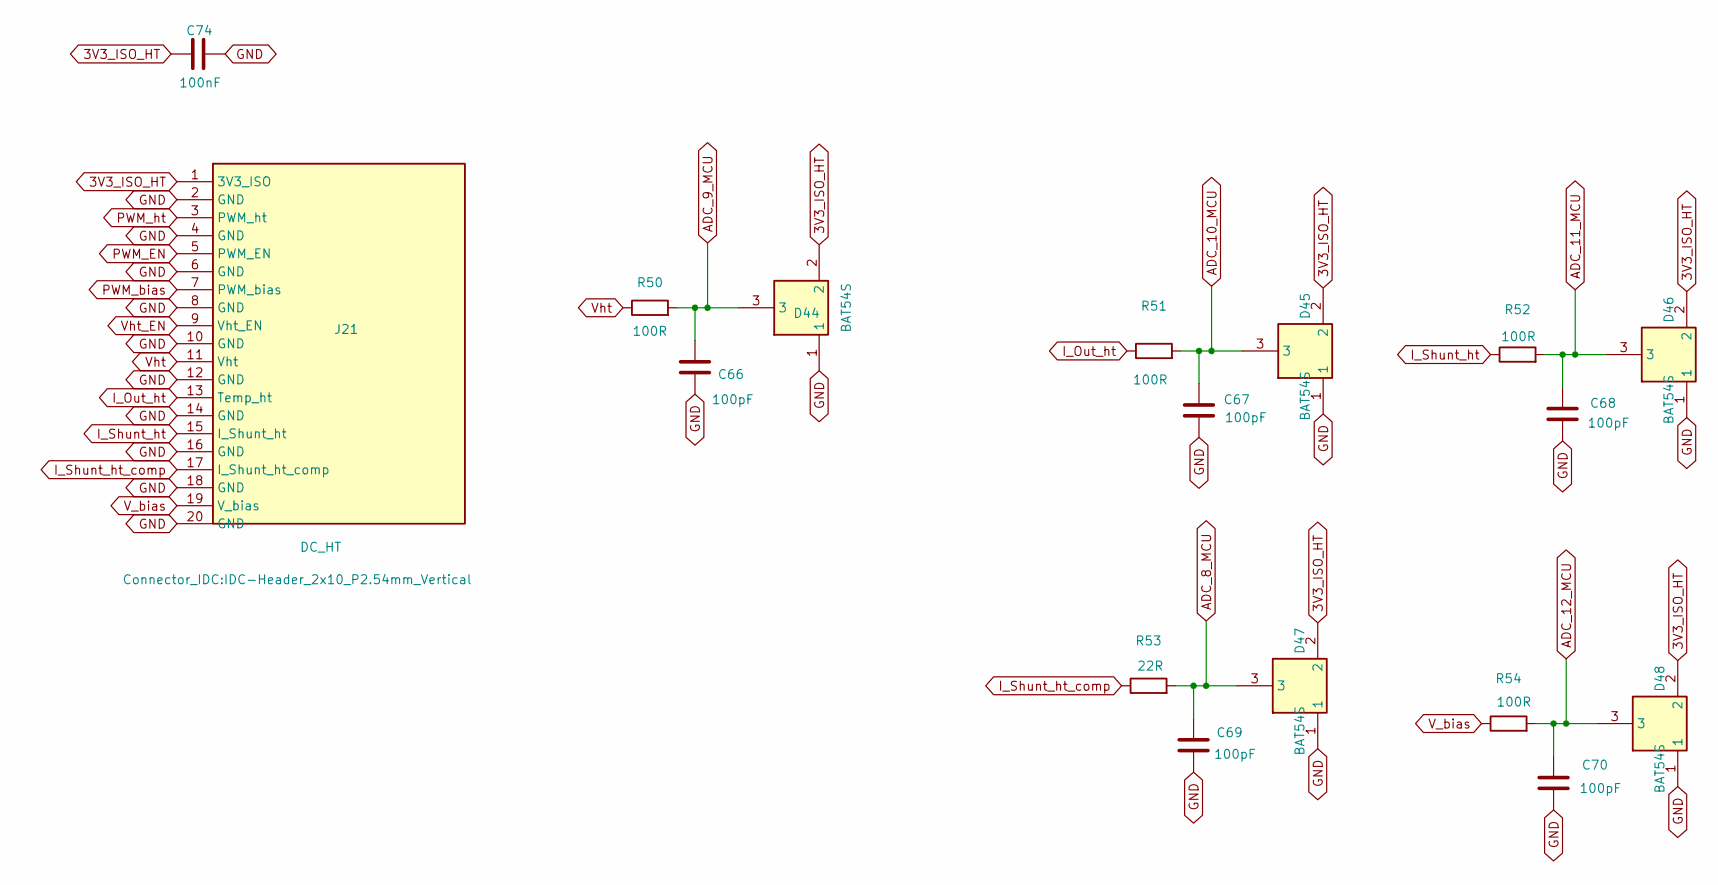
[picture p11: schematic connecteur_ht.kicad_sch]

Parts:
C66, C67, C68, C69, C70: 100pF; C_0805_2012Metric
C74: 100nF; C_0805_2012Metric
D44, D45, D46, D47, D48: BAT54S; SOT-23
J21: DC_HT; IDC-Header_2x10_P2.54mm_Vertical
R50, R51, R52, R54: 100R; R_0805_2012Metric
R53: 22R; R_0805_2012Metric

Connections:
3V3_ISO_HT: C74.1, D44.2, D45.2, D46.2, D47.2, D48.2, J21.1 (3V3_ISO); also elsewhere on the board
ADC_8_MCU: C69.1, D47.3, R53.2; also elsewhere on the board
ADC_9_MCU: C66.1, D44.3, R50.2; also elsewhere on the board
ADC_10_MCU: C67.1, D45.3, R51.2; also elsewhere on the board
ADC_11_MCU: C68.1, D46.3, R52.2; also elsewhere on the board
ADC_12_MCU: C70.1, D48.3, R54.2; also elsewhere on the board
GND: C66.2, C67.2, C68.2, C69.2, C70.2, C74.2, D44.1, D45.1, D46.1, D47.1, D48.1, J21.2 (GND), J21.4 (GND), J21.6 (GND), J21.8 (GND), J21.10 (GND), J21.12 (GND), J21.14 (GND), J21.16 (GND), J21.18 (GND), J21.20 (GND); also elsewhere on the board
I_Out_ht: J21.13 (Temp_ht), R51.1
I_Shunt_ht: J21.15 (I_Shunt_ht), R52.1
I_Shunt_ht_comp: J21.17 (I_Shunt_ht_comp), R53.1
PWM_EN: J21.5 (PWM_EN); also elsewhere on the board
PWM_bias: J21.7 (PWM_bias); also elsewhere on the board
PWM_ht: J21.3 (PWM_ht); also elsewhere on the board
V_bias: J21.19 (V_bias), R54.1
Vht: J21.11 (Vht), R50.1
Vht_EN: J21.9 (Vht_EN); also elsewhere on the board

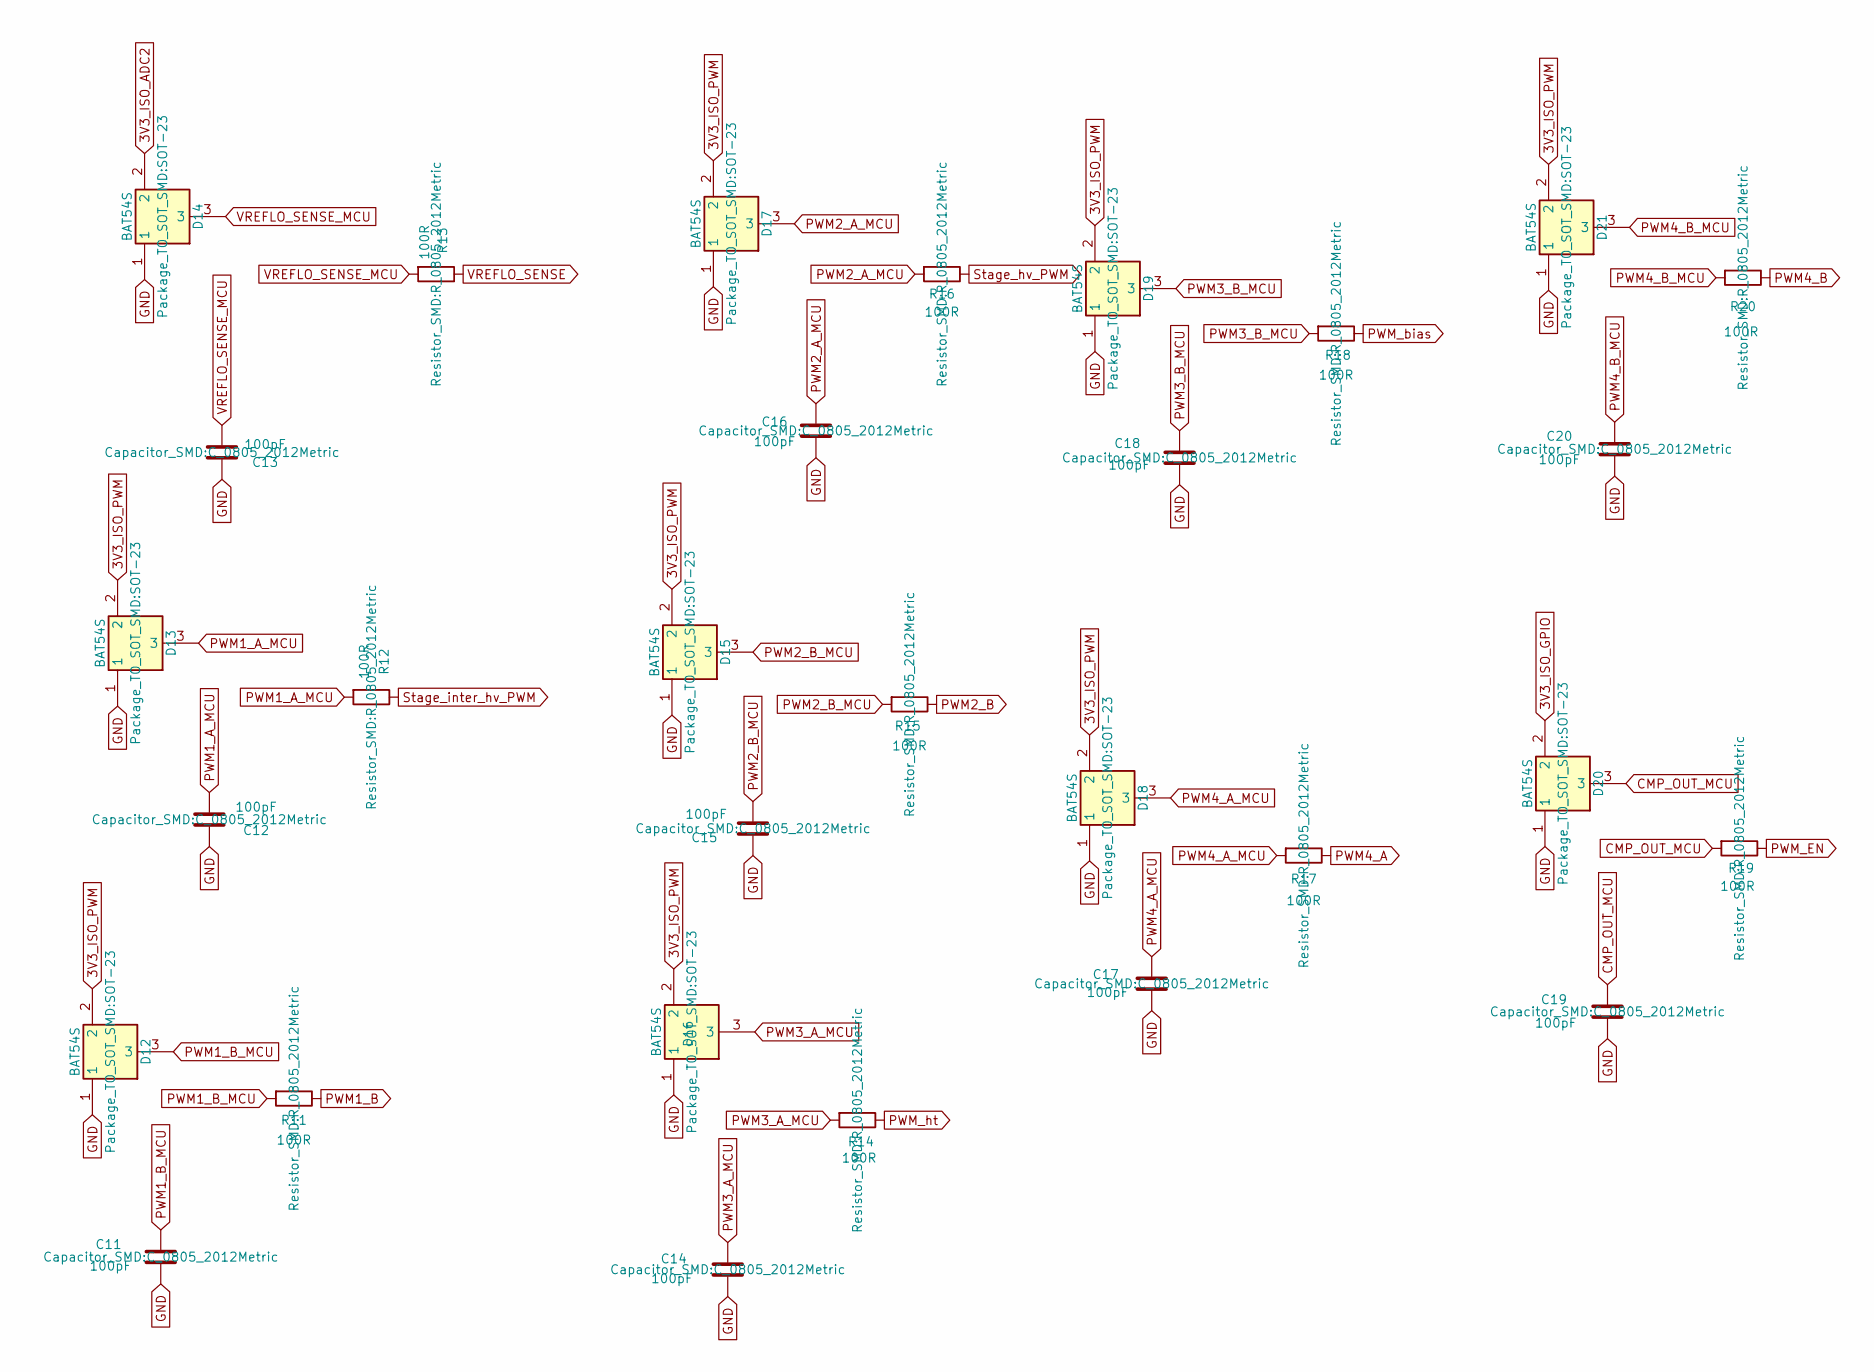
[picture p12: schematic protection_devkit2.kicad_sch]

Parts:
C11, C12, C13, C14, C15, C16, C17, C18, C19, C20: 100pF; C_0805_2012Metric
D12, D13, D14, D15, D16, D17, D18, D19, D20, D21: BAT54S; SOT-23
R11, R12, R13, R14, R15, R16, R17, R18, R19, R20: 100R; R_0805_2012Metric

Connections:
3V3_ISO_ADC2: D14.2; also elsewhere on the board
3V3_ISO_GPIO: D20.2; also elsewhere on the board
3V3_ISO_PWM: D12.2, D13.2, D15.2, D16.2, D17.2, D18.2, D19.2, D21.2; also elsewhere on the board
CMP_OUT_MCU: C19.2, D20.3, R19.2; also elsewhere on the board
GND: C11.1, C12.1, C13.1, C14.1, C15.1, C16.1, C17.1, C18.1, C19.1, C20.1, D12.1, D13.1, D14.1, D15.1, D16.1, D17.1, D18.1, D19.1, D20.1, D21.1; also elsewhere on the board
PWM1_A_MCU: C12.2, D13.3, R12.2; also elsewhere on the board
PWM1_B: R11.1; also elsewhere on the board
PWM1_B_MCU: C11.2, D12.3, R11.2; also elsewhere on the board
PWM2_A_MCU: C16.2, D17.3, R16.2; also elsewhere on the board
PWM2_B: R15.1; also elsewhere on the board
PWM2_B_MCU: C15.2, D15.3, R15.2; also elsewhere on the board
PWM3_A_MCU: C14.2, D16.3, R14.2; also elsewhere on the board
PWM3_B_MCU: C18.2, D19.3, R18.2; also elsewhere on the board
PWM4_A: R17.1; also elsewhere on the board
PWM4_A_MCU: C17.2, D18.3, R17.2; also elsewhere on the board
PWM4_B: R20.1; also elsewhere on the board
PWM4_B_MCU: C20.2, D21.3, R20.2; also elsewhere on the board
PWM_EN: R19.1; also elsewhere on the board
PWM_bias: R18.1; also elsewhere on the board
PWM_ht: R14.1; also elsewhere on the board
Stage_hv_PWM: R16.1; also elsewhere on the board
Stage_inter_hv_PWM: R12.1; also elsewhere on the board
VREFLO_SENSE: R13.1; also elsewhere on the board
VREFLO_SENSE_MCU: C13.2, D14.3, R13.2; also elsewhere on the board

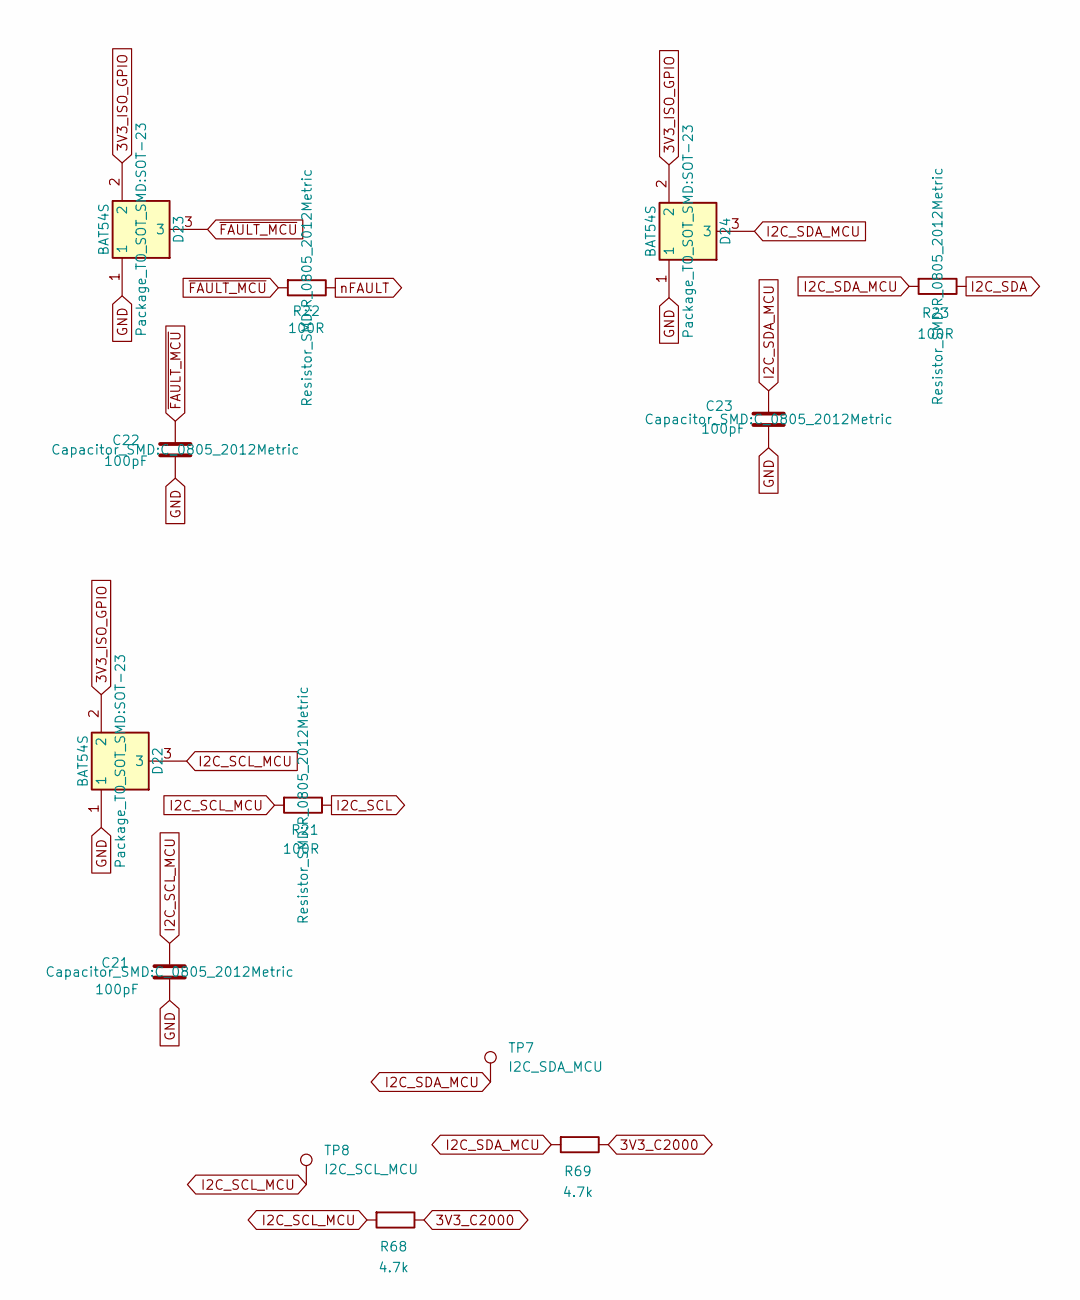
[picture p13: schematic protection_devkit3.kicad_sch]

Parts:
C21, C22, C23: 100pF; C_0805_2012Metric
D22, D23, D24: BAT54S; SOT-23
R21, R22, R23: 100R; R_0805_2012Metric
R68, R69: 4.7k; R_0805_2012Metric
TP7: I2C_SDA_MCU; TestPoint_Pad_D2.5mm
TP8: I2C_SCL_MCU; TestPoint_Pad_D2.5mm

Connections:
3V3_C2000: R68.1, R69.1; also elsewhere on the board
3V3_ISO_GPIO: D22.2, D23.2, D24.2; also elsewhere on the board
GND: C21.1, C22.1, C23.1, D22.1, D23.1, D24.1; also elsewhere on the board
I2C_SCL: R21.1; also elsewhere on the board
I2C_SCL_MCU: C21.2, D22.3, R21.2, R68.2, TP8.1 (1_1); also elsewhere on the board
I2C_SDA: R23.1; also elsewhere on the board
I2C_SDA_MCU: C23.2, D24.3, R23.2, R69.2, TP7.1 (1_1); also elsewhere on the board
nFAULT: R22.1; also elsewhere on the board
~FAULT_MCU: C22.2, D23.3, R22.2; also elsewhere on the board

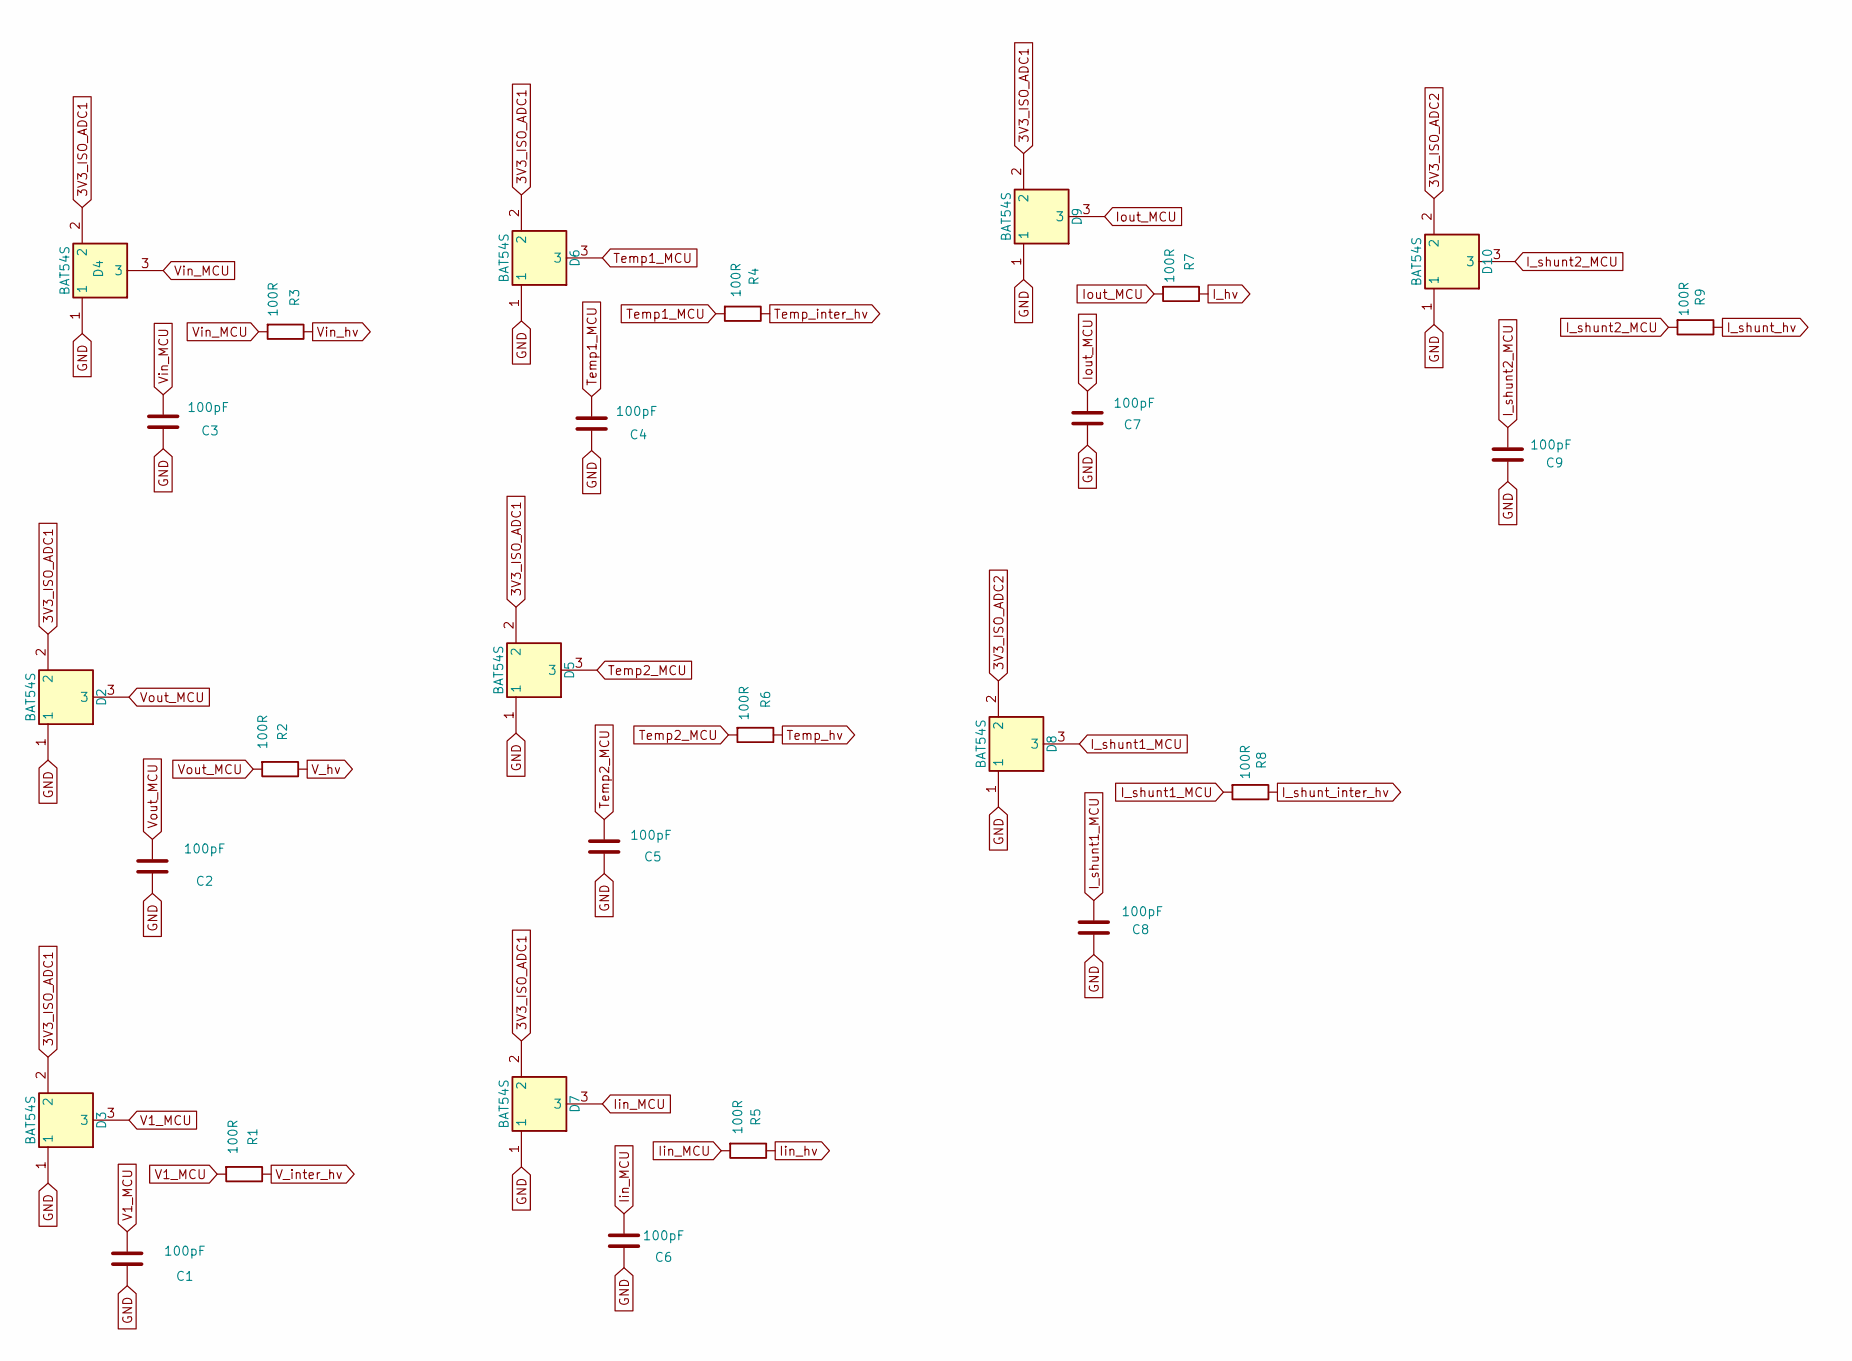
[picture p14: schematic protections_devkit.kicad_sch]

Parts:
C1, C2, C3, C4, C5, C6, C7, C8, C9: 100pF; C_0805_2012Metric
D2, D3, D4, D5, D6, D7, D8, D9, D10: BAT54S; SOT-23
R1, R2, R3, R4, R5, R6, R7, R8, R9: 100R; R_0805_2012Metric

Connections:
3V3_ISO_ADC1: D2.2, D3.2, D4.2, D5.2, D6.2, D7.2, D9.2; also elsewhere on the board
3V3_ISO_ADC2: D8.2, D10.2; also elsewhere on the board
GND: C1.1, C2.1, C3.1, C4.1, C5.1, C6.1, C7.1, C8.1, C9.1, D2.1, D3.1, D4.1, D5.1, D6.1, D7.1, D8.1, D9.1, D10.1; also elsewhere on the board
I_hv: R7.1; also elsewhere on the board
I_shunt1_MCU: C8.2, D8.3, R8.2; also elsewhere on the board
I_shunt2_MCU: C9.2, D10.3, R9.2; also elsewhere on the board
I_shunt_hv: R9.1; also elsewhere on the board
I_shunt_inter_hv: R8.1; also elsewhere on the board
Iin_MCU: C6.2, D7.3, R5.2; also elsewhere on the board
Iin_hv: R5.1; also elsewhere on the board
Iout_MCU: C7.2, D9.3, R7.2; also elsewhere on the board
Temp1_MCU: C4.2, D6.3, R4.2; also elsewhere on the board
Temp2_MCU: C5.2, D5.3, R6.2; also elsewhere on the board
Temp_hv: R6.1; also elsewhere on the board
Temp_inter_hv: R4.1; also elsewhere on the board
V1_MCU: C1.2, D3.3, R1.2; also elsewhere on the board
V_hv: R2.1; also elsewhere on the board
V_inter_hv: R1.1; also elsewhere on the board
Vin_MCU: C3.2, D4.3, R3.2; also elsewhere on the board
Vin_hv: R3.1; also elsewhere on the board
Vout_MCU: C2.2, D2.3, R2.2; also elsewhere on the board

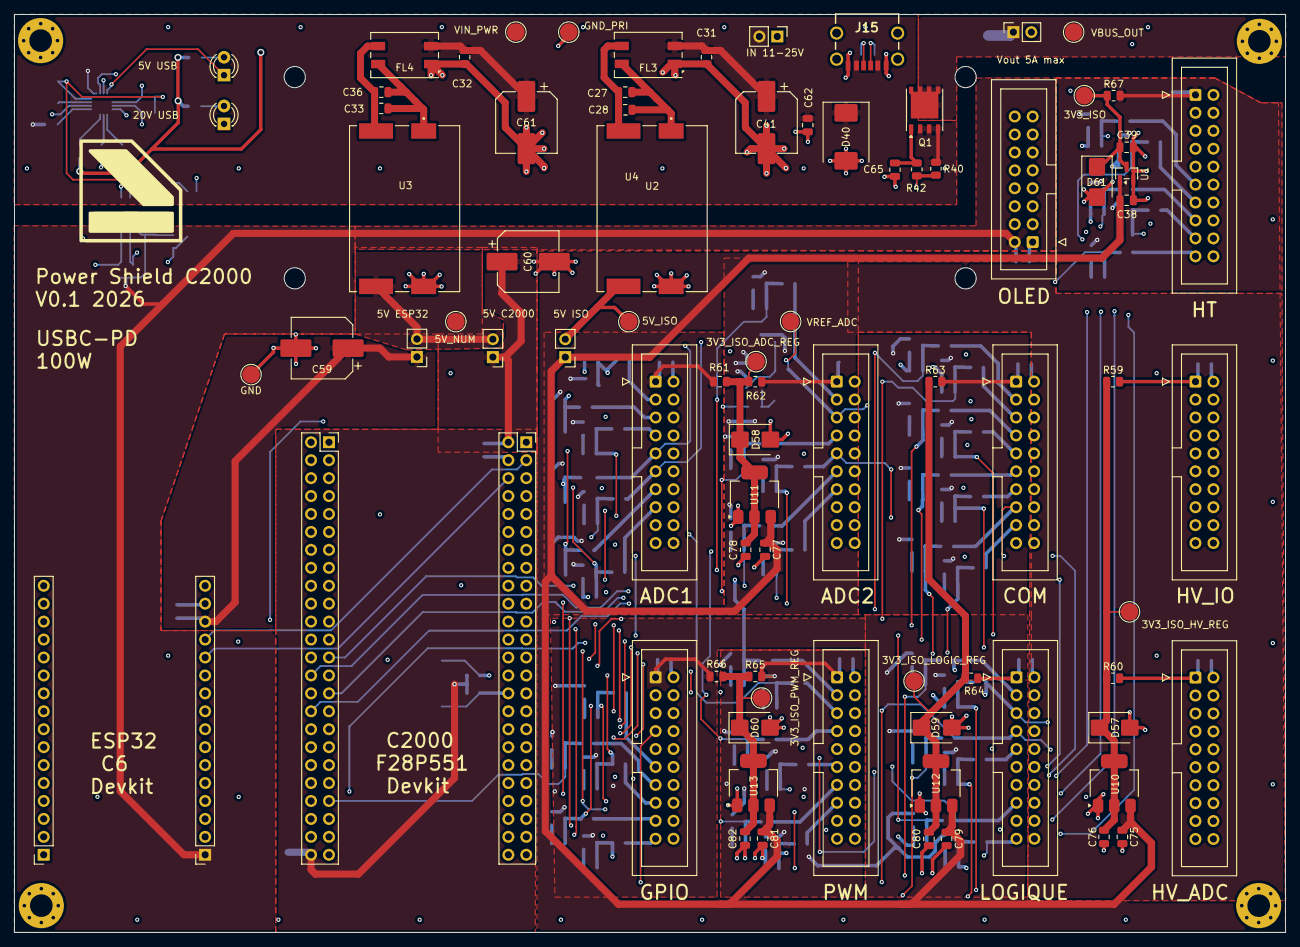
[picture p15: board shield.kicad_pcb from above]

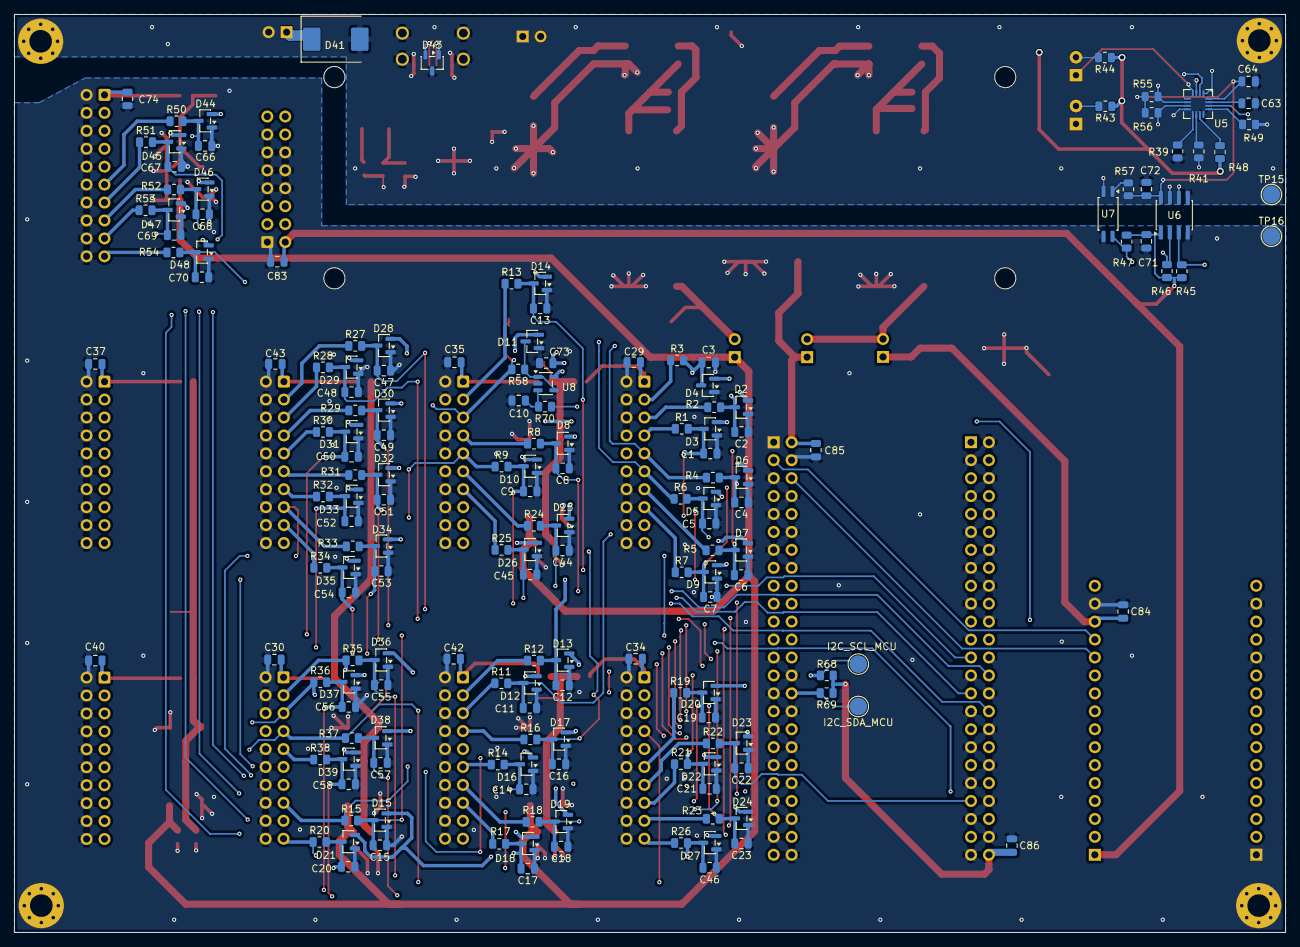
[picture p16: board shield.kicad_pcb from below]

Board: 4 copper layers, 180.0 x 130.0 mm, 262 parts (172 on the bottom side), 145 nets.

Other parts of the board:
MECH1: ESP32_C6_Devkit_3D (visuel, sans connexion); ESP32_C6_Devkit_3D
MECH2: DEVKIT_B_F28P551_3D (visuel, sans connexion); DEVKIT_B_F28P551_3D
