Nicolboy/KICAD-C2000-powershield/(commit log)

2026-10-07 Depart depuis shield-c2000 : etat baseline avant evolution en carte power
    Reprise du projet shield (schema+PCB routes, lib des 4 nappes et
    connecteurs devkit, doc de reference) au moment ou son role depasse le
    support mecanique des devkits. shield-c2000 reste inchange, c'est
    l'ancien etat ; ce depot part de cette copie pour la suite (alimentation
    isolee 11-25V->5V/3,3V, nappes 2x10 IDC).
    [brochage-devkit.csv, brochage-esp32.csv, shield.kicad_pcb, shield.kicad_sch]
2026-10-09 Separation connecteurs/protection en sous-feuilles, correction annotation, assignation des empreintes
    Eclate shield.kicad_sch en sous-feuilles (connecteurs devkit, nappes, DC,
    chaines de protection BAT54S) et corrige la duplication de reference J1
    entre DEVKIT_C2000_ROW_A et le connecteur d'alimentation de dc.kicad_sch.
    Assigne une empreinte a tous les composants places (R/C en 0805, BAT54S en
    SOT-23, cavaliers/connecteurs 2 broches en PinHeader 1x02, zener de
    protection en SMC) et cree l'empreinte custom NCM3S1205MC d'apres le
    datasheet Murata pour debloquer la mise a jour du PCB depuis le schema.
    [connecteur_devkit.kicad_sch, connecteurs_nappe.kicad_sch, dc.kicad_sch, protection_devkit2.kicad_sch, protection_devkit3.kicad_sch, protections_devkit.kicad_sch, shield.kicad_pcb, shield.kicad_sch]
2026-10-09 Ajoute l'embase OLED (J10, IDC 2x8 detrompee) et le README du depot
    Cree le symbole OLED_SPI_2x8 d'apres le plan constructeur de l'ecran
    ER-OLEDM032-1B et le raccorde aux labels SPI deja presents sur les broches
    natives de l'ESP32. Documente le choix dans decisions.md (#15) et
    nappes-shield.md, et ajoute le README.md qui manquait a ce depot.
    [connecteur_devkit.kicad_sch, shield.kicad_pcb]
2026-10-09 Regles de clearance par domaine d'isolement et filtre EMC recommande sur les NCM3S1205MC
    Ajoute deux netclasses (Isole_Primaire/Isole_Secondaire, assignees par nom
    de net) et une regle shield.kicad_dru qui impose 8mm de clearance des
    qu'une paire traverse les deux domaines - valeur issue du datasheet
    Murata (UL62368-1, 2 MOPP, 250Vrms), pas estimee. Rien n'existait avant
    pour differencier electriquement primaire et secondaire au DRC.
    Ajoute le filtre EMC recommande par le datasheet (p.8) sur l'entree des
    deux NCM3S1205MC (L1-L4, C26-C35), ce qui a necessite de renommer les
    labels VIN_PWR/GND_PRI au niveau des pins VIN de U2/U3 vers des noeuds
    intermediaires dedies (U2_VINF/U2_GNDF, U3_VINF/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
    [connecteur_devkit.kicad_sch, dc.kicad_sch, shield.kicad_pcb]
2026-10-09 Renomme les references au depot predecesseur (shield-c2000/KICAD-C2000-shield -> KICAD-C2000-devkit)
    Met a jour CLAUDE.md, README.md, doc/decisions.md, doc/nappes-shield.md
    et doc/publier-un-projet.md suite au renommage du depot predecesseur sur
    GitHub.
2026-10-10 Gabarit de netclasses, filtre EMC NCM3S1205MC, embase OLED, et groupement/routage des 23 trios de protection
    - shield.kicad_pro : 8 netclasses (Default/Rapide/Analogique/Alim/Isole_Primaire/
    Isole_Secondaire/Puissance/HT), 83 motifs de net classes
    - dc.kicad_sch : filtre EMC d'entree (L1-L4, C26-C28, C31-C33) pour les deux
    NCM3S1205MC ; etage de sortie (C4/C5 du datasheet) volontairement omis
    (decision #16, doc/decisions.md)
    - connecteur_devkit.kicad_sch : embase OLED J10 (IDC 2x8 detrompee),
    symbole mecanique U4 (ER-OLEDM032-1), correction label 3V3_ESP32
    - shield.kicad_pcb : les 23 trios de protection (BAT54S+R+C) groupes,
    routes (GND + signal interne), retournes en B.Cu pour mat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
    [connecteur_devkit.kicad_sch, dc.kicad_sch, shield.kicad_pcb]
2026-10-10 Allege CLAUDE.md : renvoi vers KICAD.md, corrige le nom de depot perime
    CLAUDE.md : coupe les sections dupliquees avec KICAD.md et avec
    doc/publier-un-projet.md (meme traitement que KICAD-C2000-devkit).
    Corrige aussi "KICAD-C2000-power" -> "KICAD-C2000-powershield", perime
    depuis le renommage du depot (README.md idem).
    shield.kicad_pcb non inclus : la session KiCad ouverte a deplace L1
    depuis mon dernier commit (position et face different de ce qui a ete
    commite) - probablement une manipulation en cours, laisse non committe.
2026-10-11 Routage des 23 trios de protection (PCB)
    Checkpoint avant le travail de routage des nappes J1-J4 et l'ajout de
    J5/J6 (connecteurs de sortie vers les cartes filles).
2026-10-11 Route les nappes ADC-1/ADC-2/PWM/GPIO, ajoute GPIO-2 et COM (decision #17)
    Les connecteurs J1-J4 n'avaient que leurs broches d'alimentation cablees
    (3V3_ISO/GND) depuis la decision #13 - les signaux reels (Vin, PWM1_A,
    Stage1_EN, etc.) n'etaient jamais poses. Cable maintenant, labels exacts
    verifies par kicad-cli sch erc.
    Resequencement signal(impair)/masse(pair) a partir de la broche 3 (au
    lieu de masse en 2 et 3 avant le premier signal) : gagne un emplacement
    signal de plus par connecteur (9 au lieu de 8) sans changer de taille de
    connecteur - contrainte de stock, pas de 2x13 disponible.
    Deux connecteurs neufs, meme famille 2x10 : GPIO-2 (J13, entierement en
    reserve) et COM (J14, bus UAR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
2026-10-12 Decouplage 100nF sur les 6 nappes (3V3_ISO/GND)
    Un condensateur par connecteur (C29, C30, C34, C35, C42, C43), au plus
    pres de chaque embase - complement du decouplage par IC deja en place,
    pour que chaque nappe ait sa propre reserve locale avant la traversee du
    cable. Place manuellement par l'utilisateur dans l'editeur KiCad.
2026-10-12 Corrige ADC-2 (I_SHUNT1_CMP/I_SHUNT2_CMP) et protege 11 signaux nappe (decisions #18-19)
    ADC-2 ne cablait que la voie filtree (I_shunt1/I_shunt2) et oubliait le
    chemin direct comparateur que la decision #4 impose. Ajoute en
    consommant 2 des 6 reserves, sans adjacence avec la voie filtree (les
    deux chemins doivent rester independants).
    11 signaux cables en decision #17 n'avaient aucune protection
    (CLB_OUT, UART_TX/RX, SPI_CLK/SIMO/SOMI/STE, CAN_TX/RX, et les deux
    I_SHUNT*_CMP une fois ajoutes) alors que les 23 autres signaux du
    connecteur devkit en ont une. Nouvelle feuille protection_nappe.kicad_sch,
    11 trios copies depuis un trio reel (protection_devkit3.kicad_sch) plutot
    que redessines -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
2026-10-12 Placement PCB des 11 trios de protection nappe (Phase B, decision #19)
    Ajoute, miroir B.Cu et groupe les 11 trios BAT54S+R+C crees en
    Phase A (D25-D35/R24-R34/C44-C54), places pres de leurs connecteurs
    respectifs (ADC-2, GPIO-1, COM) a l'interieur du contour reel de la
    carte. DRC final : 0 copper_edge_clearance, aucune nouvelle
    violation imputable aux nouveaux designateurs (courtyards_overlap,
    clearance, shorting_items, npth_inside_courtyard verifies
    pre-existants par grep).
2026-10-12 Route les connexions internes des 11 trios de protection nappe
    Ajoute les 3 pistes par trio (1 GND, 2 signal _MCU) reliant D/R/C
    entre eux, meme motif que les trios existants (ex. D3/R1/C1).
    Pistes integrees aux groupes PROT_*_MCU deja crees. DRC :
    unconnected_items 324->291 (-33, exactement les 11x3 connexions
    routees), aucune autre categorie affectee.
2026-10-12 Corrige le court-circuit du trio I_SHUNT1_CMP/I_SHUNT2_CMP (devkit)
    Le connecteur devkit portait encore les labels bruts I_SHUNT1_CMP/
    I_SHUNT2_CMP au lieu de la forme _MCU (oubli lors de la decision #19,
    qui pretendait le contraire). Un global_label KiCad fusionnant par nom,
    cela court-circuitait silencieusement le trio BAT54S/R/C deja pose : le
    nom brut cote nappe et le nom (censement protege) cote MCU pointaient
    vers le meme noeud. Invisible a l'ERC (fusion de deux labels valides,
    pas une erreur de connectivite). Corrige en renommant les deux labels
    devkit en I_SHUNT1_CMP_MCU/I_SHUNT2_CMP_MCU.
    Necessite un nouveau "Update PCB from Schematic" : la synchronisation
    precedente a eu lieu pend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
2026-10-12 Deplace I_SHUNT1_CMP/I_SHUNT2_CMP d'ADC-2, positions 9/11 -> 11/13
    Position 9 etait adjacente a VREFLO_SENSE (position 8, deja hors de
    l'alternance stricte signal/masse en tant que paire de reference) sans
    masse entre les deux. Un signal inutilise (reserve) a cet endroit etait
    inoffensif ; I_SHUNT1_CMP (classe Rapide, comparateur, edges rapides)
    ne l'est pas - meme defaut de blindage que partout ailleurs sur ce
    connecteur. Deplace en 11/13, entourees de masse des deux cotes, comme
    I_shunt1/I_shunt2 en 3/5. Position 9 redevient reserve ADC2-1.
    ERC : memes categories/comptes qu'avant (34 pin_not_connected), pin 9
    desormais signale non connecte (attendu, reserve), pins 11/13 ne le
    sont plus pl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
2026-10-12 Supprime l'exception d'adjacence 7/8 sur ADC-2, alternance stricte partout
    Correction precedente insuffisante : deplacer seulement I_SHUNT1_CMP/
    I_SHUNT2_CMP (9/11 -> 11/13) laissait VREF_ADC/VREFLO_SENSE adjacents
    en 7/8 sans masse entre eux - une exception qui n'a plus lieu d'etre
    puisque leur lien electrique passe par le suiveur rail-to-rail du
    shield, pas par leur proximite sur la nappe.
    Nouveau brochage ADC-2, alternance stricte masse/signal, zero exception :
    3 VREFLO_SENSE, 5 VREF_ADC (etaient 7/8)
    7 I_shunt1, 9 I_shunt2 (etaient 3/5)
    11 I_SHUNT1_CMP, 13 I_SHUNT2_CMP (inchange)
    15/17/19 reserves (renumerotees 1-3, une reserve perdue dans l'echange)
    ERC : pin_not_connected 34-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
2026-10-12 Placement manuel des 11 trios de protection nappe sur le PCB
    Repositionnement a la main (GUI KiCad) des composants places/groupes
    par script en phase B, pour un agencement pratique pres de leurs
    connecteurs respectifs.
2026-10-12 CLB du F28P551 en mini-CPLD : report devkit, 4 trios, nappe logic (decision #20)
    - Report sur connecteur_devkit.kicad_sch (symboles + labels reels, lib
    externe incluse) du reseequencement devkit (Iin/Iout/V1/Temp1/Temp2/
    ADC_8-12/I_SHUNT*_CMP/I_SHUNT*_MES deplaces) et des 4 broches neuves
    (Stage1_EN=GPIO9, Stage2_EN=GPIO20, HV_EN=GPIO21, Discharge=GPIO41).
    - Corrige un erratum trouve en verifiant : protection_devkit3.kicad_sch
    gardait l'ancien nom nFAULT_MCU apres le renommage du connecteur en
    ~{FAULT_MCU}, coupant silencieusement le trio existant (meme categorie
    de bug que l'erratum ADC-2 de la decision #19).
    - 4 nouveaux trios de protection D36-39/R35-38/C55-58, R=10R (signaux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
2026-10-12 PCB : place, route et groupe les 4 trios Stage1_EN/Stage2_EN/HV_EN/Discharge
    Update PCB from Schematic (12 nouveaux footprints), miroir F.Cu->B.Cu
    un par un, places pres de J4 (nappe GPIO-1) et J13 (nappe logic),
    routage interne (1 masse + 2 noeuds _MCU par trio, meme motif que les
    34 trios existants), groupes PROT_<signal>_MCU.
    DRC : unconnected_items -12 (4 trios x 3 connexions), aucune nouvelle
    categorie de violation imputable aux nouveaux designateurs (D36-39/
    R35-38/C55-58) - verifie par grep, uniquement les memes categories
    cosmetiques deja presentes sur les 34 trios existants.
2026-10-12 NCM3S1205MC : empreinte et symbole remplaces par le modele telecharge SnapEDA (decision #21)
    Footprint (lib/NCM3S1205MC.kicad_mod + copies U2/U3 dans shield.kicad_pcb)
    repris du modele SnapEDA CONV_NCM3S1205MC-R7 (pastilles a +/-11.0mm),
    cotes confirmees par l'utilisateur contre la page 10 du datasheet Murata -
    l'ancien footprint fait main (decision #15) est remplace, pas seulement
    complete. Noms de broches repris cote symbole (-VIN/+VIN/+VOUT/-VOUT),
    position/longueur/type electrique inchanges pour ne pas desaligner les
    fils reels de dc.kicad_sch ni casser le role de driver implicite de
    +VOUT sur le net GND (verifie par ERC/DRC, categories identiques avant/apres).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
2026-10-12 NCM3S1205MC : ajoute le modele 3D officiel Murata (absent du bundle SnapEDA)
    Le modele telecharge SnapEDA ne contenait ni fichier STEP ni reference
    (model ...). Recupere directement depuis murata.com/en-us/products/power/3d
    (mps_dcdc_nmc3s_mc_a.step, famille de boitier NCM3S-MC complete), stocke
    dans lib/NCM3S1205MC.step et reference depuis le footprint (bibliotheque +
    les deux copies figees U2/U3 dans shield.kicad_pcb). DRC inchange (412
    violations, memes categories) - le modele 3D ne participe pas au DRC.
2026-10-12 Corrige 97 empreintes privees de modele 3D (bug des scripts de duplication passes)
    Signale par l'utilisateur sur un trio (D9/R7/C7 invisible en vue 3D vs
    D4/R3/C3 visible). Verifie sur les 158 footprints de shield.kicad_pcb :
    97 n'avaient aucun noeud (model ...), toutes issues des generations en
    masse par script au fil des sessions precedentes (trios protection_devkit*,
    protection_nappe, et meme R35-R38 de la decision #20 alors que leurs D/C
    jumeaux en avaient). Corrige en reprenant le noeud standard de chaque type
    (SOT-23 / R_0805 / C_0805) depuis les rescapes. DRC inchange (412
    violations, memes categories). Seule empreinte encore sans modele : U4
    (connecteur OLED custom), pas de modele st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
2026-10-12 ER-OLEDM032-1 : ajoute le modele 3D fourni (derniere empreinte sans modele)
    STEP fourni par l'utilisateur (lib/ER-OLEDM032-1.STEP), reference depuis
    le footprint et la copie figee U4 dans shield.kicad_pcb. Les 158
    empreintes de shield.kicad_pcb ont desormais toutes un modele 3D. DRC
    inchange (412 violations, memes categories).
2026-10-12 Corrige 45 footprints B.Cu dont la serigraphie/fab/courtyard restait sur la face avant
    Signale par l'utilisateur en vue 3D (groupe D4/R3/C3 correct vs groupe
    D9/R7/C7 absent). Verifie sur les 158 footprints : 45 montes en B.Cu
    (D25-D39/R24-R38/C44-C58, issus des generations en masse des decisions
    #19/#20) gardaient des elements F.SilkS/F.CrtYd/F.Fab au lieu de leurs
    equivalents B.*. Corrige par negation du Y local + permutation de
    couche, verifie element par element contre un trio correct (D36/R3/C3)
    avant generalisation. Script de verification reutilisable ajoute
    (check_mirrored_footprints.py, racine du workspace), et la methode
    KICAD-EDITION-GROUPEE-KIPY.md mise a jour (iterer sur tous les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
2026-10-14 Ajoute le filtre EMC FL3/FL4 (U3), corrige les caps de sortie 100uF et le rendu 3D du devkit/NCM3S1205MC
    - dc.kicad_sch : ajoute FL3/FL4 (Bourns SRF0905) sur le filtre EMC de
    U3, empreinte lib:Filter_Bourns_SRF0905_6.0x9.2mm_My
    - connecteur_devkit.kicad_sch : C36/C37 renommes C59/C60, passent en
    100uF 50V / CP_Elec_8x10.5 (electrolytique) au lieu du MLCC 1210 ;
    embases devkit en PinSocket (femelle) au lieu de PinHeader
    - connecteurs_nappe/protection_nappe.kicad_sch : complete les labels
    nappe manquants (Discharge, PWM3_B, PWM4_B, Stage2_EN)
    - lib/ER-OLEDM032-1.kicad_mod, lib/NCM3S1205MC.kicad_mod : corrige
    l'orientation/offset des modeles 3D (STEP mal aligne)
    - lib/DLW5BSZ801TQ2L.s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
2026-10-14 Ajoute l'alimentation USB-C Power Delivery des cartes filles (STUSB4531QTR)
    Nouvelle feuille usb_pd.kicad_sch : recepteur USB-C Wurth 632722100213,
    STUSB4531QTR (negociation PD autonome, 100W/20V/5A), MOSFET P
    SQJ459EP-T2_GE3 comme unique interrupteur de puissance (pas d'eFuse),
    protections TVS, 2 LED de statut, sortie vers les cartes filles en
    daisy chain. Supervision I2C par l'ESP32 (GPIO21/22/23), distincte du
    bus I2C des nappes qui reste au C2000.
    Deuxieme entree d'alimentation, separee du 11-25V existant. HV_EN et
    Discharge (nappe GPIO-1) ne sont pas reutilises : le STUSB4531QTR gere
    sa propre coupure/decharge en autonome. Decision #23 pour le detail
    complet (composants, justifications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
2026-10-14 Corrige le placement des labels Reference/Value sur usb_pd.kicad_sch
    Le script de generation empilait Reference/Value au-dessus/en-dessous
    du corps de chaque symbole (offset vertical fixe), ce qui chevauche les
    etiquettes globales posees sur les broches haut/bas - contraire a la
    convention de l'atelier (Reference/Value a gauche/droite, jamais
    au-dessus/en-dessous, espacement genereux entre composants).
    Corrige : Reference a gauche, Value a droite de chaque corps, avec un
    decalage dimensionne par type de symbole (assez grand pour degager les
    broches et le texte de nom de broche le plus long cote concerne).
    Grille de placement elargie en consequence (grille 5x5, pas 90mm/35mm)
    pour que meme l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
2026-10-14 Corrige le formatage des labels globaux sur usb_pd.kicad_sch (justify manquant)
    Chaque global_label portait une rotation (0/90/180/270 selon la broche)
    mais aucune propriete justify assortie - contraire au format etabli dans
    ce depot (decision #14, verifie sur 90+ labels reels de
    protection_nappe.kicad_sch) : rotation 0 ou 90 -> justify left, rotation
    180 ou 270 -> justify right, systematiquement, sur le label ET sur sa
    propriete Intersheetrefs. Purement cosmetique (ERC identique avant/
    apres, USB_PD toujours a 0 violation) mais le fichier ne respectait pas
    la forme du reste de l'atelier.
2026-10-14 Exclut PF1 (PWR_FLAG) du PCB - empreinte non assignee par design
    PWR_FLAG est un marqueur ERC virtuel (aucune piece physique, pas de
    footprint possible) mais son gabarit bibliotheque porte quand meme
    (on_board yes)/(in_bom yes) par defaut comme un composant normal.
    "Update PCB from Schematic" (F8) echouait donc dessus : "Ne peut
    ajouter le composant 'PF1' (empreinte non assignee)".
    Surcharge par instance : (on_board no)/(in_bom no) pour PF1 - jamais
    synchronise vers le PCB, jamais liste en BOM, reste actif pour l'ERC
    qui est son seul role. ERC feuille par feuille inchange (USB_PD
    toujours a 0 violation).
2026-10-14 Corrige l'orientation des labels sur usb_pd.kicad_sch - etaient inverses
    Root cause trouvee : le generateur utilisait l'angle local de la broche
    tel quel comme rotation du label (rot = la). Faux - l'angle de la broche
    decrit sa ligne partant du point de connexion VERS le corps ; le label
    doit au contraire pointer vers l'EXTERIEUR, dans la direction opposee
    (rot = la + 180). Verifie sur GPIO23/22/21 (connecteur_devkit.kicad_sch,
    broches angle local 0) dont la decision #14 documente la rotation
    correcte comme 180 (0+180) - exactement ce qui avait ete corrige a la
    main avant d'etre ecrase par une regeneration complete du fichier lors
    du fix precedent (PF1/PWR_FLAG). Justify recalcule en consequ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
2026-10-14 Documente les 3 bugs de labels (decision #24) et le verificateur associe
    Meme cause que la decision #14 : un script de generation reinvente une
    regle de placement deja etablie au lieu de relire la decision qui la
    documente. Pointe vers check_schematic_labels.py (racine du workspace)
    et KICAD-EDITION-GROUPEE-KIPY.md, ou la recette complete est deja ecrite.
2026-10-14 Remplace le connecteur devkit par le nouveau connecteur devkit_B (2x24/2x24)
    devkit_B_F28P551 est passe a deux embases 2x24 (une par domaine, masse
    en vis-a-vis de chaque signal pour reduire l'inductance de boucle),
    construit cote KICAD-C2000-devkit a partir du plan v2
    (doc/connecteur-v2-plan.md la-bas). Remplace DEVKIT_C2000_ROW_A/ROW_B
    (1x28 chacun) par DEVKIT_C2000_A/DEVKIT_C2000_B sur ce shield (J17/J18,
    footprint PinSocket_2x24_P2.54mm_Vertical).
    Remplacement pur : les 96 nouveaux noms de broche retombent tous dans
    la table deja construite depuis les 56 anciennes etiquettes reelles
    (verifie, pas suppose) - aucun renommage de net, aucune modification
    attendue dans les nappes/protections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
2026-10-16 Resauvegarde session KiCad GUI (placement, empreintes USB-C/STUSB4531, PCB)
    Checkpoint avant l'ajout des connecteurs dedies carte HV/Filament -
    capture l'etat courant de la session KiCad ouverte (reformattage
    eeschema, ajustements d'empreinte sur 632722100213 et STUSB4531QTR,
    mises a jour PCB/projet) avant toute edition programmatique.
2026-10-16 Ajoute les connecteurs dedies carte HV et carte Filament (HT)
    Ecart assume a la decision #17 : ces deux premieres cartes filles ont
    plus de signaux que les reserves des six nappes partagees n'en offrent
    (ADC-2: 3 reserves, GPIO-1: aucune). Chaque carte recoit son propre
    connecteur IDC 2x10 sur une feuille dediee, en plus des six nappes.
    - connecteur_carte_hv.kicad_sch (J19/J20) : tous les signaux repris
    sont deja proteges ailleurs, aucun composant neuf.
    - connecteur_ht.kicad_sch (J21) : les 5 voies ADC_8-12 du devkit,
    posees depuis le debut mais jamais cablees, sont enfin affectees
    (Vht/Temp_ht/I_Shunt_ht/I_Shunt_ht_comp/V_bias) via 5 nouveaux trios
    de protection (gabarit existant,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
2026-10-16 Espace les composants de protection sur connecteur_ht.kicad_sch (anti-chevauchement)
    Les 5 trios R+BAT54S+C (Vht/Temp_ht/I_Shunt_ht/I_Shunt_ht_comp/V_bias)
    se chevauchaient visuellement (BAT54S empietait sur R et C). Repris au
    style defini par l'utilisateur sur le trio Vht : composants en
    rotation 90 (horizontal), ~15mm entre les corps, relies par fil+jonction
    plutot que par coincidence de label pour les connexions internes locales
    au trio (exception documentee au style labels-only, juste pour ce
    regroupement physique).
    Verifie : check_schematic_labels.py propre, ERC Connecteur_HT toujours
    a 0 violation.
2026-10-16 Isole la liaison ESP32<->STUSB4531 (ISO1640BD + DPC817), USB-PD rejoint GND_PRI
    Le bus de supervision I2C/ALERT (STUSB_SCL/STUSB_SDA/STUSB_ALERT) reliait
    directement GPIO22/23/21 aux pins de U1, sans isolation. Isole avec :
    - ISO1640BD (TI, 8-SOIC, isolation basique 3000VRMS) pour SCL/SDA -
    symbole dessine a la main (absent des bibliotheques stock), empreinte
    SOIC-8 standard.
    - DPC817 (optocoupleur, NRND mais empreinte generique standard 4 broches)
    pour ALERT - brochage repris du symbole stock PC817, empreinte SL-4
    dessinee a la main (aucune empreinte stock ne correspondait).
    Reutilise les pull-ups existants R45/R46/R47 (4,7k vers 3V3_ESP32) comme
    cote Side 1 de l'isolateur, simplem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
2026-10-16 Respace les composants d'isolation sur usb_pd.kicad_sch (anti-chevauchement)
    ISO1640BD/DPC817/R55/R56/R57 etaient positionnes par coincidence de pin
    uniquement (connexions par coordonnee), sans tenir compte du corps des
    composants : certains se touchaient (ecart nul), aucun n'avait les 15mm
    demandes. Deplaces dans une zone vide de la feuille (sous le contenu
    existant), connexions refaites entierement par global_label nomme (plus
    de contrainte de coincidence physique) - verifie programmatiquement que
    les 10 paires de composants neufs ont toutes >= 15mm d'ecart entre corps.
    ERC identique a avant (meme diff attendu), rien de casse par le deplacement.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
2026-10-17 Remplace DPC817 (NRND, empreinte maison) par TCMT1100 (Vishay, standard)
    U7 passe d'un optocoupleur Diodes Inc. en boitier SL-4 fait main a un
    TCMT1100 Vishay dont le symbole ET l'empreinte (SOP-4_4.4x2.6mm_P1.27mm)
    sont stock KiCad - brochage identique, aucun rewiring necessaire.
    Footprint PCB reconstruit a la main via kipy (pads, silkscreen,
    courtyard, contour fab, identite de librairie). Route et groupe aussi
    les 5 nouveaux trios de protection ADC (D44-48/R50-54/C66-70) en
    copiant le gabarit des trios existants, et uniformise a 0,5mm toutes
    les pistes internes des 43 groupes PROT_*.
    Decision #28 dans doc/decisions.md.
2026-10-18 Ajoute les connecteurs carte fille HT, corrige un modele 3D casse, partage TO252
    - Nouveaux connecteurs/nappes pour la carte fille HT (connecteur_carte_hv,
    connecteur_devkit, connecteur_ht, connecteurs_nappe, protections_*) --
    travail deja en place localement, jamais commite ; voir
    rajout-connecteurs-cartefille.{csv,txt,xlsx} et alimentation-usbC.txt
    pour les notes associees.
    - Filter_Bourns_SRF0905_6.0x9.2mm_My.kicad_mod : modele 3D mort supprime
    (chemin KICAD10_3DMODEL_DIR inexistant dans l'install KiCad 10 locale,
    doublon du modele local DLW5BSZ801TQ2L.step deja correct).
    - 632722100213.kicad_mod / NCM3S1205MC.kicad_mod : commentaire descr mis
    a jour (source deplacee de comp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
2026-11-01 Met a jour l'etat d'avancement PCB (207 empreintes, routage ~10%)
    Le README indiquait encore 85 empreintes et 0 piste/via -- en retard sur
    l'etat reel du fichier (207 empreintes posees, routage commence depuis).
2026-11-01 Migre les logos vers lib_fp_commun, ajoute usb_pd.kicad_sch et les marqueurs 3D ESP32/devkit_B
    Logos lebel deplaces vers lib_fp_commun/artwork.pretty (et Symbol_commun/
    Graphic enregistres) -- fp-lib-table mis a jour, lib/lebel-logo*.kicad_mod
    et lib/lebel_logo.kicad_sym retires du depot, suit la convention KICAD.md.
    J21 (carte Filament) : symbole NAPPE_FILAMENT_HT renomme en valeur DC_HT,
    ADC_10 reaffecte de Temp_ht a I_Out_ht (mesure de temperature primaire
    retiree cote KICAD-HT, remplacee par le courant de sortie reel).
    Nouvelle feuille usb_pd.kicad_sch (alimentation USB-C PD des cartes
    filles).
    MECH1/MECH2 : marqueurs mecaniques sans pastille ni connexion, portant
    chacun le modele 3D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
2026-11-01 Remplace la section alimentation NCM3S1205MC par l'USB-C PD des cartes filles
    Decrit le STUSB4531QTR (entree 100W/20V/5A separee du 11-25V, decision
    #23) et la supervision par l'ESP32 via le bus I2C isole (ISO1640BD,
    decision #27) -- sujet absent du README jusqu'ici malgre l'ajout de
    usb_pd.kicad_sch.
2026-11-01 Relie J10 pin 7 (OLED, NC) a GND
    Label global GND pose sur la broche 7 de l'embase OLED (meme style que
    la broche 8 adjacente), broche jusque-la laissee en NC par prudence
    (decision #15, plan constructeur muet sur cette broche). Decision
    explicite de l'utilisateur, point ouvert retire de decisions.md et du
    README. no_connect_connected attendu en ERC (pin toujours typee NC dans
    le symbole), documente comme accepte.
2026-11-03 U2/U3 NCM3S1205MC : cablage entree/sortie corrige (etiquettes inversees)
    Les etiquettes globales posees sur les 4 broches de U2 et U3 reliaient
    chacune le net oppose a sa vraie fonction (1=-VIN sur le net destine au
    +, etc.), decouvert en revue car l'ERC pin_to_pin sur la broche 3
    (deux Power output connectes) etait pris a tort pour un choix accepte
    en decision #21(b). Preuve physique : datasheet Murata KDC_NCM3 p.10
    (vue de dessous, tailles de pastilles, ordre antihoraire) + chemin reel
    J9 -> VIN_PWR -> FL3/FL4 -> U2_VINF/U3_VINF confirmant VINF/GNDF comme
    +/- d'entree. Correction par permutation du texte des 8 etiquettes
    globales uniquement (positions, symbole, empreinte inchanges) :
    U2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
2026-11-03 Retrait du lib_name orphelin NCM3S1205MC_1 de U2, hygiene du symbole
    U2 referencait une copie locale detachee du cache (lib_name
    "NCM3S1205MC_1", contenu identique a Power_Parts:NCM3S1205MC) au lieu
    de la bibliotheque partagee comme U3 : sans effet aujourd'hui, mais U2
    n'aurait pas suivi une future mise a jour via "Update Symbol from
    Library". Jamais committe (apparu et reapparu uniquement dans l'arbre
    de travail au fil des sessions KiCad de ce jour) ; absent ici par
    construction.
    Dans le meme lot, residus cosmetiques de l'edition du symbole dans
    l'editeur KiCad : numeros de broches masques, champs Datasheet/
    Description des instances U2/U3 remplis (etaient vides) et masques,
    positionnement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
2026-11-03 PCB : nets U2/U3 mis a jour apres correction du cablage (#30)
    Mise a jour PCB depuis schema (F8) suite au commit 22663de. Pastilles
    U2/U3 reassignees : 1->U2_GNDF/U3_GNDF, 2->U2_VINF/U3_VINF,
    3->5V_ISO/5V_NUM, 4->GND (numeros/empreinte inchanges). U2/U3 non
    routes a ce stade (decision #21(a)) : aucune piste/zone concernee.
    kicad-cli pcb drc : 464 -> 463 violations ; seule la categorie
    lib_footprint_issues (avertissement sans rapport, librairie 'artwork')
    disparait. Les 14 clearance/7 shorting_items/7 solder_mask_bridge
    touchant les pads U2/U3/C27/C28/C36 sont strictement identiques avant
    et apres (non routes, la reaffectation de net ne change aucune piste).
2026-11-03 decisions.md : entree #30, cablage invert de U2/U3 (NCM3S1205MC)
    Documente le defaut reel trouve en revue (entree et sortie inversees,
    commits 22663de/23b5b2a/6904387), la preuve physique (datasheet page
    10, chemins entree et retour), la rectification de lecture de #21(b)
    (le pin_to_pin ERC etait le symptome, pas un choix), le piege de la
    premiere tentative de correction (comparer empreinte/symbole ne prouve
    rien), et la verification complete (ERC, netlist, PCB/DRC).
2026-11-08 Documente l'usage mono-point-d-acces des nappes ; integre les retouches GUI et la revue de schema
    - doc/nappes-shield.md : precise qu'une carte fille cable un seul point
    d'acces a la fois (connecteur dedie OU nappe generique dupliquee),
    jamais les deux simultanement pour le meme signal -- consequence
    directe sur le budget de courant 3V3_ISO (pas de double comptage).
    - connecteur_devkit.kicad_sch, usb_pd.kicad_sch : reordonnancement/
    repositionnement mineur issu de l'editeur graphique (pas de
    changement electrique).
    - lib/Power_Parts.kicad_sym : resauvegarde depuis l'editeur de
    bibliotheque (pas de nouveau symbole).
    - doc/revues/revue_schema_2026-11-02.md, revue_schema.yaml,
    doc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
2026-11-10 Distribution 3V3_ISO sur 5 LDO dedies, protections reorganisees, isolation GND/GND_PRI
    Remplace le regulateur 3V3_ISO unique partage par les 9 nappes par une
    distribution sur 5 regulateurs independants : U1/D1 existant specialise
    sur HT, 4 nouveaux TLV76133 (feuille 3v3_iso.kicad_sch, caracterises
    dans composants-datasheets) couvrent HV/ADC/LOGIC/PWM, chacun avec sa
    zener de protection et sa resistance de detection de panne par nappe.
    Elimine le point de defaillance commun identifie par le budget de
    courant HV/HT (~125mA sur HV seule).
    Reprend les 43 diodes Schottky de protection (BAT54S), auparavant
    toutes clampees sur un rail 3V3_PROT orphelin (aucune source), pour
    qu'elles referencent di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
2026-11-10 Routage 4 couches termine, reference VREF_ADC repartie sur J20, protection D11 sur sortie ampli-op
    Point d'acces VREF_ADC ajoute sur J20 (broche reserve NAPPE_HV_DIO), via R70
    remplacant R10 entre VREFHI du C2000 et l'entree du suiveur U8. D11 protege
    la sortie directe de U8 (Net-(U8--)), choix delibere de l'utilisateur.
    min_resolved_spokes abaisse a 1 (frein thermique), padstack remove_unused_layers
    applique a tous les connecteurs. Routage PCB complet sur les 4 couches.
2026-11-10 DRC propre : min_through_hole_diameter/min_text_height ajustes, ilots de cuivre et piste 3V3_ISO_GPIO resolus
    Regles projet mises en coherence avec le routage reel : trou mini 0,3mm
    (vias multiplies pour la puissance plutot qu'un via unique large) et texte
    serigraphie mini 1,0mm (valeur deja universelle sur le projet, jamais
    reellement a 1,2mm). Remplissage de zone + routage manquant corriges cote
    utilisateur. DRC final : 35 violations, 0 non-connecte.
2026-11-11 Finalise BOM : D41 a Z3SMC24, empreinte PinSocket 1x02 pour J16 (alim sortie cartes filles)
    Passe BOM complete : 240 groupes, 0 ecart restant (valeurs, empreintes, DNP).
    D41 alignee sur D40 (meme zener de protection, cote VBUS_OUT). J16 (sortie
    alimentation USB-PD vers cartes filles, VBUS_OUT/GND) recoit son empreinte
    definitive. DRC/ERC verifies propres au prealable.
2026-11-11 14 points de test ajoutes : Value = nom du net, reference masquee, nom affiche sur F.Silkscreen
    Points de test sur les rails d'alimentation (VIN_PWR, GND, GND_PRI, 5V_ISO,
    5V_NUM, 3V3_ISO et les 4 regulateurs distribues HV/ADC/LOGIC/PWM), le bus
    I2C (SCL_MCU/SDA_MCU), VREF_ADC et VBUS_OUT. Modele applique a partir de
    TP1 (deja configure) : reference cachee, valeur du net visible sur F.SilkS.
2026-11-11 README : routage 100% sur 4 couches, decompte des decisions a jour (15->30)
    Etat d'avancement actualise (PCB routage, DRC, points de test) et le
    nombre de decisions documentees dans doc/decisions.md.
2026-11-11 Remplissage manuel GND sur B.Cu (ajout de vias)
    Avant via-stitching automatise GND/GND_PRI.
2026-11-11 Via-stitching GND et GND_PRI, pourtour puis grille interieure (quinconce 20mm)
    39 vias (25 GND, 14 GND_PRI), 0,6mm/0,3mm. Candidats filtres contre
    pastilles/pistes/vias/zones d'exclusion, marge 3mm entre GND et
    GND_PRI (regle isolement_gnd_gndpri). Pilote sur 3 vias avant
    generalisation : 2 cas ecartes (un via severait un doigt de la zone
    3V3_ISO_HT, un autre tombait trop pres d'un coin de la zone GND_PRI
    hors du cuivre reellement rempli) - retrait du perimetre augmente
    de 1,0 a 1,8mm en consequence. DRC final identique au depart (33
    violations, 0 non connecte). Positions loguees dans
    doc/stitching-shield.csv.
2026-11-11 ERC powershield : 47 erreurs -> 0, nettoyage cible par categorie
    - pin_to_pin (TLV76133 U10-U13) : broche 4 (tab SOT-223) Power output
    -> Passive dans le symbole, au lieu d'un faux conflit "deux sorties".
    - power_pin_not_driven (18 nets) : PWR_FLAG pose sur chaque rail dont
    la source reelle existe mais est separee par un composant passif
    (resistance serie, filtre EMC) ou vient d'une carte externe
    (devkit/ESP32) - verifie net par net via export netlist avant de
    poser, aucun cablage modifie (diff netlist confirme : seul le pin
    du PWR_FLAG s'ajoute a chaque net).
    - pin_not_connected / pin_not_driven (24 broches) : No Connect pose
    sur les broches de reserve des nappes et les GPIO E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
2026-11-11 J10 pin 7 (OLED NC) : no_connect -> passive, cohérent avec le GND voulu
    La broche etait typee "no_connect" dans le symbole OLED_SPI_2x8 alors
    qu'elle est volontairement reliee a GND (commit 057ac6a) - l'ERC
    signalait no_connect_connected en consequence. Type corrige dans
    lib/C2000_Devkit_Connectors.kicad_sym et son cache embarque. Un
    second "pin 7" homonyme (GND, type different) existe ailleurs dans le
    meme symbole, non touche. Diff netlist : la broche quitte le net
    synthetique "unconnected-..." et rejoint GND, aucun autre changement.
    ERC : 1 avertissement restant (TCMT1100, divergence documentee
    volontaire, a exclure depuis l'ERC de KiCad).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
2026-11-11 2 pastilles TP15/TP16 pour liaison haute impedance GND/GND_PRI (>=2 MOhm)
    Ajoutees par l'utilisateur (footprint TestPoint_Pad_D2.5mm), positionnees
    a la frontiere des zones GND_PRI/GND. Net non assigne pour l'instant -
    destinees a recevoir une resistance externe (bodge), pas une piste
    routee dans ce lot.
    Le resave KiCad qui accompagne ce commit reordonne/reformate aussi le
    contenu des schemas deja commite (PWR_FLAG, No-Connect, exclusion
    TCMT1100 ajoutee par l'utilisateur) - verifie : ERC et DRC identiques
    avant/apres (0 erreur ERC, 33 violations DRC inchangees, 0 non
    connecte), aucune perte de contenu.
